shapeoko/Docs/content/index.md

#Assembly Overview

##Welcome!

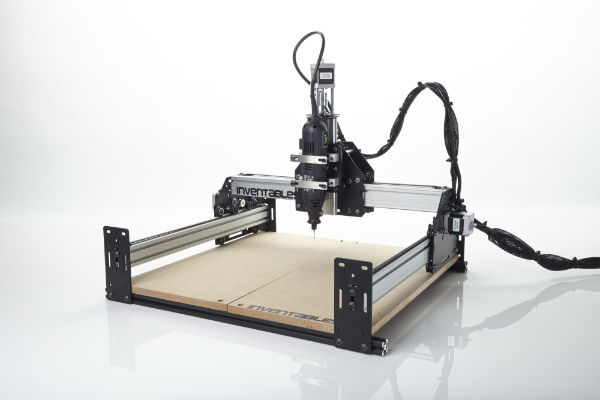
[picture p24: content/tPictures/shapeoko_2.jpg]
glamour photo of ShapeOko 2 front right diagonal


Thank you for being involved in Project Shapeoko, an open source CNC machine which may be used for milling, lasercutting, 3D printing, cutting fabric, etc. 

This is the site for the Shapeoko 2 instructions. For other versions, including the Shapeoko 3, [please see the wiki which includes documentation and assembly instruction and other information for the project.](http://www.shapeoko.com/wiki/index.php/Main_Page)

The Shapeoko 2 has a 12" x 12" x 2.5" work volume that can be [enlarged](http://www.shapeoko.com/wiki/index.php/Scaling_Up) and a stock precision of 1/40mm along X and Y, 1/320mm along Z.

ShapeOko is named after the **Shape**ways 3D printing and the Pon**oko** laser cutting services and was initially launched on [Kickstarter](http://www.kickstarter.com/projects/edwardrford/project-shapeoko-a-300-complete-cnc-machine?ref=live).

The following pages are filled with the information you need to assemble your Shapeoko 2 desktop CNC machine. Please read through them in advance, and make note of things to check and verify before beginning assembly. If you have any difficulties with assembly, please check the ShapeOko [wiki](http://www.shapeoko.com/wiki) and [forums](http://www.shapeoko.com/forum/index.php).

###A note on diagrams

Where possible, diagrams and illustrations are linked to larger versions which should fill your browser window. Most of the parts diagrams are in SVG format which will allow you to magnify them if using a tablet which supports such. When the SVG diagrams are opened in a browser window, they are interactive --- clicking on the parts list text will highlight the matching part(s) in the diagram). Please note that each SVG diagram comes in two versions, one intended for viewing *in situ* at a typical size, the other, with a suffix of "-100" which is set to fill a browser window --- each image's link is of course to that latter version.

**Please note:** there is a page on [assembly troubleshooting](http://www.shapeoko.com/wiki/index.php/Assembly_troubleshooting) on the wiki. If you've followed the instructions and nothing seems to match up on the wiki, please contact [help@inventables.com](mailto:help@inventables.com) and they will help you get everything sorted.

###A note on safety

_Never operate the machine without adequate safety gear for the current task. Never reach into the machine's operating envelope while it is running. Always have a means of safely disabling the machine's motion and spindle. Never leave the machine operating un-attended. There is an [operating checklist](http://www.shapeoko.com/wiki/index.php/Operating\_Checklist) which should always be followed._

##Getting Started

Please read through the assembly instructions in their entirety. If you have any questions or concerns or problems, please post a question on [the project forum](http://www.shapeoko.com/forum/viewforum.php?f=10). Lots of people, from diverse backgrounds, many with no prior CNC or woodworking or machining experience have successfully assembled and operated machines. Like most things in life, what one gets out of it, reflects the effort and preparation and patience which one exerts.

It might be helpful to watch an [assembly video](https://www.youtube.com/watch?v=42wzq5vG5rU) (also linked to from the [wiki](http://www.shapeoko.com/wiki/index.php/ShapeOko_2#Assembly_Video)) --- there are a number of others, some of which are on the [Hello World](http://www.shapeoko.com/wiki/index.php/Hello_World) page.

###Overview

1. Review the parts in your kit and make sure you have read and understand and will be able to follow all of the instructions
2. Read the [Pro Tips](tips.html) and make sure you have all the required [Tools](tips.html#Tools)
3. Install your [Software](software.html)
4. Test Your [Electronics](electronics.html)
5. Review the [Wiring Options](wiring.html)
6. Assemble your machine ([Wheels](wheels.html), [Carriages](carriages.html), [Z-axis](zaxis.html), [Gantry](gantry.html), [Y-axis](yaxis.html), [Work Area](workarea.html), and [Electrical Wiring](wiring.html))
7. Run [Hello, World!](helloworld.html)
8. Run your [First Job!](firstjob.html)

###Contributing

If you are interested in contributing to the docs pages, please see [this page](contribute.html) for information on how to get started.

##Assembly Steps

The first thing to do is to compare what you have received with the inventory sheet included with your kit. For reference, there is also a [B.O.M. (Bill of Materials) with sortable columns and (some) options on the wiki](http://www.shapeoko.com/wiki/index.php/BOM). Please note that part specifications / sizes may change with different kit batches, especially for aspects which do not affect functionality and fit. Also, any bags which don't have a part number and quantity should be sorted out and matched against the B.O.M. and [parts pages](http://www.shapeoko.com/wiki/index.php/Parts). Please compare one part to another (especially the MakerSlide) and check the instructions for specific things to check. If anything in your kit is found to be missing, or damaged, or not up to spec after your initial review, contact [Inventables Customer Service](https://www.inventables.com/about): [help@inventables.com](mailto:help@inventables.com) to make arrangements all-at-once for everything, so that one doesn't have to wait on multiple shipments.

If your electronics vary in any fashion from the standard parts, it is your responsibility to ensure that one doesn't damage the electronics. Please review the [Parts page on the wiki](http://www.shapeoko.com/wiki/index.php/Parts) and any other relevant documentation which is necessary for the parts which you have sourced.

##Software
[Goto the Instructions](software.html)

Before we can control our machine, we need to install and/or configure some software. If you're going to test your electronics, then you'll need to have this step done before you can complete that step. Otherwise, you'll need to complete this step before running Hello, World.

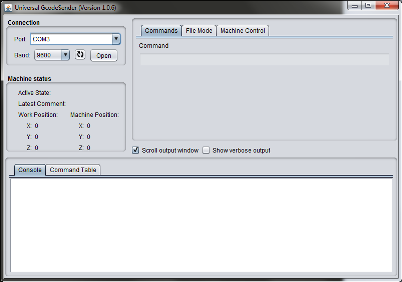
[picture p25: content/helloworld/ugs1_4.png]
Universal GCode Sender


---

##Electronics
[Goto the Instructions](electronics.html)

In this step, we will *test* our electronics setup. It's beneficial to do this prior to assembling the machine, as some issues are more easily addressed before assembly takes place. If a problem were to occur, it's much easier to troubleshoot without having to disassemble the machine!

Electronics Overview Image

---

##V-Wheels and Idlers
[Goto the Instructions](wheels.html)

A lot of the "work" required to assemble the machine is done in this step. It's not hard work, but it'll take a while. Just like long division.

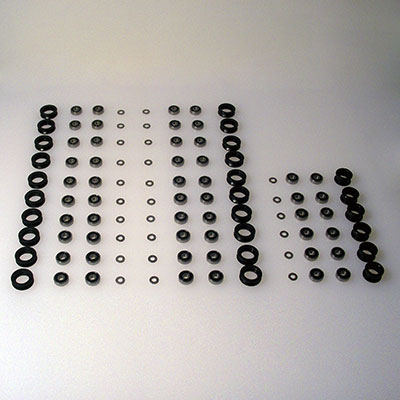
[picture p26: content/tPictures/so_vw_iw_parts_4.jpg]
wheels and idlers laid out


---

##Carriages
[Goto the Instructions](carriages.html)

This is the most labor intensive part of the assembly. You will be assembling 3 motor mount plates. Please note that before finishing this step, you must decide which wiring option you will use.

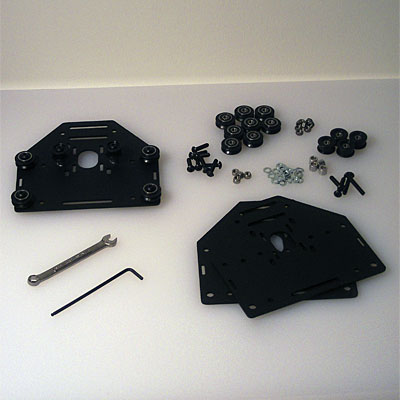
[picture p27: content/tPictures/so_motor_mount_carriages_parts_4.jpg]
exploded view of carriage


---

##Z-Axis
[Goto the Instructions](zaxis.html)

The Z-axis is comprised of 3 separate assemblies, and will require some time (and patience) to fully assemble. It will also require that you have begun tapping the MakerSlide (see the [Pro Tips](tips.html)). Once you are done with this step, your machine will really start to take shape.

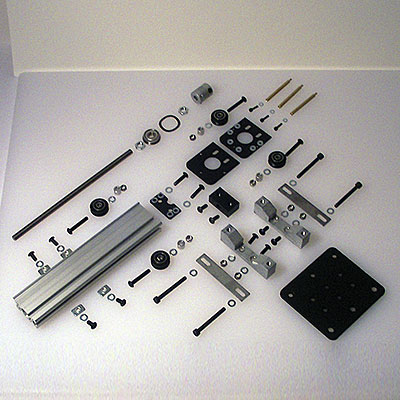
[picture p28: content/tPictures/so_z_axis_parts_4.jpg]
z-axis exploded


---

##Gantry
[Goto the Instructions](gantry.html)

The gantry continues the process of taking assemblies and combining them. You will have needed to finish tapping two pieces of MakerSlide before beginning this step.

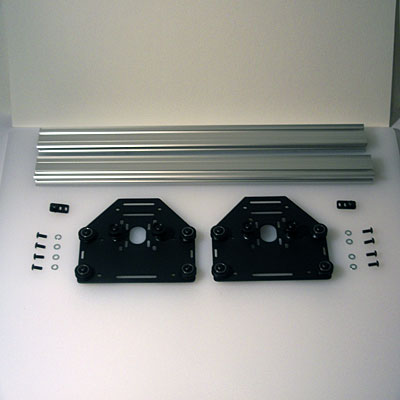
[picture p29: content/tPictures/so_gantry_parts_4.jpg]
Gantry Image


---

##Y-Axis
[Goto the Instructions](yaxis.html)

The Y-axis makes up the frame of the machine along with the last component in the next step. You will have needed to finish tapping the last two pieces of MakerSlide before beginning this step.

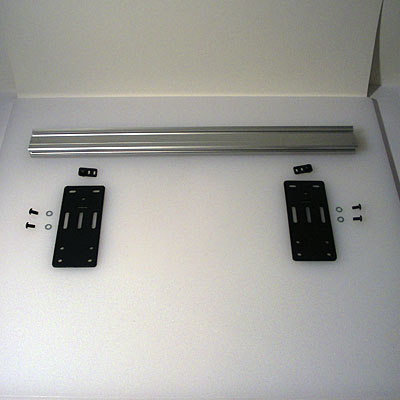
[picture p30: content/tPictures/so_y_axis_rail_parts_4.jpg]
Y Axis Image


---

##Work Area
[Goto the Instructions](workarea.html)

The work area integrates the last component with the previous assemblies, completing the mechanicals of the machine.

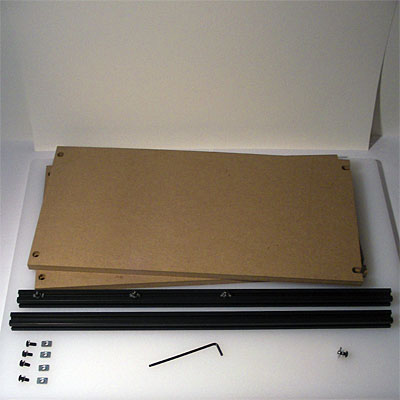
[picture p31: content/tPictures/so_waste_board_parts_4.jpg]
Work Area


---

##Electrical Wiring
[Goto the Instructions](wiring.html)

The machine is complete when the electronics are wired up to the motors, and the belts are installed, allowing movement. One must make a decision about which wiring option one will use before beginning to assemble the machine.

---

##Hello, World
[Goto the Instructions](helloworld.html)

Your very first run!

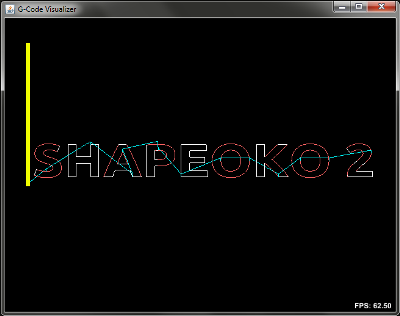
[picture p32: content/helloworld/ugs_visualize_4.png]
Hello World


---

##First Job
[Goto the Instructions](firstjob.html)

A basic introduction to using the machine for milling.

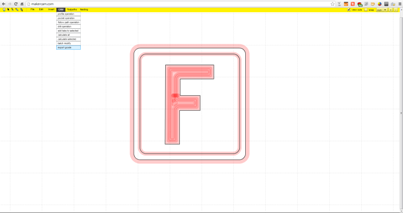
[picture p33: content/firstjob/mc_export_4.png]
first job


###Next step [Pro Tips!](tips.html)

To express concerns, post on the [forums](http://www.shapeoko.com/forum/index.php) in a suitable topic.
