shapeoko/Docs/content/oPictures/so_gantry_half_carriage_parts.JPG

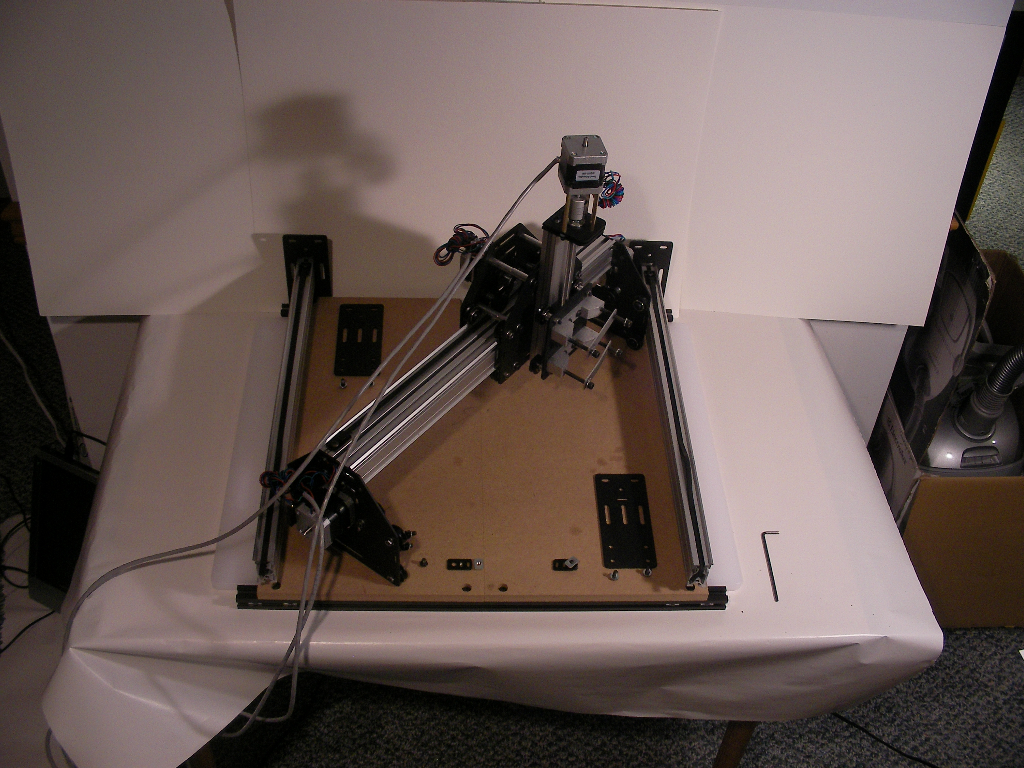
content/oPictures/so_gantry_half_carriage_parts.JPG
