shapeoko/Docs/content/oPictures/so_gantry_parts_tool.JPG

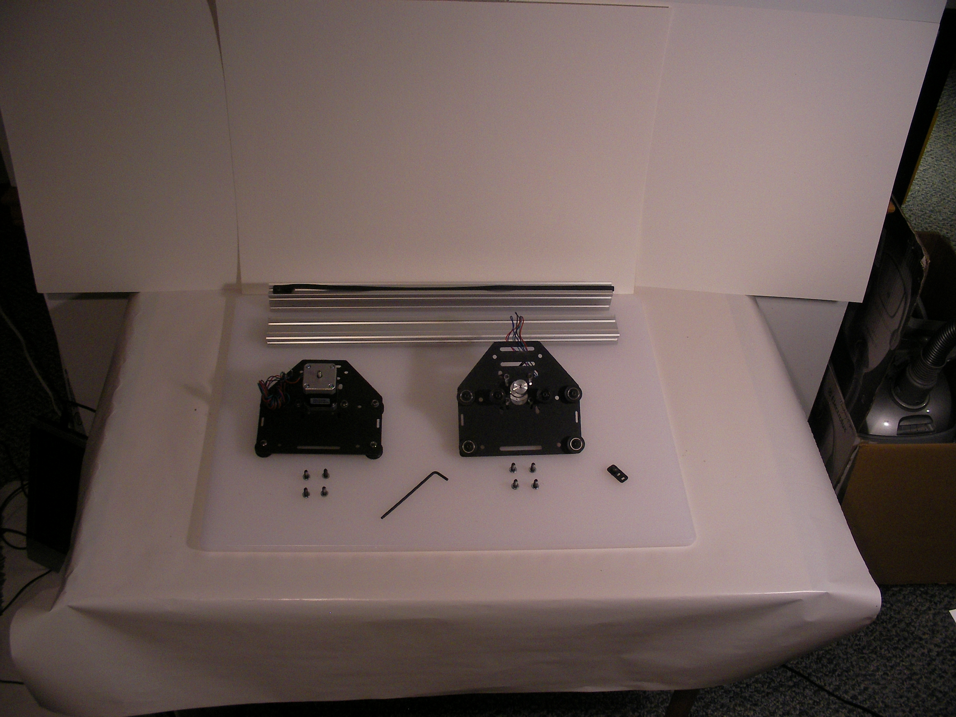
content/oPictures/so_gantry_parts_tool.JPG
