shapeoko/Docs/content/oPictures/so_wasteboard_y_axis_parts.JPG

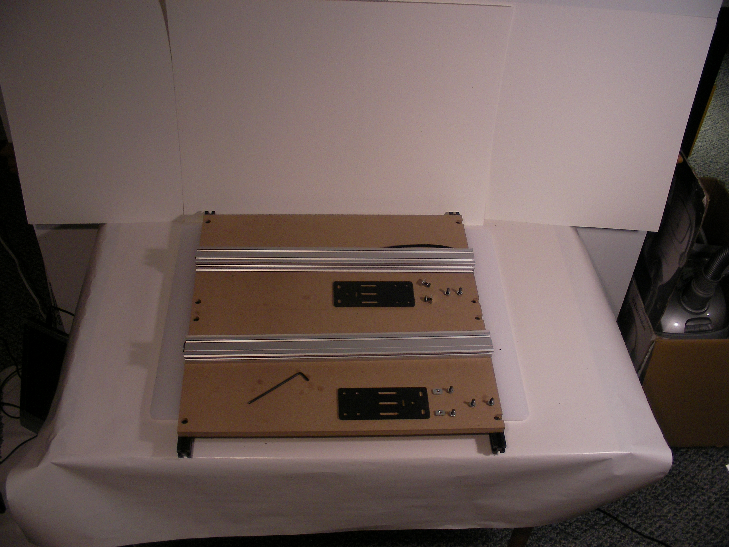
content/oPictures/so_wasteboard_y_axis_parts.JPG
