shapeoko/Docs/content/tPictures/so_motor_mount_carriage_parts_16.jpg

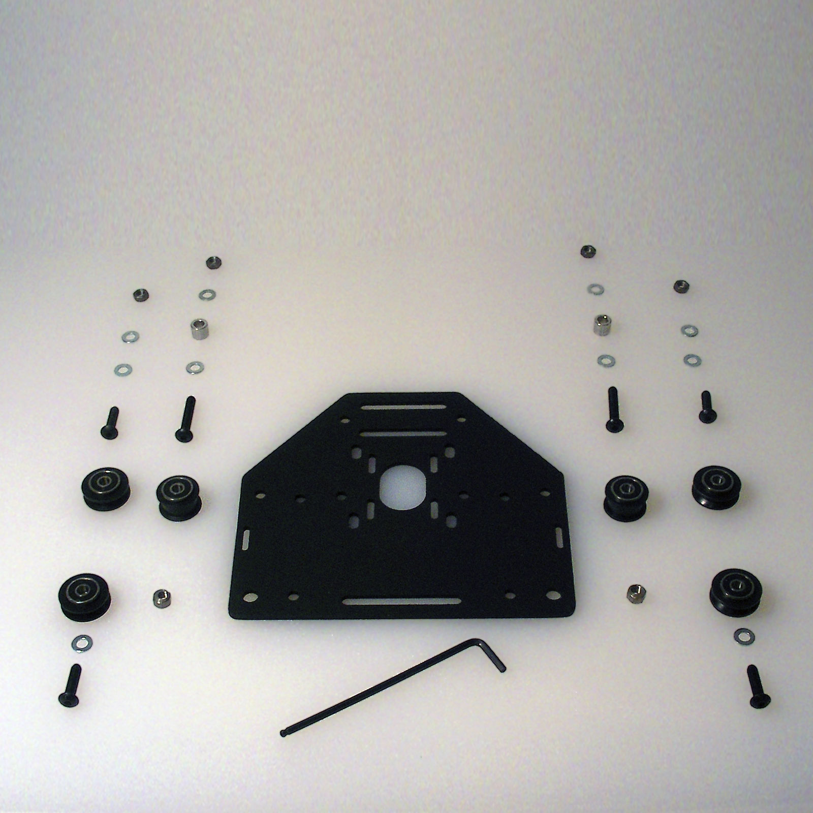
content/tPictures/so_motor_mount_carriage_parts_16.jpg
