shapeoko/Docs/content/tPictures/so_wiring_terminalblocks_parts_8.jpg

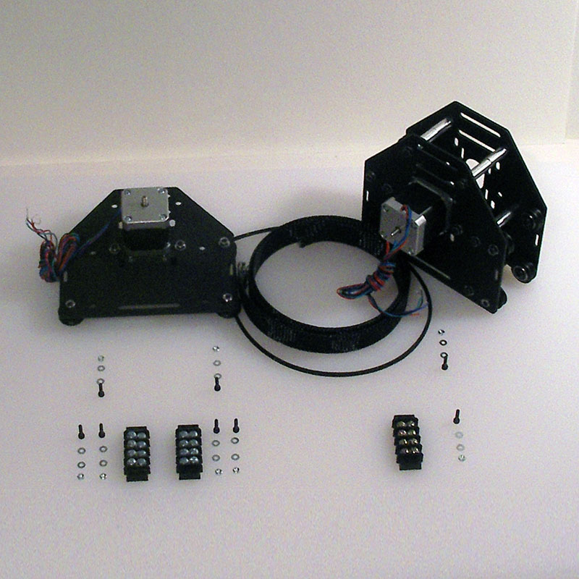
content/tPictures/so_wiring_terminalblocks_parts_8.jpg
