shapeoko/Docs/content/wiring.md

# Electrical Wiring

## Overview

schematic

The ShapeOko 2 electrical wiring is, like the rest of the machine, decided upon by the user. There are 3 documented options to wire the machine easily. Each option has been broken out into a separate page for clarity. Depending on your setup, and skill set, one option may be better for you than another (or you may want to work up a totally different option which is suited to your needs --- one word of warning, you will see photos of machines which have terminal blocks or wiring directly connected to the stepper motors --- this is potentially unsafe, since the motors may heat up to the point of deforming the plastic of the terminal block allowing a wire to come loose). 

Chose your option by evaluating the requirements of your machine, its ultimate size ([if scaling up](http://www.shapeoko.com/wiki/index.php/Scaling_Up)), how you intend to use it and your skill-set and available tools and aesthetic. While the default ShapeOko 2 size can make use of expandable braiding to manage the wiring, you may wish to look at other [cable management options](http://www.shapeoko.com/wiki/index.php/Cable_Management).

If you tested your electronics with terminal blocks it might suffice to merely detach the grey stepper motors from them, but it would probably be better to disconnect them completely, check the wiring carefully and re-strip any leads with broken wires.

**Remember, stepper driver chips are fragile and may be damaged by applying power without a motor connected --- always wire things up completely, and verify all connections each time before applying power.**

## Routing

In all scenarios, your stepper wires should be initially be routed as such:

wire facing up

Please note that the Z-axis leads should come down to the X-axis motor mount carriage so as to minimize the wear on the connectors and to begin consolidating the wires.

Be careful when making connections to not confuse leads from one motor with another, especially when wiring up the reversed Y-axis.

The motor lead wiring is very fragile --- even if you have a lead connected and secured, consider the possibility that the wires may break resulting in faulty connections. Always verify the integrity of all connections (and mechanical connectors) before operating the machine.

---

## Option #1 - Soldering

This is the direct wire method that requires (modest) soldering skills to complete (and stepper motors with leads long enough to make a run all the way off the machine). You can assemble the entire machine before doing this step.

###You will need the following tools and parts to complete this option

* Soldering Iron
* Solder
* Wire Strippers
* Heat Shrink Tubing (2 sizes) (or electrical tape)
* Heat source (heat gun or (hair) blow dryer)
* Zip Ties (about a dozen)
* 4 Position Terminal Block (optional)
* Expandable braiding (2 sizes), optional

[click here to view these instructions](wiring_1.html)

## Option #2 - Terminal Blocks

This is the terminal block method. This method is easy (no soldering or other special skills), but requires that you make preparations **WHILE** you are assembling the machine (attaching the terminal blocks to the carriages), or come up with some alternative technique for mounting the terminal blocks. While it is possible to attach the terminal blocks after assembly, it is very difficult and potentially frustrating, far better to do it in advance. It is especially well-suited for machines which will be scaled up in size, or for motors which have short leads.

###You will need the following tools and parts to complete this option

* Screw Driver
* Zip Ties
* Expandable Braiding
* Heat shrink tubing
* Heat source (heat gun or (hair) blow dryer)
* 4 Position Terminal Block x 3 pcs.
* 4-conductor wire (shielded, in addition to the 4 color-coded copper conductors there is a steel "drain wire" which may _optionally_ be connected to ground at the controller end, but should be trimmed off with the shielding at the motor end)
* Razor Blade (wire stripper)

The following are used to mount the terminal blocks, but zip ties (or foam adhesive picture mounting strips) may be used instead.

* 2.5mm Hex key
* 5.5mm wrench
* M3 x 16mm Socket Head Cap Screw (SHCS) x 6 pcs.
* M3 flat washer x 12 pcs.
* M3 hex nut x 6 pcs.

[click here to view these instructions](wiring_2.html)

## Option #3 - Experimental!

This is the 'mount the controller on the machine' method. It's experimental, it's untested, it's **hot**. You can assemble the entire machine before doing this step. If you venture down this path, you're an explorer, and may be on your own. It might be worth it.

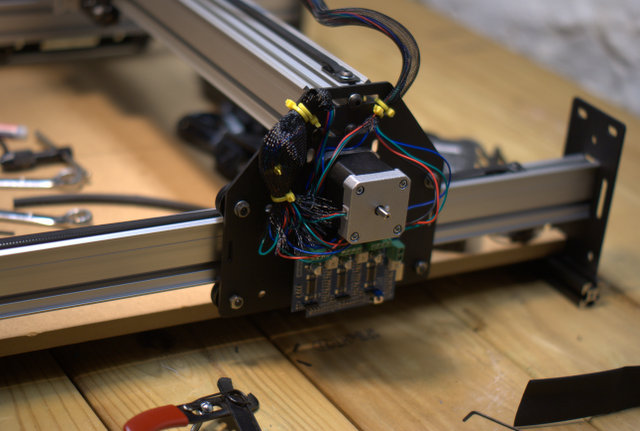
[picture p154: content/wiring/68-so_wiring-067.jpg]
mtcotm


###You will need the following to complete this option

* Zip Ties
* Expandable Braiding (2 sizes)
* Razor Blade (wire strippers)
* Bravery & Courage

[click here to view these instructions](wiring_3.html)

**Note:

Shielded cable will include a "drip wire" which may be grounded at the controller end (see the documentation for your controller or consult the [wiki](http://www.shapeoko.com/wiki/index.php/Electronics#Grounding)) --- the other end should be removed so as to preclude ground loops.

---

To express concerns, post on the [forums](http://www.shapeoko.com/forum/index.php), to suggest improvements without using github, edit [this wiki page](http://www.shapeoko.com/wiki/index.php?title=Wiring_1&action=edit&redlink=1).
