shapeoko/Docs/content/arduino/arduino_install_options_windows.png

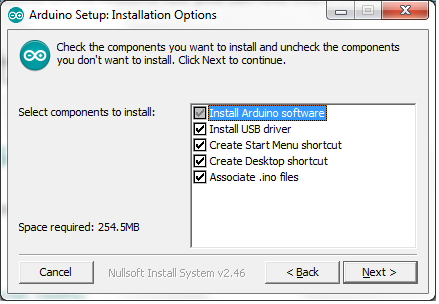
content/arduino/arduino_install_options_windows.png
