shapeoko/Docs/content/arduino/arduino_installing_windows.png

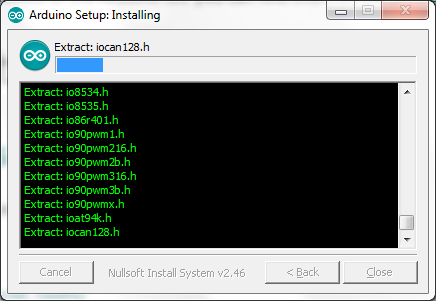
content/arduino/arduino_installing_windows.png
