shapeoko/Docs/content/arduino/failed_install.png

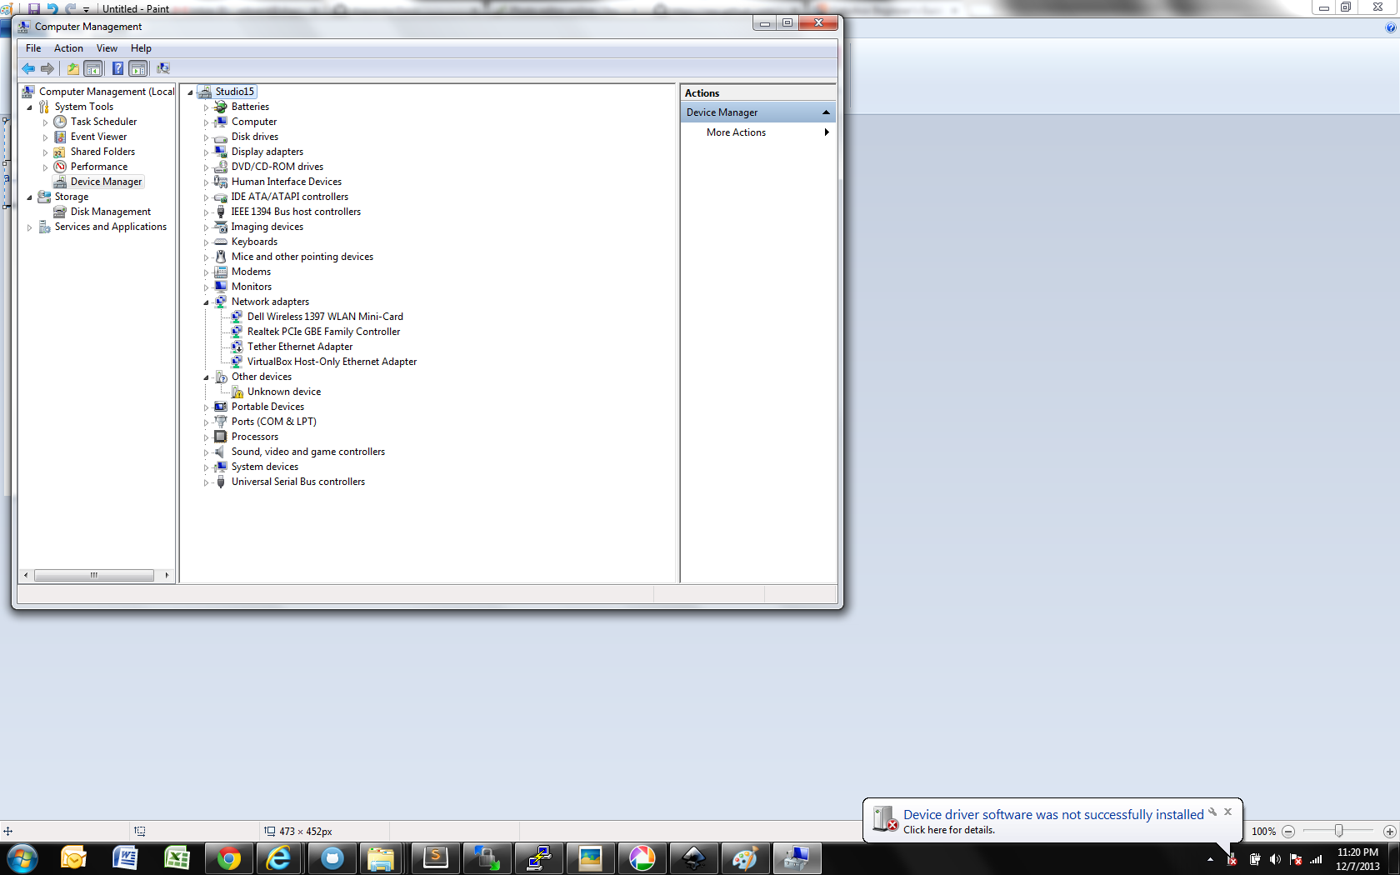
content/arduino/failed_install.png
