shapeoko/Docs/content/arduino/installing_arduino.png

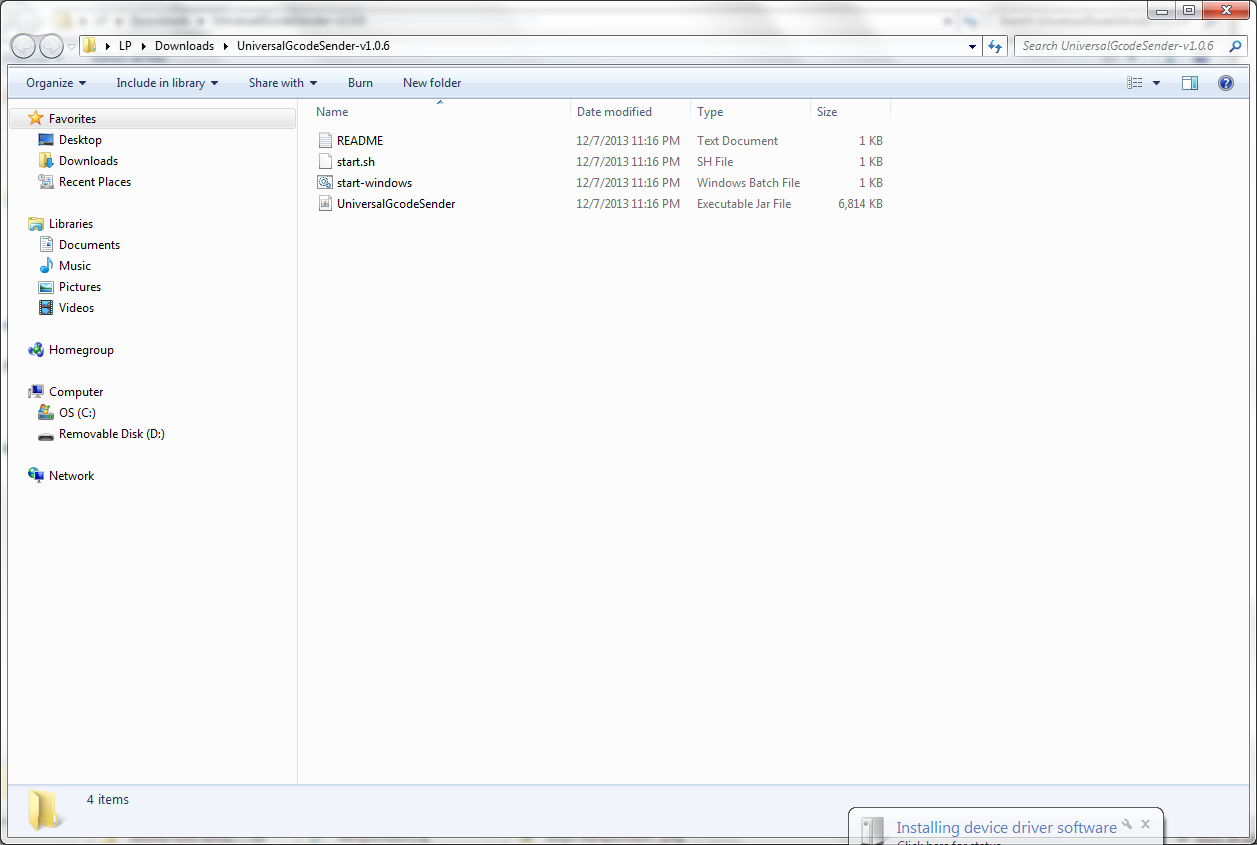
content/arduino/installing_arduino.png
