shapeoko/Docs/content/arduino/trus_install_windows.png

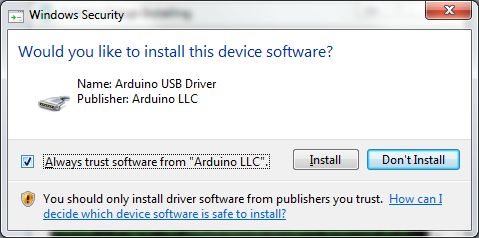
content/arduino/trus_install_windows.png
