shapeoko/Docs/content/belt-routing/66-so_wiring-065.jpg

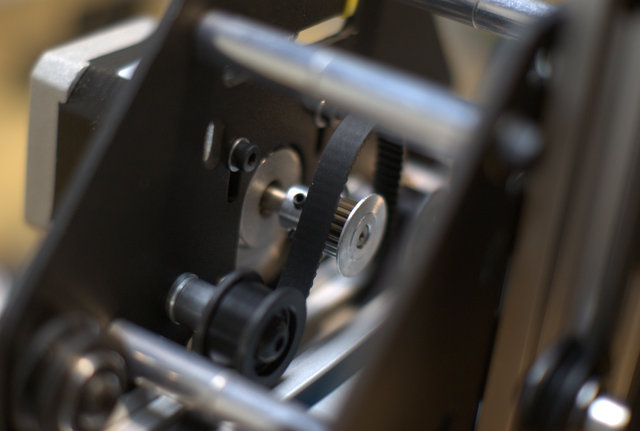
content/belt-routing/66-so_wiring-065.jpg
