shapeoko/Docs/content/oPictures/gonzoBuildImages/IMG_0174.JPG

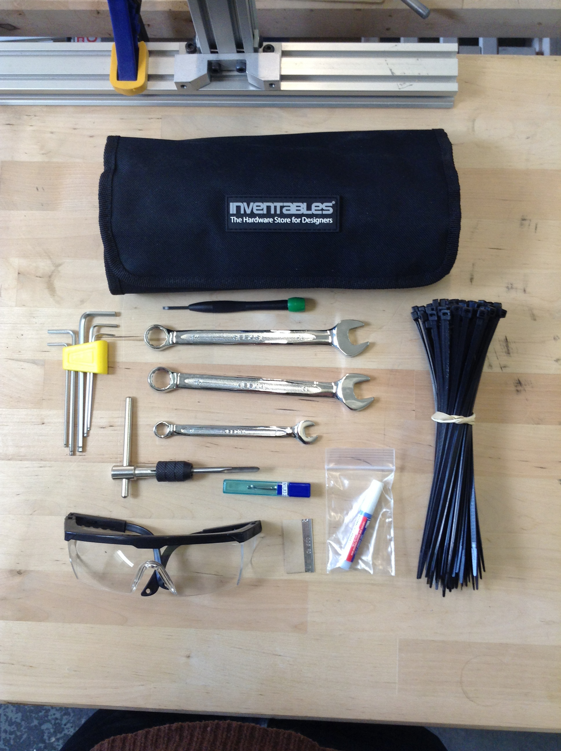
content/oPictures/gonzoBuildImages/IMG_0174.JPG
