shapeoko/Docs/content/oPictures/gonzoBuildImages/IMG_0175.JPG

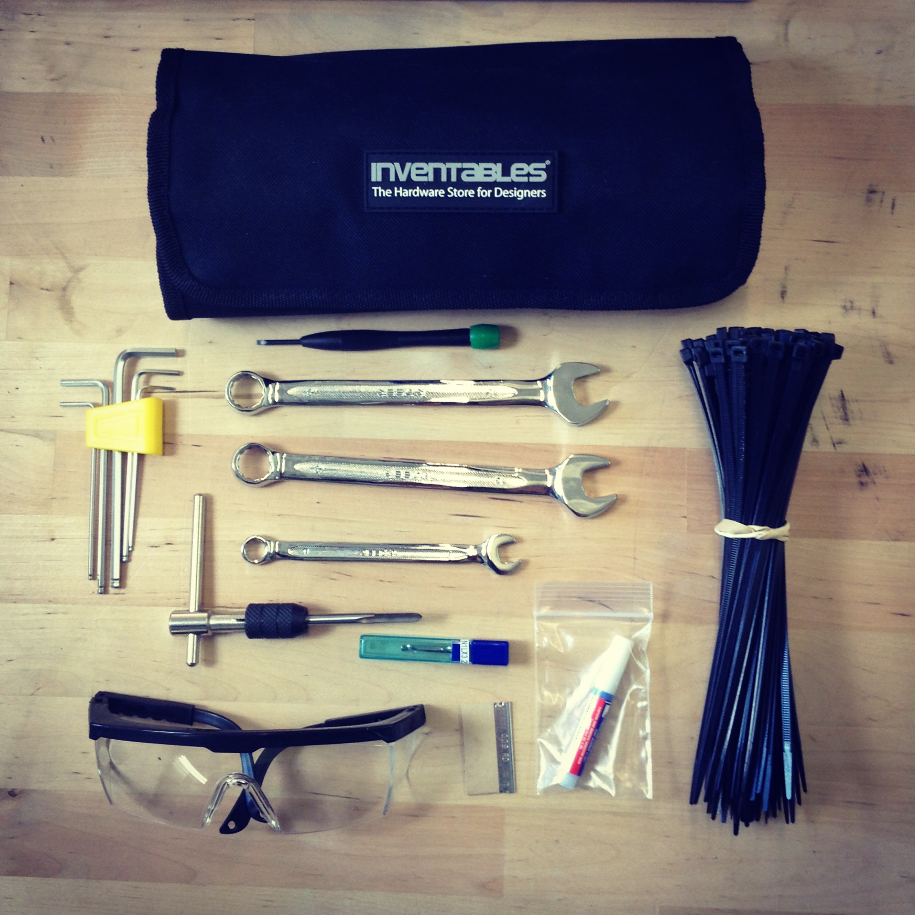
content/oPictures/gonzoBuildImages/IMG_0175.JPG
