shapeoko/Docs/content/oPictures/gonzoBuildImages/IMG_0176.JPG

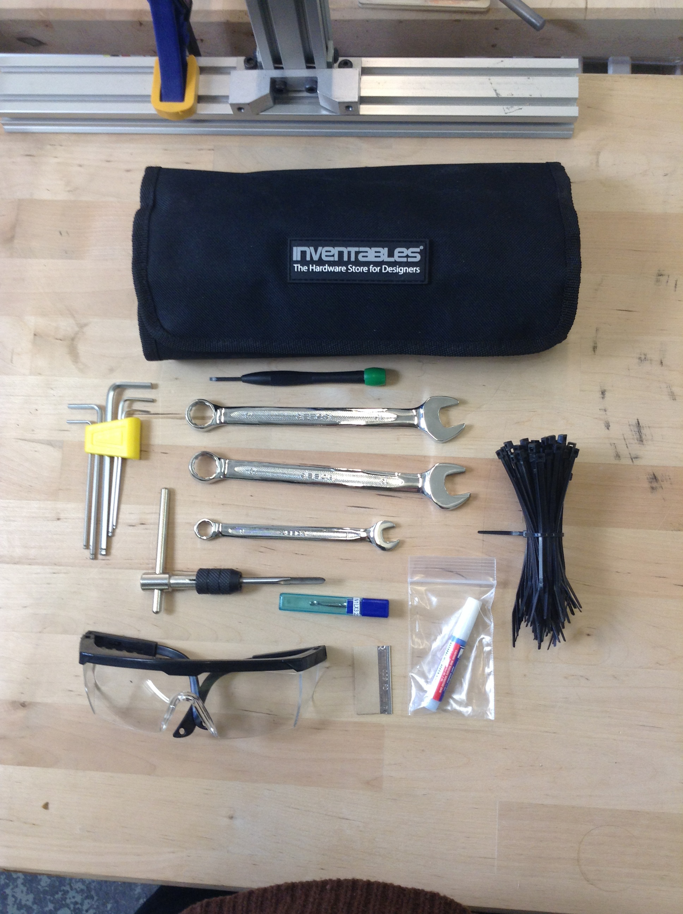
content/oPictures/gonzoBuildImages/IMG_0176.JPG
