shapeoko/Docs/content/oPictures/gonzoBuildImages/IMG_0177.JPG

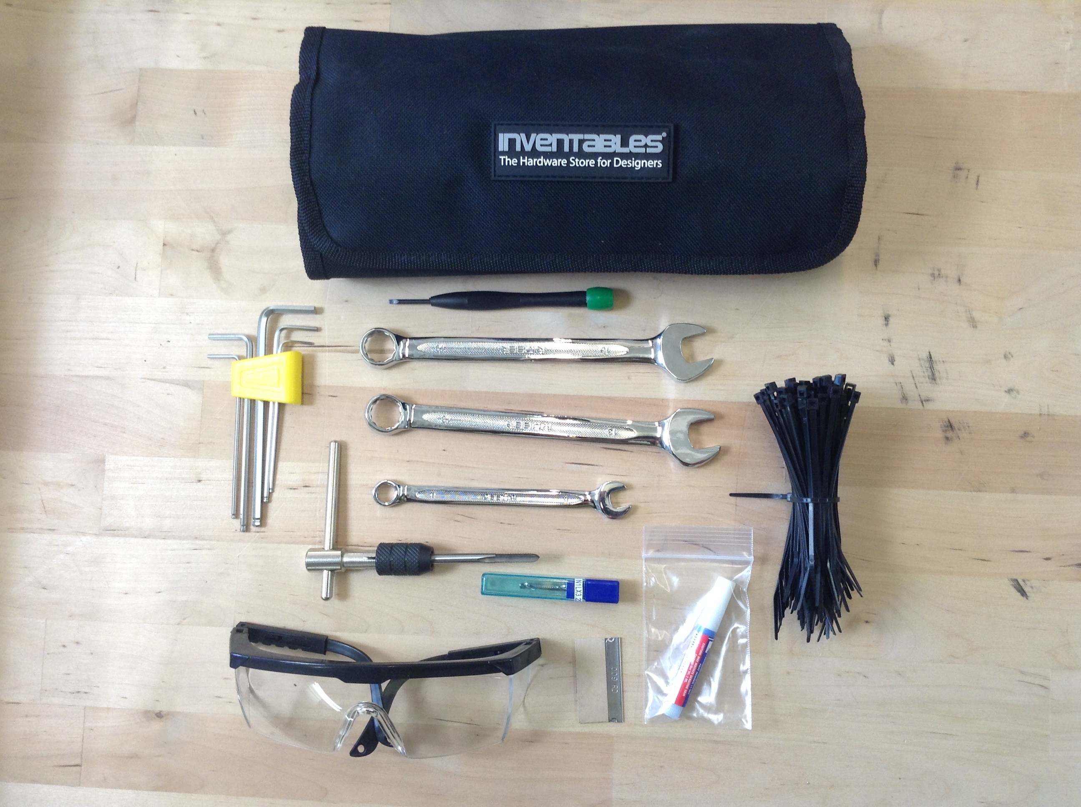
content/oPictures/gonzoBuildImages/IMG_0177.JPG
