shapeoko/Docs/content/oPictures/gonzoBuildImages/IMG_0178.JPG

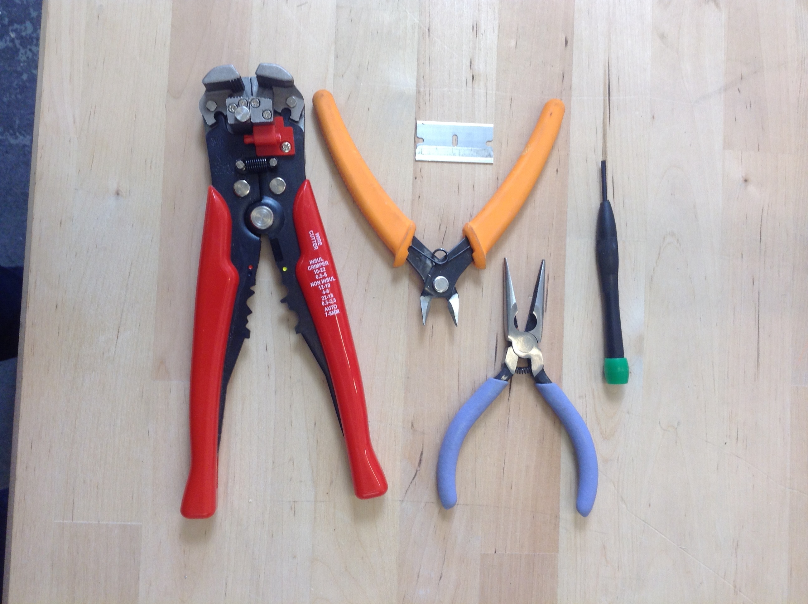
content/oPictures/gonzoBuildImages/IMG_0178.JPG
