shapeoko/Docs/content/oPictures/gonzoBuildImages/IMG_0179.JPG

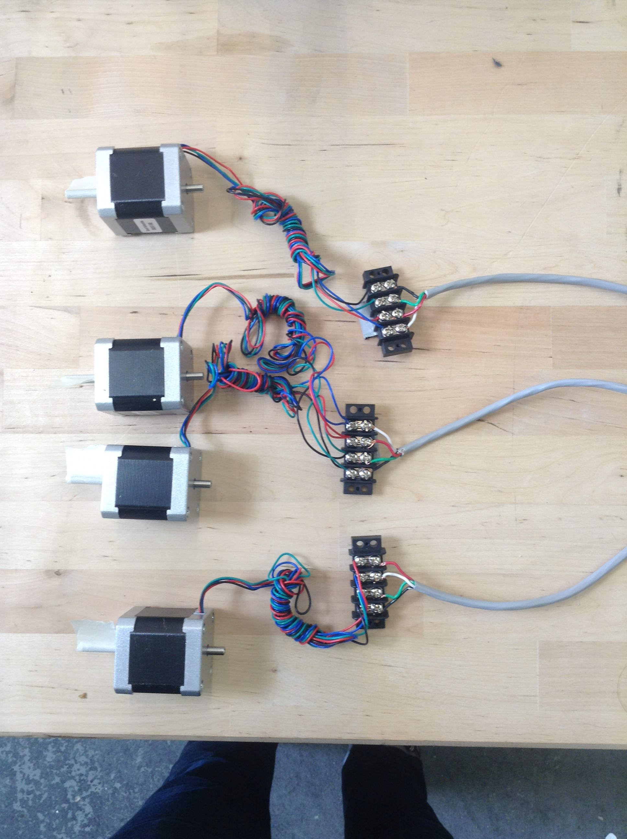
content/oPictures/gonzoBuildImages/IMG_0179.JPG
