shapeoko/Docs/content/oPictures/gonzoBuildImages/IMG_0182.JPG

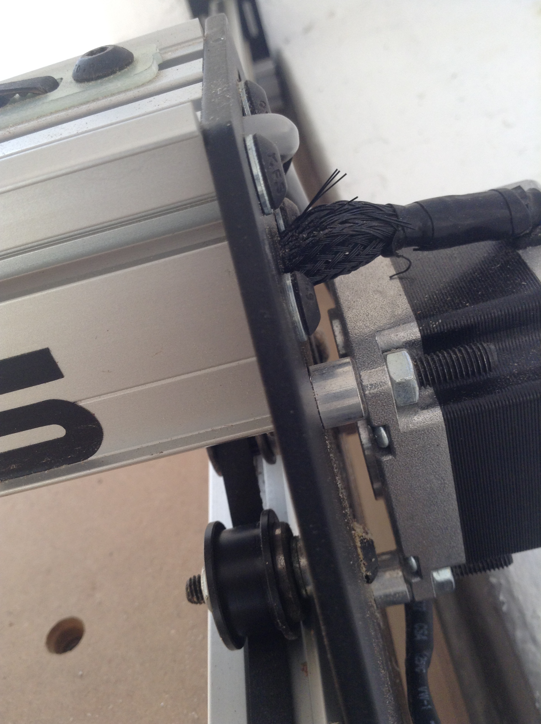
content/oPictures/gonzoBuildImages/IMG_0182.JPG
