shapeoko/Docs/content/oPictures/gonzoBuildImages/IMG_0183.JPG

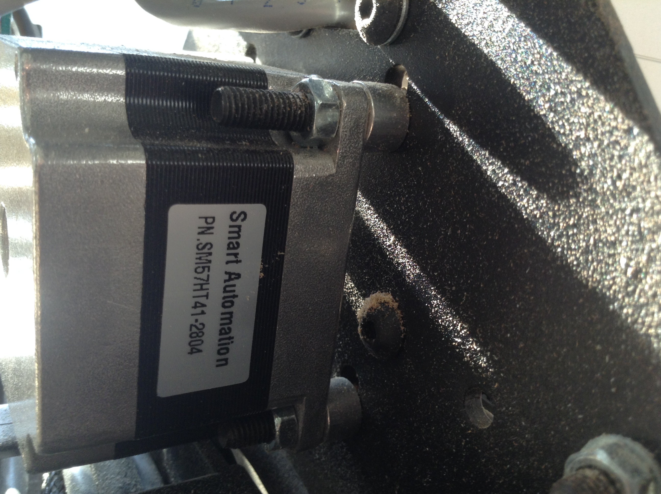
content/oPictures/gonzoBuildImages/IMG_0183.JPG
