shapeoko/Docs/content/oPictures/gonzoBuildImages/IMG_0185.JPG

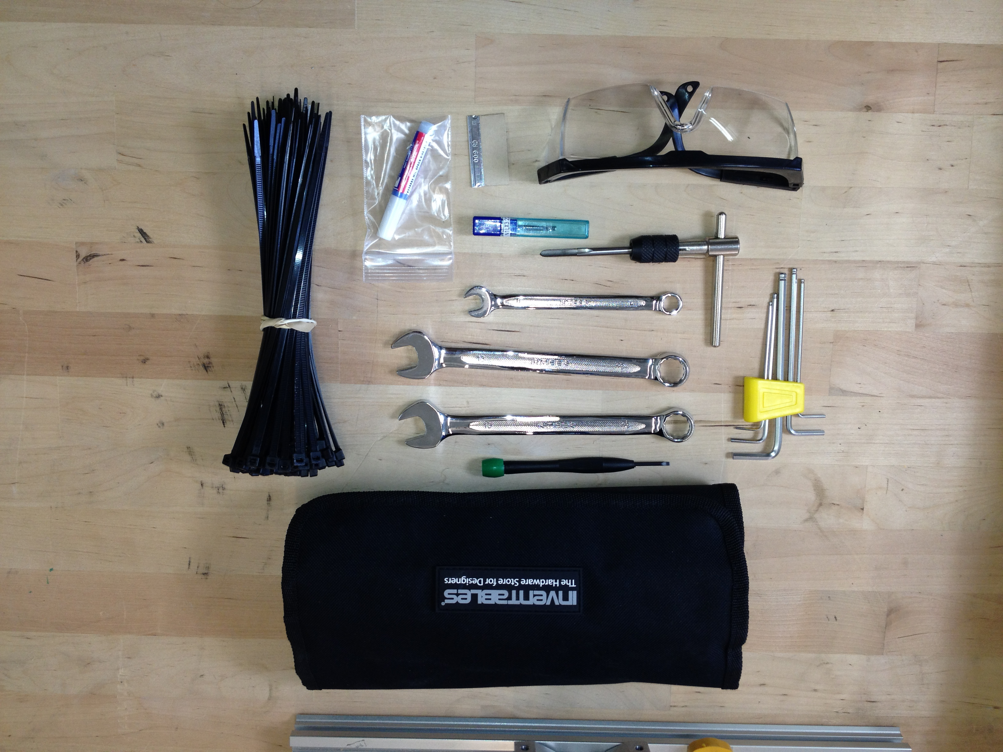
content/oPictures/gonzoBuildImages/IMG_0185.JPG
