shapeoko/Docs/content/oPictures/gonzoBuildImages/IMG_0185a.JPG

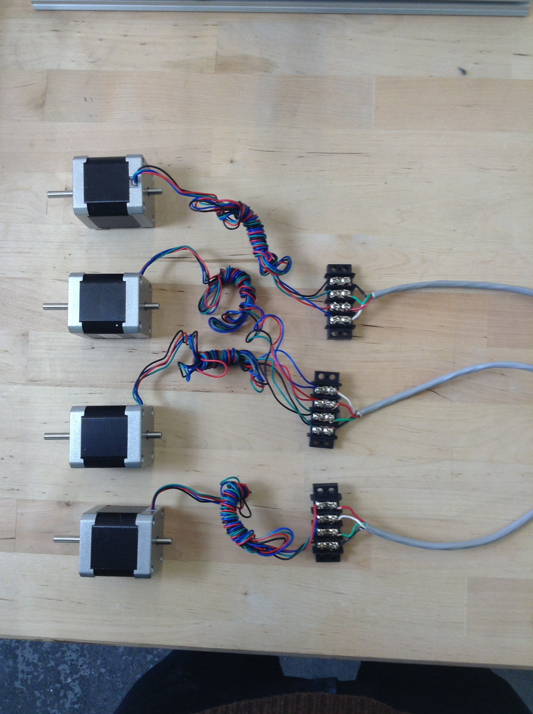
content/oPictures/gonzoBuildImages/IMG_0185a.JPG
