shapeoko/Docs/content/oPictures/gonzoBuildImages/IMG_0186.JPG

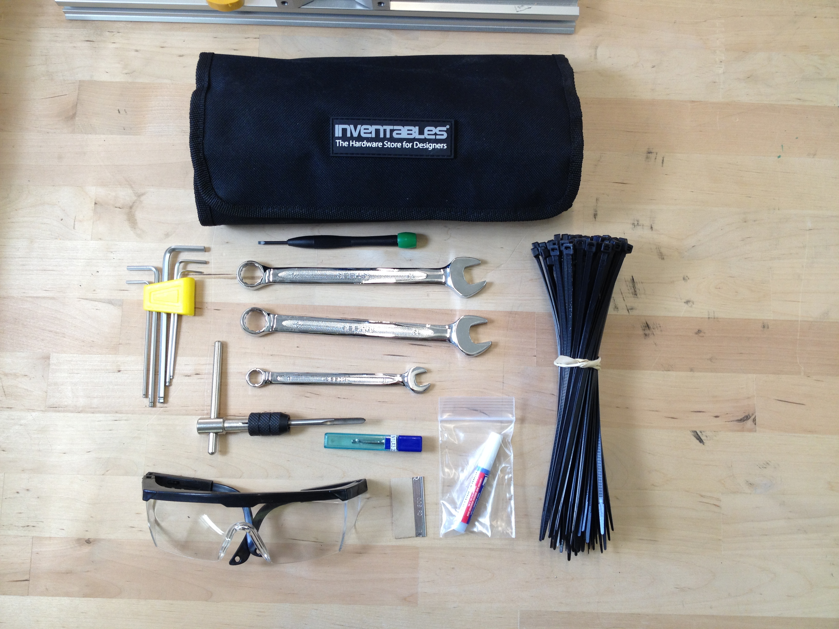
content/oPictures/gonzoBuildImages/IMG_0186.JPG
