shapeoko/Docs/content/oPictures/gonzoBuildImages/IMG_0186a.JPG

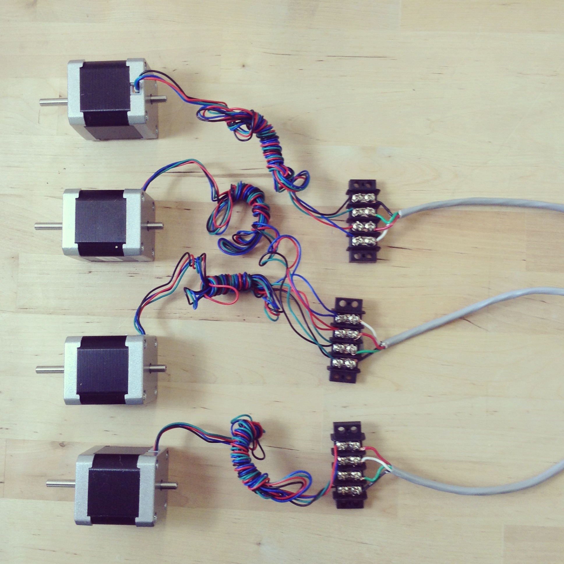
content/oPictures/gonzoBuildImages/IMG_0186a.JPG
