shapeoko/Docs/content/oPictures/gonzoBuildImages/IMG_0187.JPG

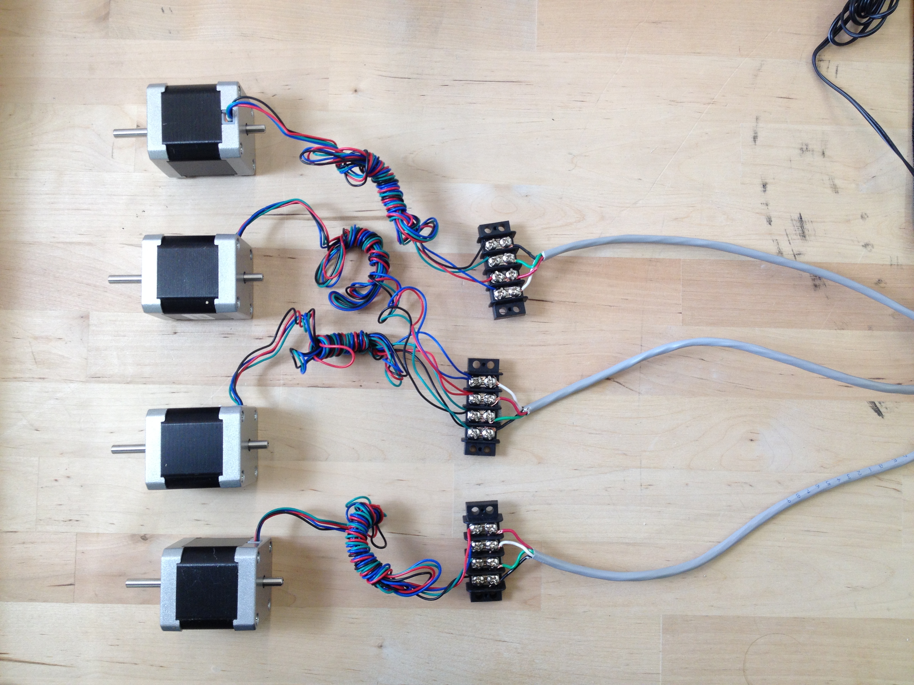
content/oPictures/gonzoBuildImages/IMG_0187.JPG
