shapeoko/Docs/content/oPictures/gonzoBuildImages/IMG_0187a.JPG

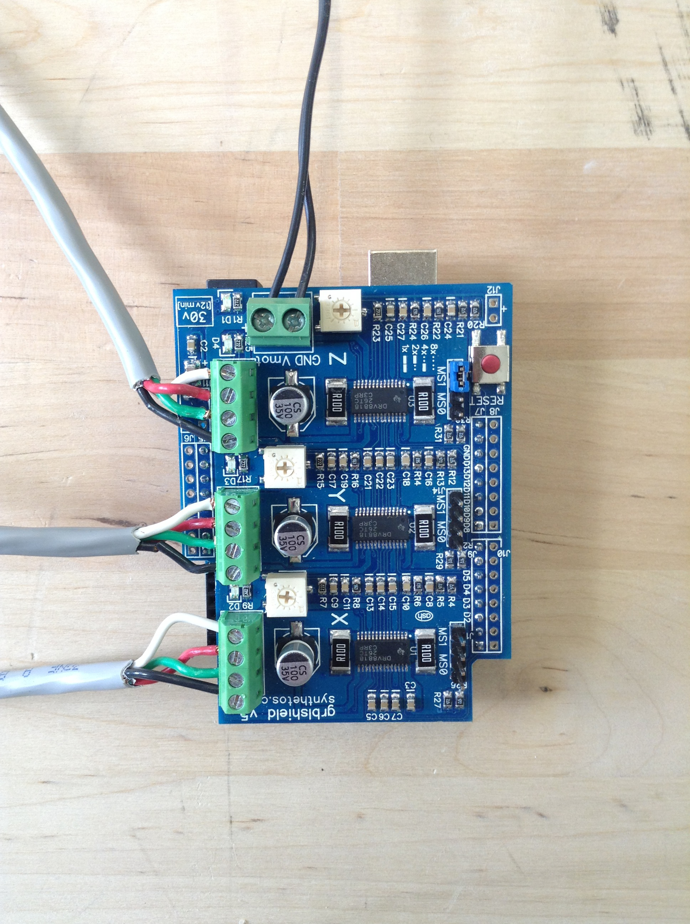
content/oPictures/gonzoBuildImages/IMG_0187a.JPG
