shapeoko/Docs/content/oPictures/gonzoBuildImages/IMG_0188.JPG

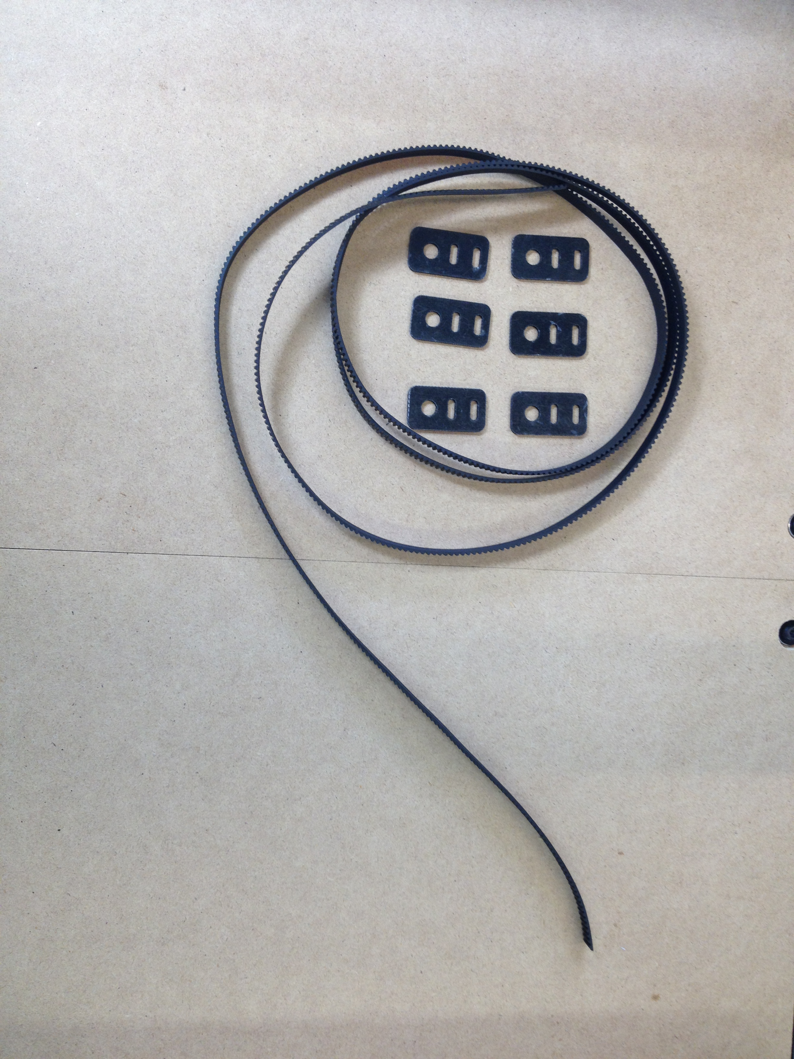
content/oPictures/gonzoBuildImages/IMG_0188.JPG
