shapeoko/Docs/content/oPictures/gonzoBuildImages/IMG_0189.JPG

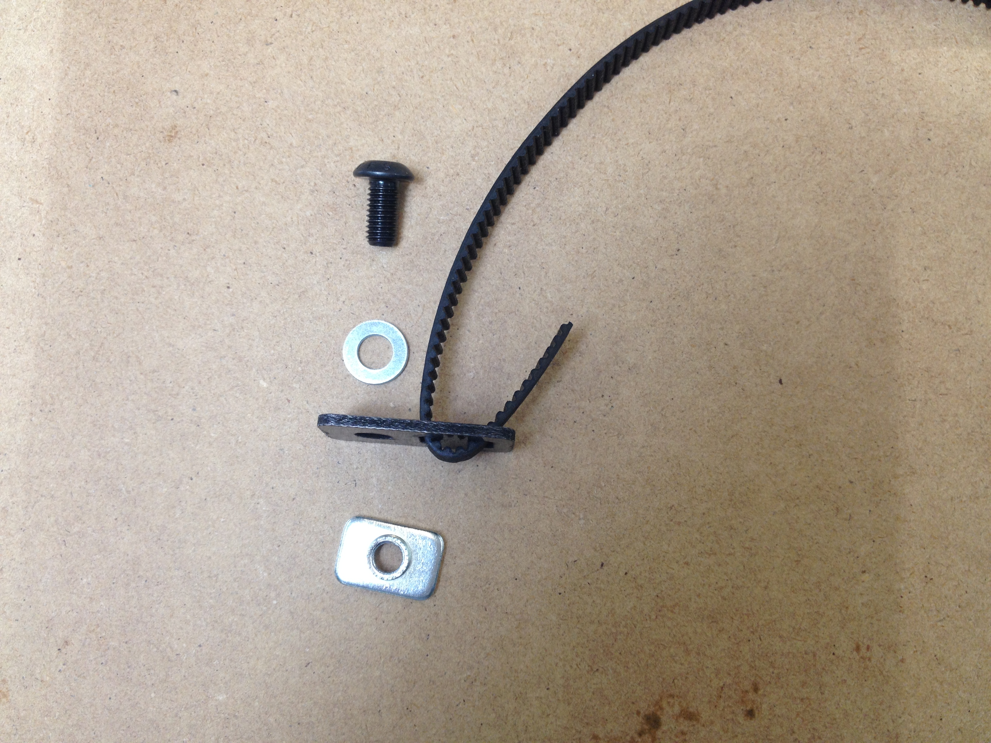
content/oPictures/gonzoBuildImages/IMG_0189.JPG
