shapeoko/Docs/content/oPictures/gonzoBuildImages/IMG_0189a.JPG

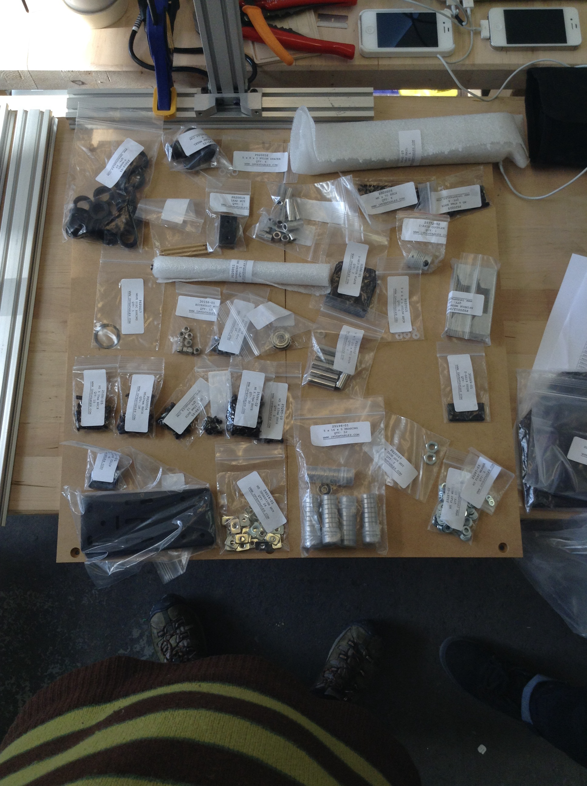
content/oPictures/gonzoBuildImages/IMG_0189a.JPG
