shapeoko/Docs/content/oPictures/gonzoBuildImages/IMG_0190a.JPG

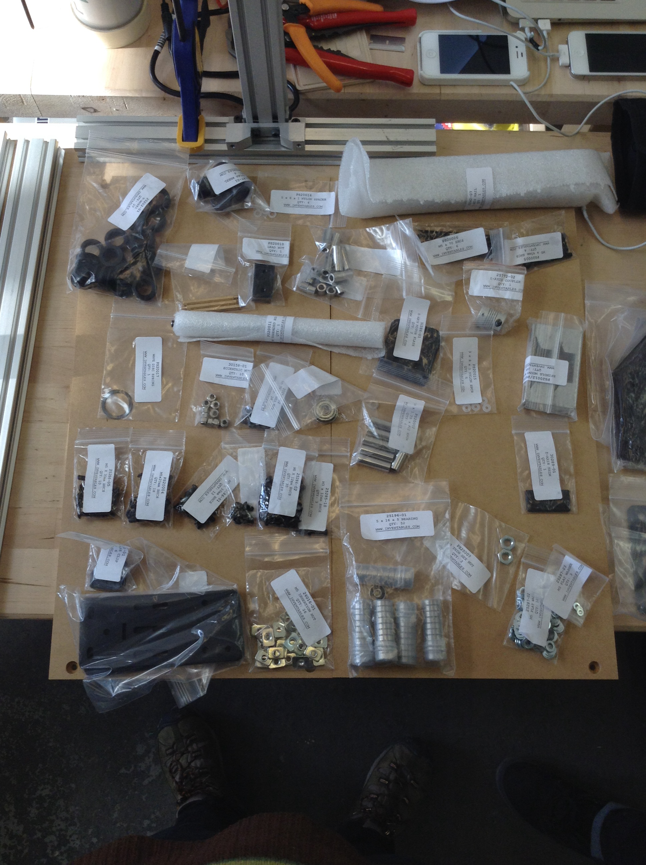
content/oPictures/gonzoBuildImages/IMG_0190a.JPG
