shapeoko/Docs/content/oPictures/gonzoBuildImages/IMG_0191.JPG

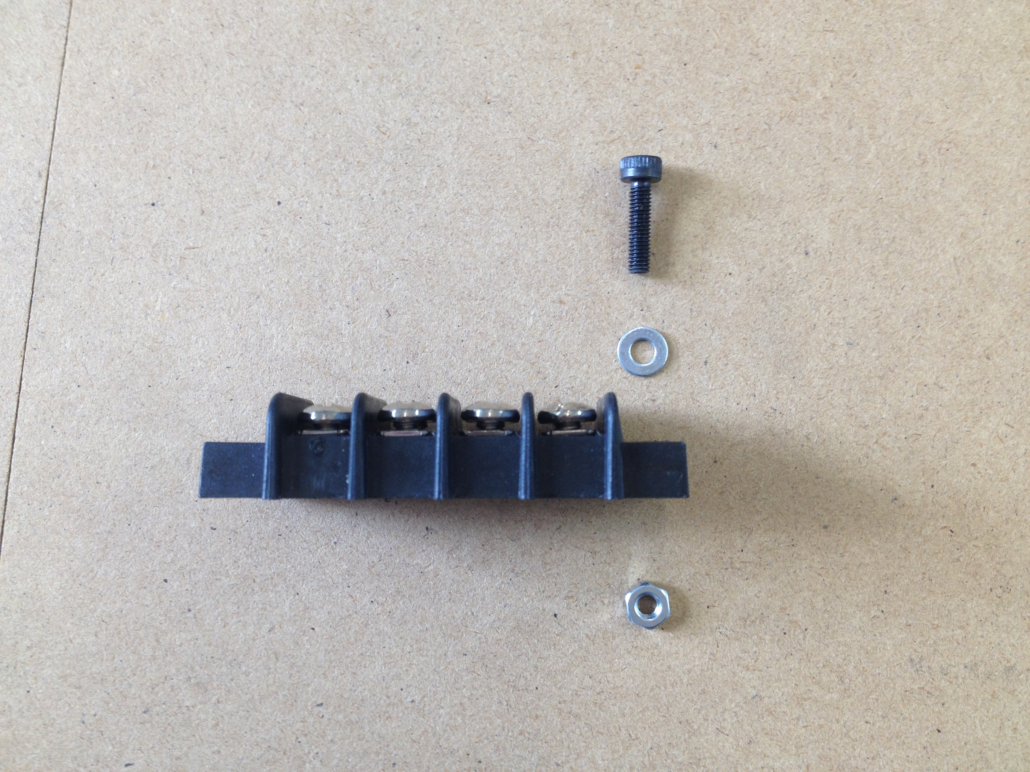
content/oPictures/gonzoBuildImages/IMG_0191.JPG
