shapeoko/Docs/content/oPictures/gonzoBuildImages/IMG_0192.JPG

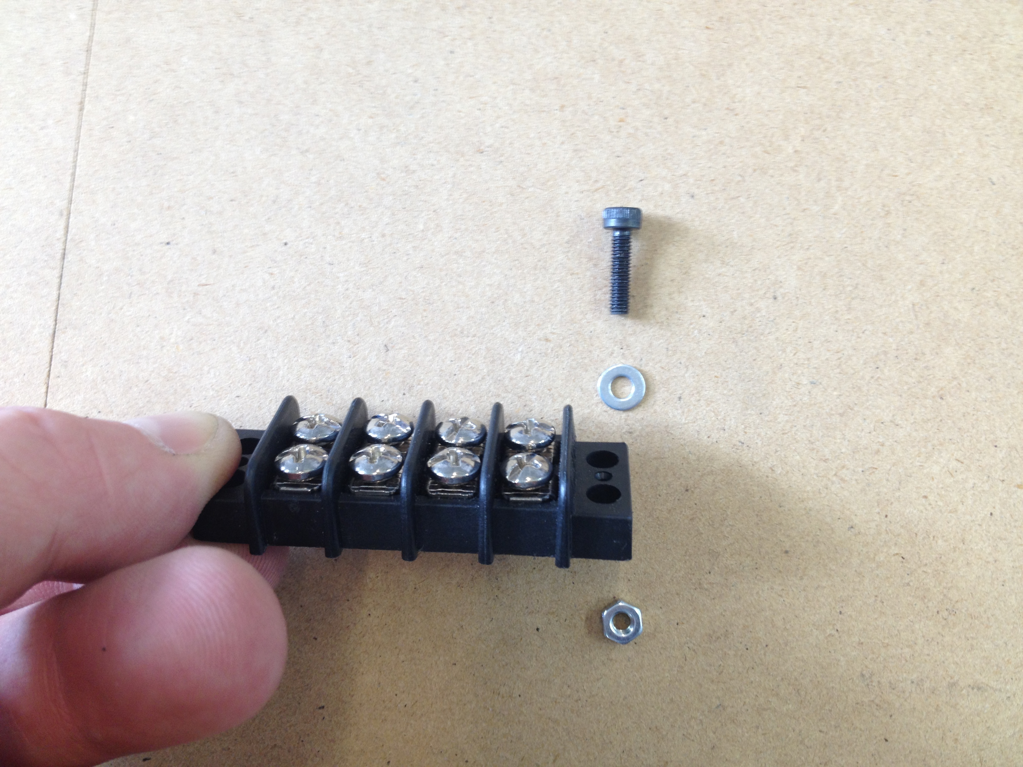
content/oPictures/gonzoBuildImages/IMG_0192.JPG
