shapeoko/Docs/content/oPictures/gonzoBuildImages/IMG_0192a.JPG

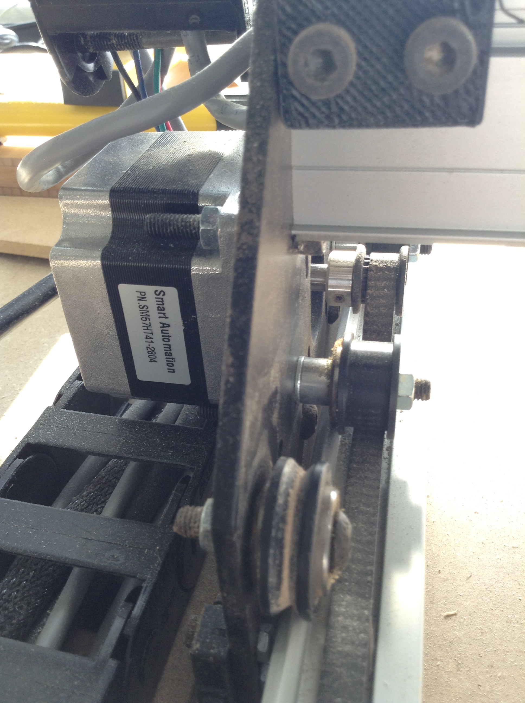
content/oPictures/gonzoBuildImages/IMG_0192a.JPG
