shapeoko/Docs/content/oPictures/gonzoBuildImages/IMG_0193a.JPG

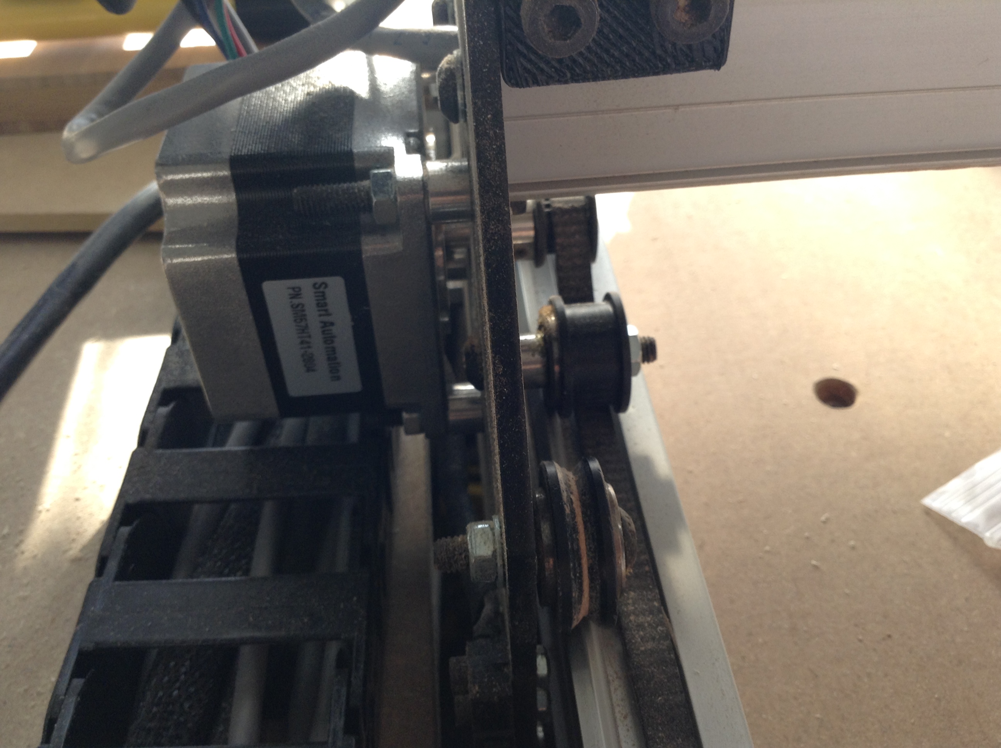
content/oPictures/gonzoBuildImages/IMG_0193a.JPG
