shapeoko/Docs/content/oPictures/gonzoBuildImages/IMG_0194.JPG

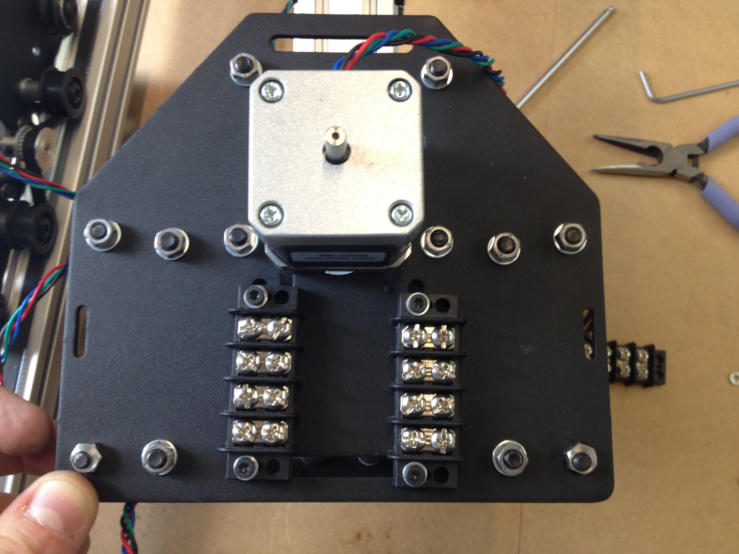
content/oPictures/gonzoBuildImages/IMG_0194.JPG
