shapeoko/Docs/content/oPictures/gonzoBuildImages/IMG_0194a.JPG

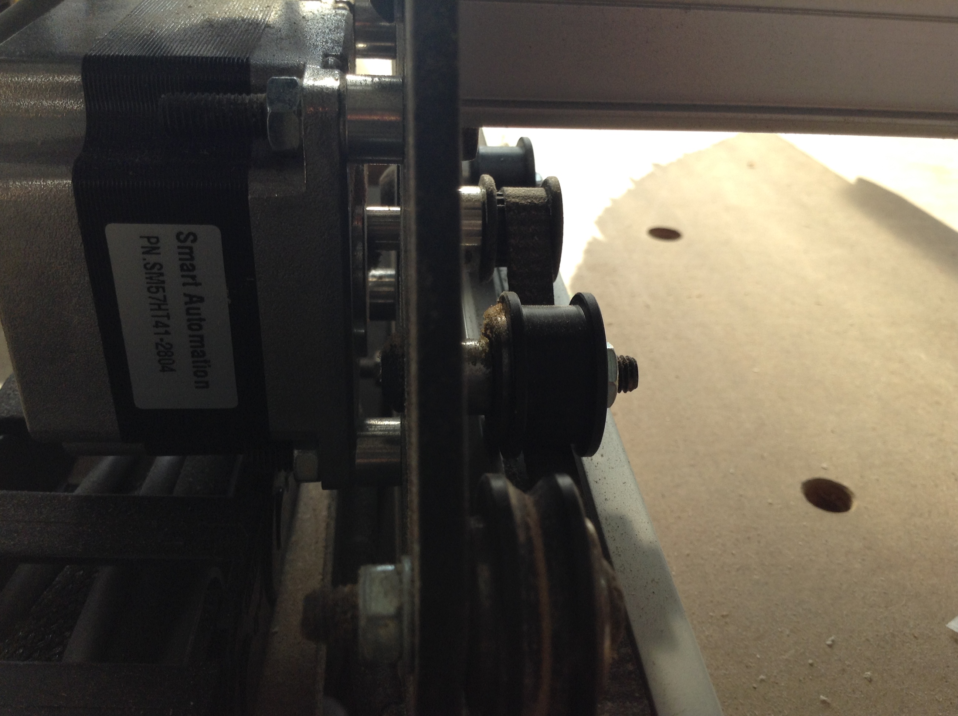
content/oPictures/gonzoBuildImages/IMG_0194a.JPG
