shapeoko/Docs/content/oPictures/gonzoBuildImages/IMG_0195.JPG

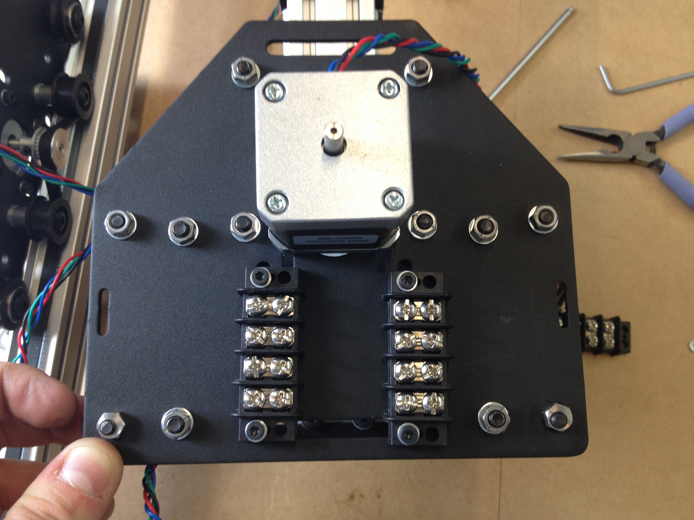
content/oPictures/gonzoBuildImages/IMG_0195.JPG
