shapeoko/Docs/content/oPictures/gonzoBuildImages/IMG_0195a.JPG

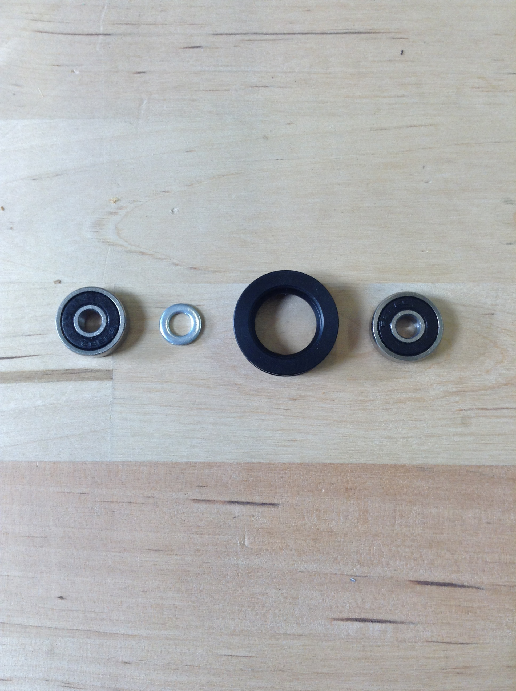
content/oPictures/gonzoBuildImages/IMG_0195a.JPG
