shapeoko/Docs/content/oPictures/gonzoBuildImages/IMG_0197a.JPG

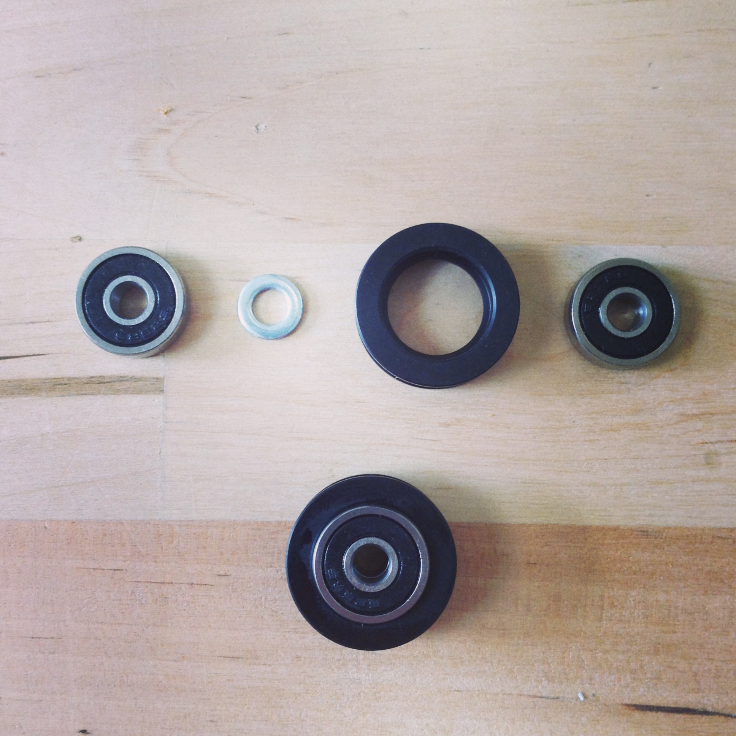
content/oPictures/gonzoBuildImages/IMG_0197a.JPG
