shapeoko/Docs/content/oPictures/gonzoBuildImages/IMG_0199.JPG

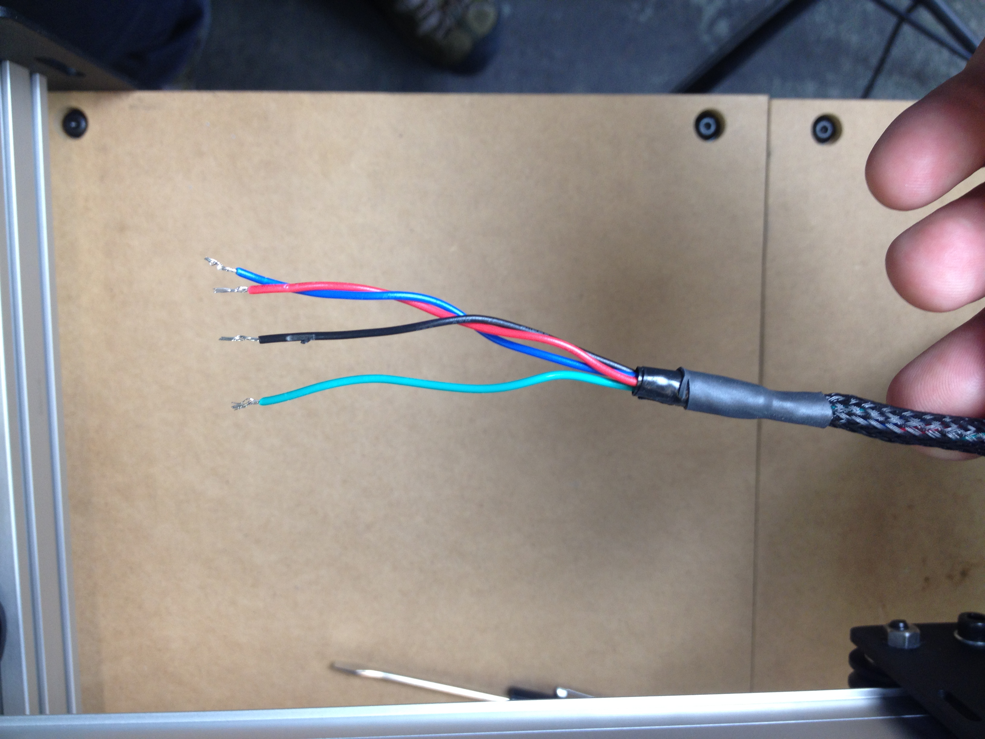
content/oPictures/gonzoBuildImages/IMG_0199.JPG
