shapeoko/Docs/content/oPictures/gonzoBuildImages/IMG_0200.JPG

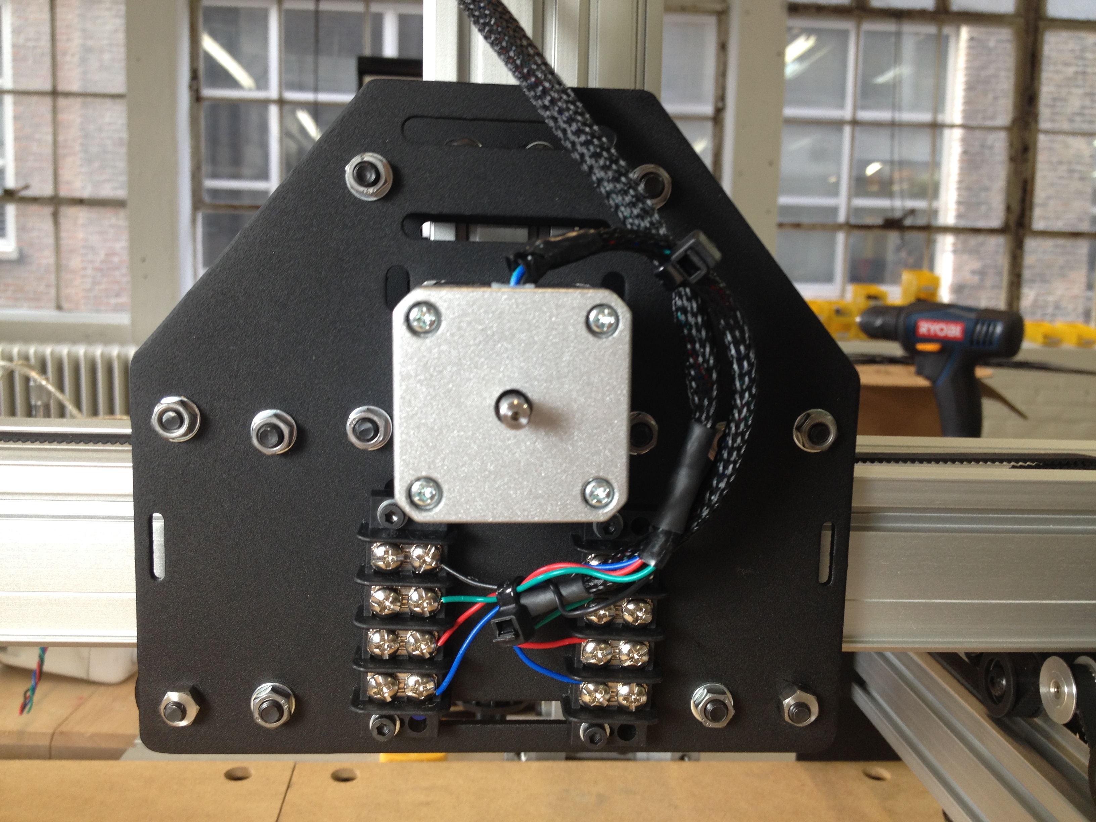
content/oPictures/gonzoBuildImages/IMG_0200.JPG
