shapeoko/Docs/content/oPictures/gonzoBuildImages/IMG_0201.JPG

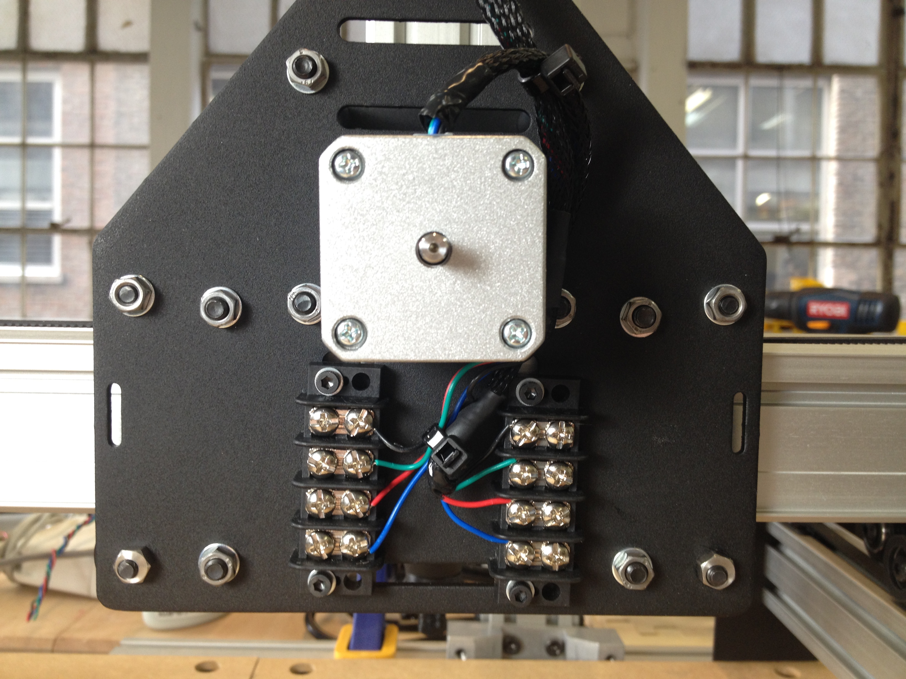
content/oPictures/gonzoBuildImages/IMG_0201.JPG
