shapeoko/Docs/content/oPictures/gonzoBuildImages/IMG_0202.JPG

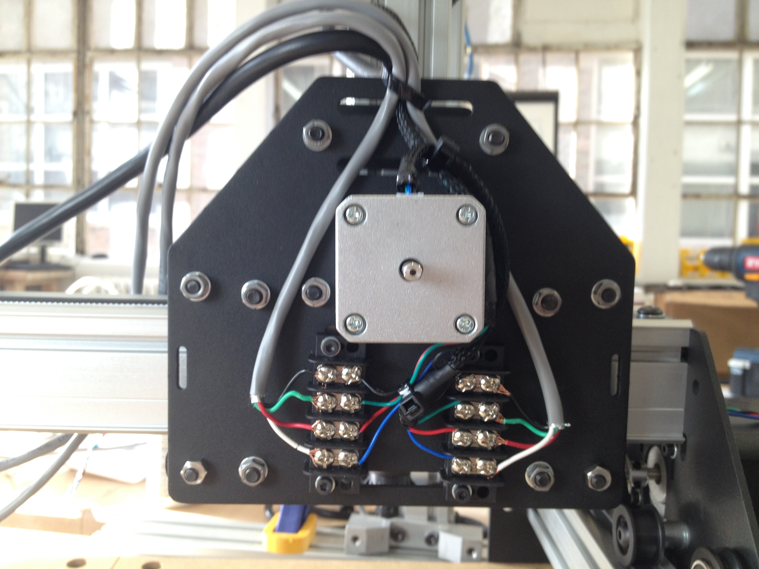
content/oPictures/gonzoBuildImages/IMG_0202.JPG
