shapeoko/Docs/content/oPictures/gonzoBuildImages/IMG_0204.JPG

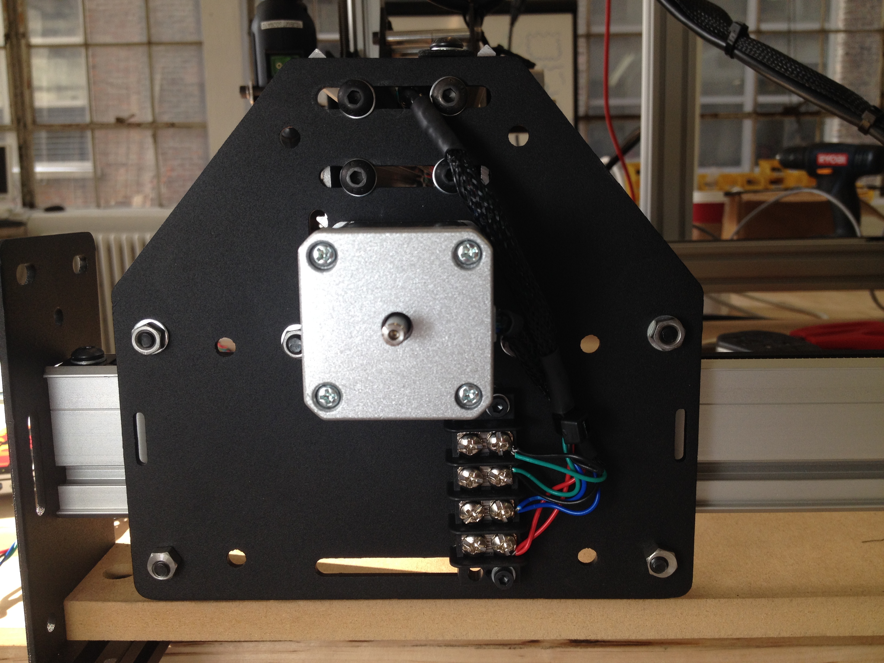
content/oPictures/gonzoBuildImages/IMG_0204.JPG
