shapeoko/Docs/content/oPictures/gonzoBuildImages/IMG_0204a.JPG

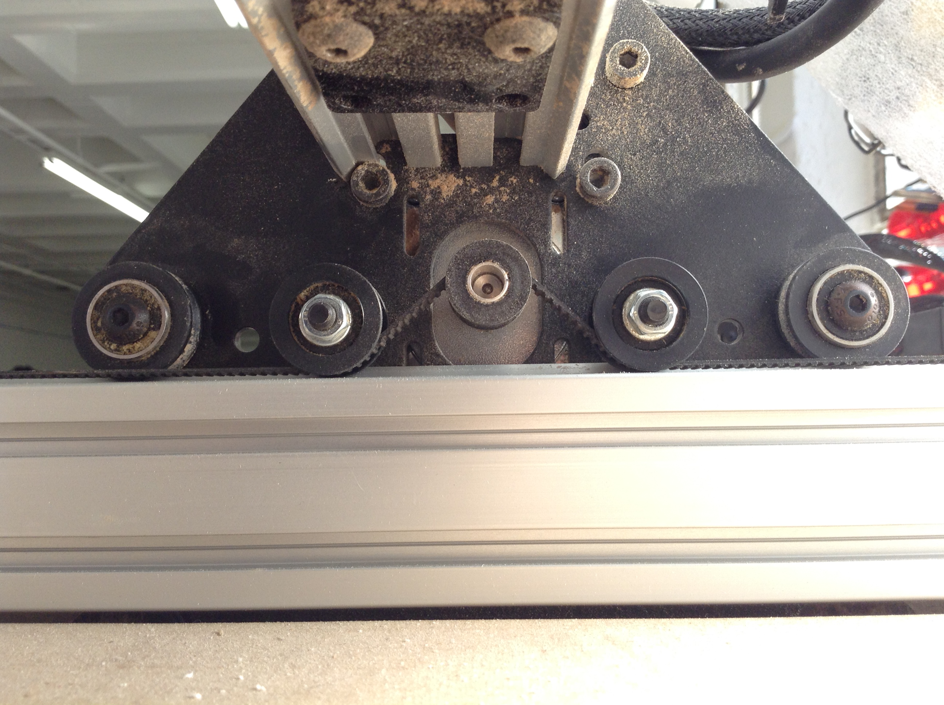
content/oPictures/gonzoBuildImages/IMG_0204a.JPG
