shapeoko/Docs/content/oPictures/gonzoBuildImages/IMG_0205.JPG

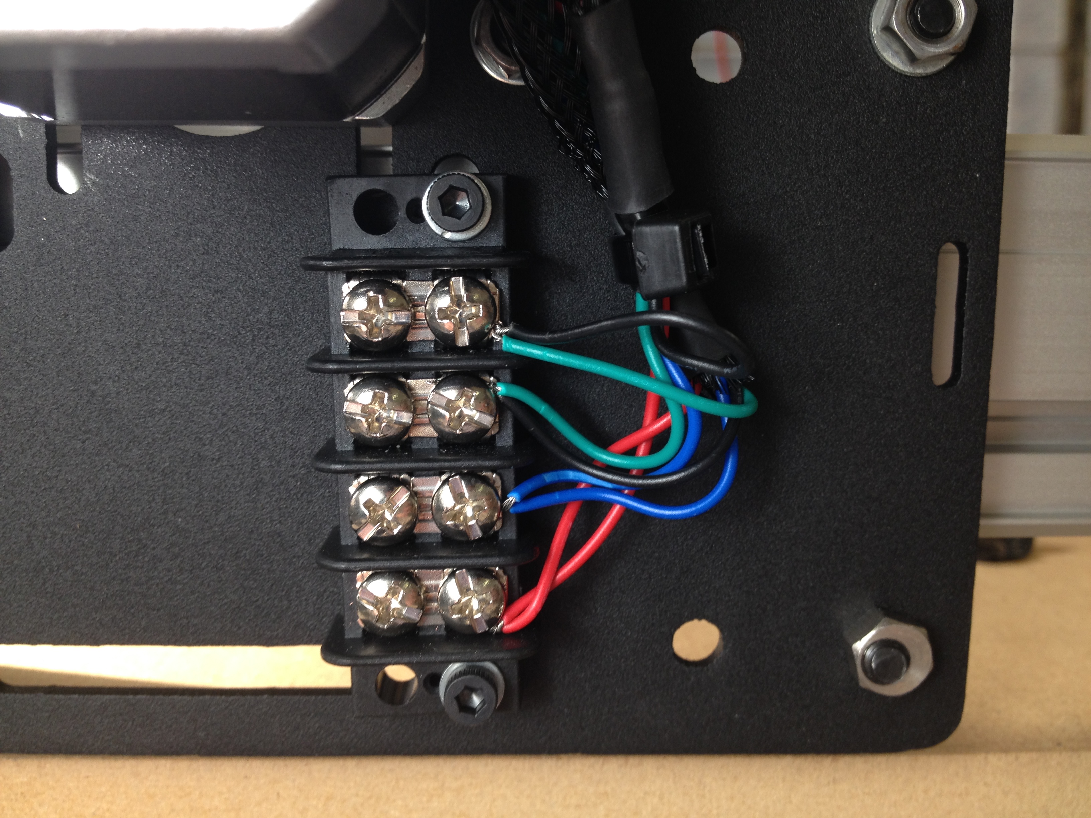
content/oPictures/gonzoBuildImages/IMG_0205.JPG
