shapeoko/Docs/content/oPictures/gonzoBuildImages/IMG_0205a.JPG

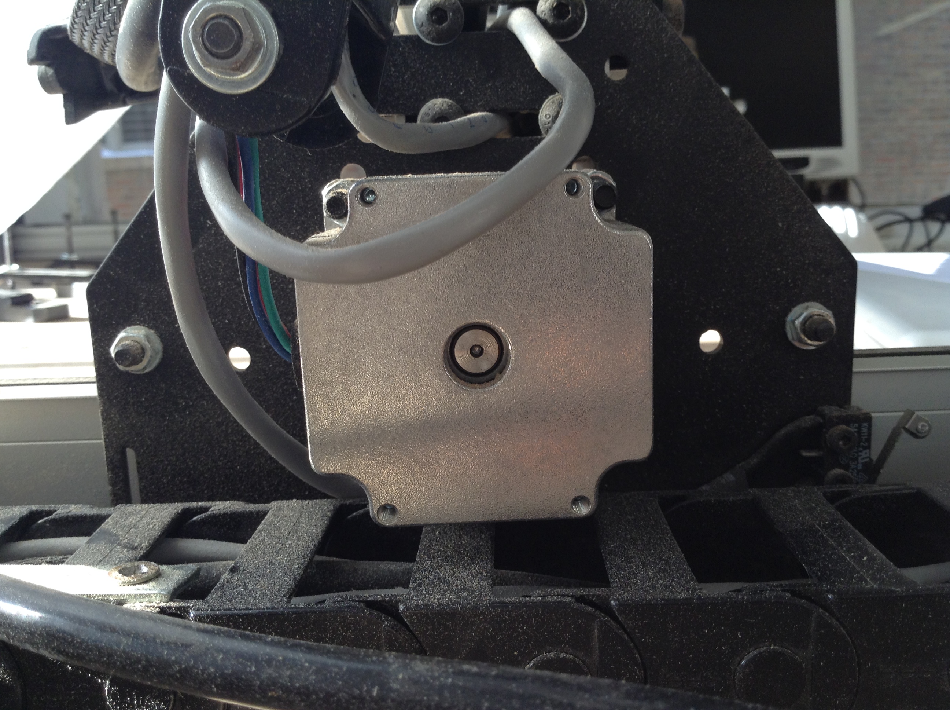
content/oPictures/gonzoBuildImages/IMG_0205a.JPG
