shapeoko/Docs/content/oPictures/gonzoBuildImages/IMG_0206.JPG

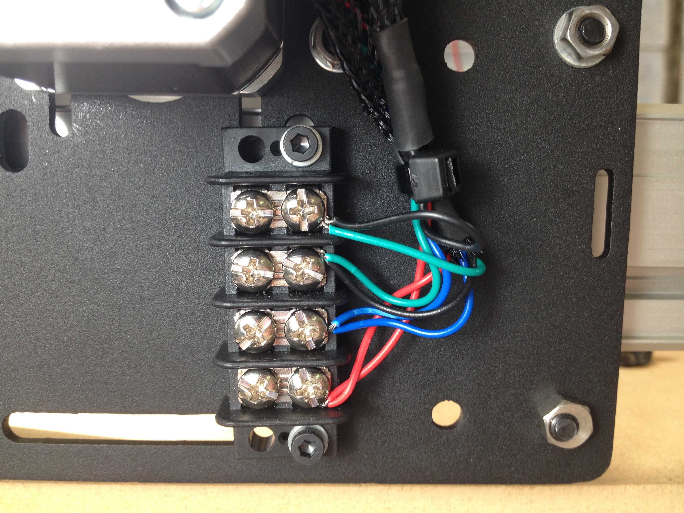
content/oPictures/gonzoBuildImages/IMG_0206.JPG
