shapeoko/Docs/content/oPictures/gonzoBuildImages/IMG_0207.JPG

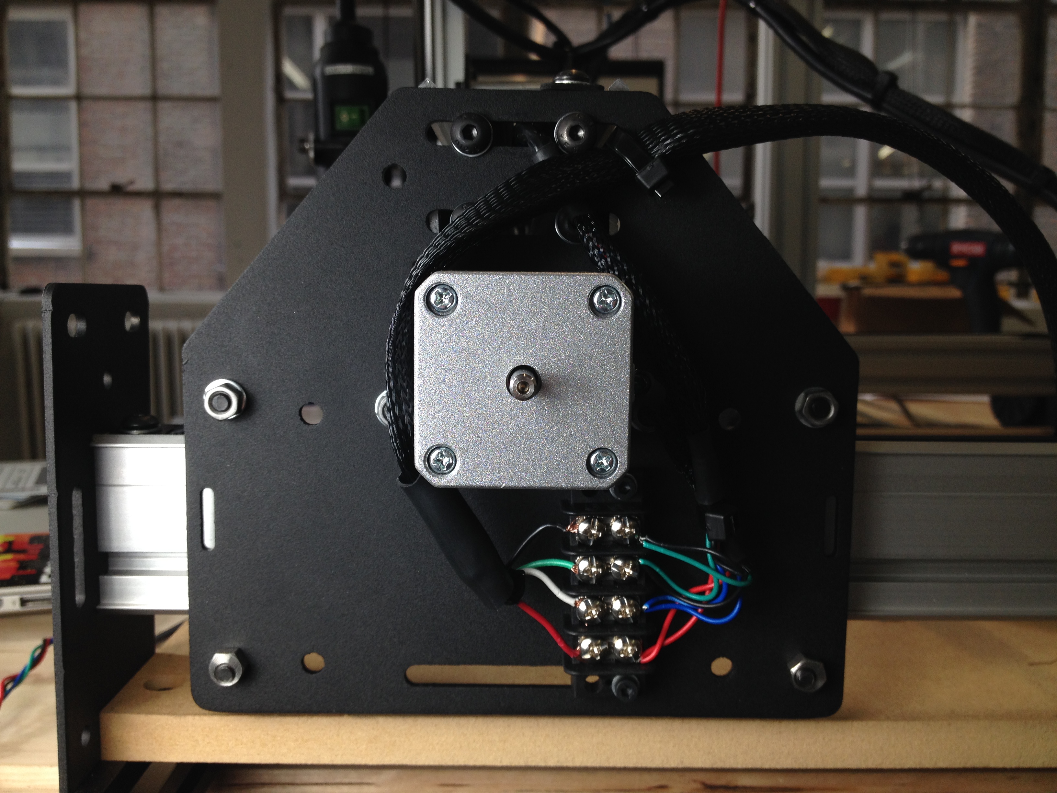
content/oPictures/gonzoBuildImages/IMG_0207.JPG
