shapeoko/Docs/content/oPictures/gonzoBuildImages/IMG_0207a.JPG

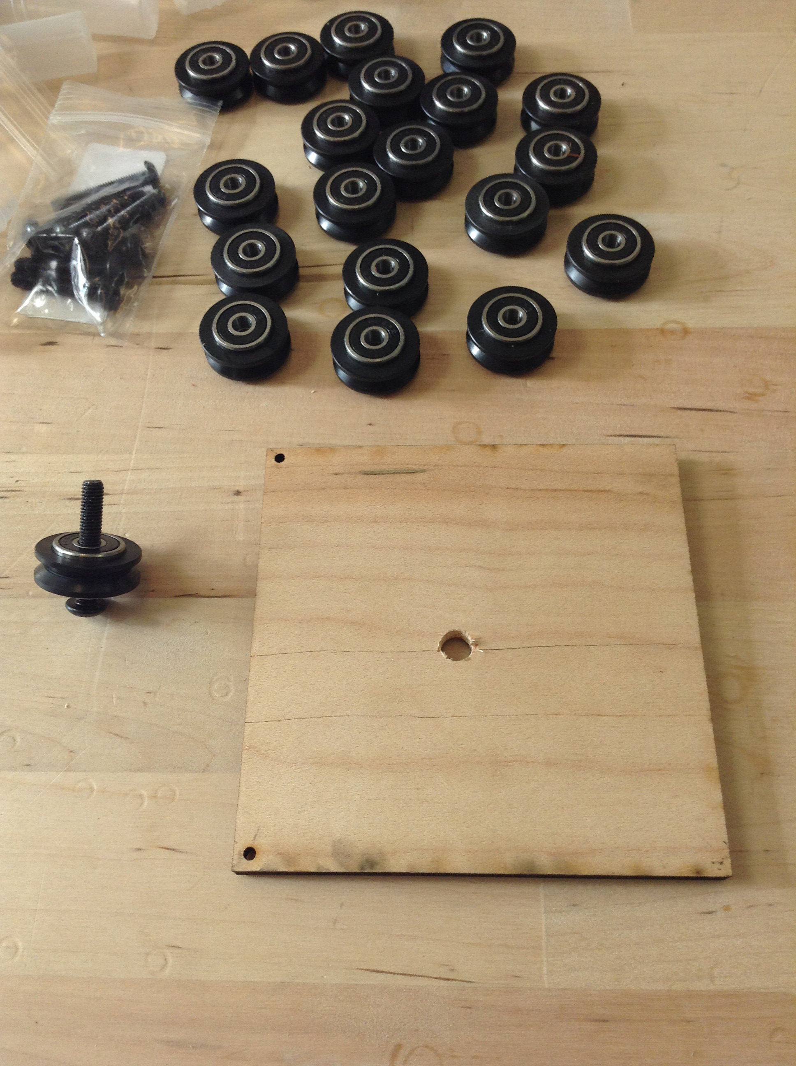
content/oPictures/gonzoBuildImages/IMG_0207a.JPG
