shapeoko/Docs/content/oPictures/gonzoBuildImages/IMG_0208a.JPG

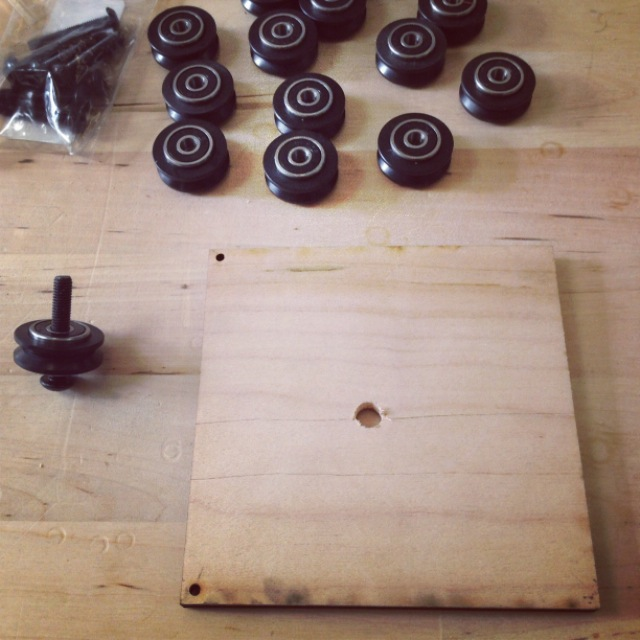
content/oPictures/gonzoBuildImages/IMG_0208a.JPG
