shapeoko/Docs/content/oPictures/gonzoBuildImages/IMG_0209.JPG

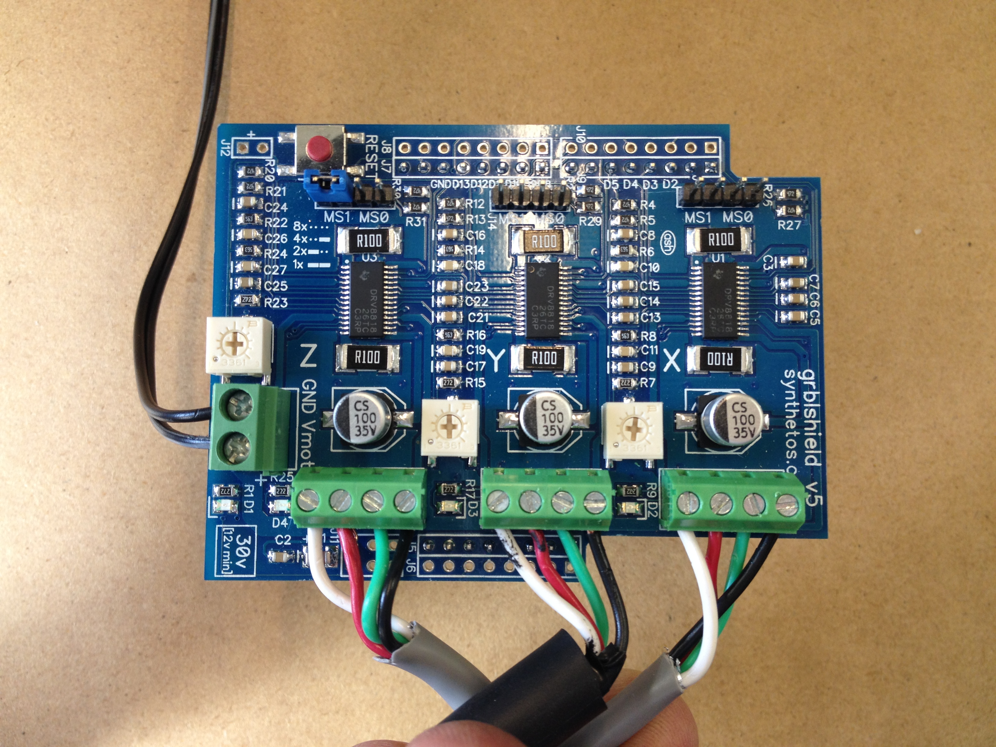
content/oPictures/gonzoBuildImages/IMG_0209.JPG
