shapeoko/Docs/content/oPictures/gonzoBuildImages/IMG_0209a.JPG

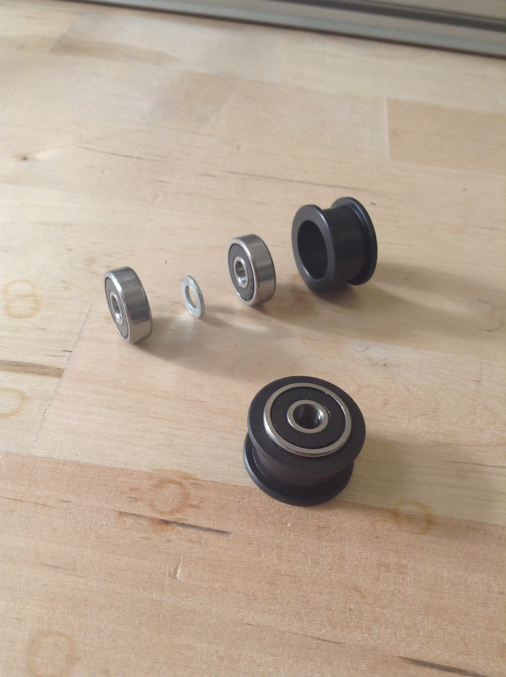
content/oPictures/gonzoBuildImages/IMG_0209a.JPG
