shapeoko/Docs/content/oPictures/gonzoBuildImages/IMG_0210.JPG

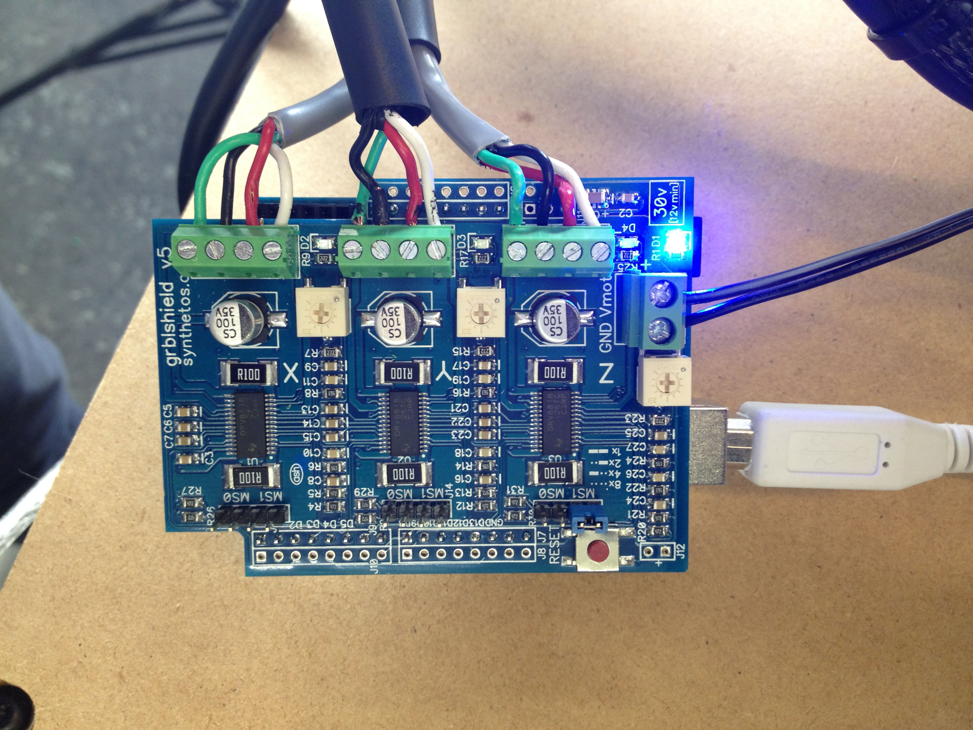
content/oPictures/gonzoBuildImages/IMG_0210.JPG
