shapeoko/Docs/content/oPictures/gonzoBuildImages/IMG_0211.JPG

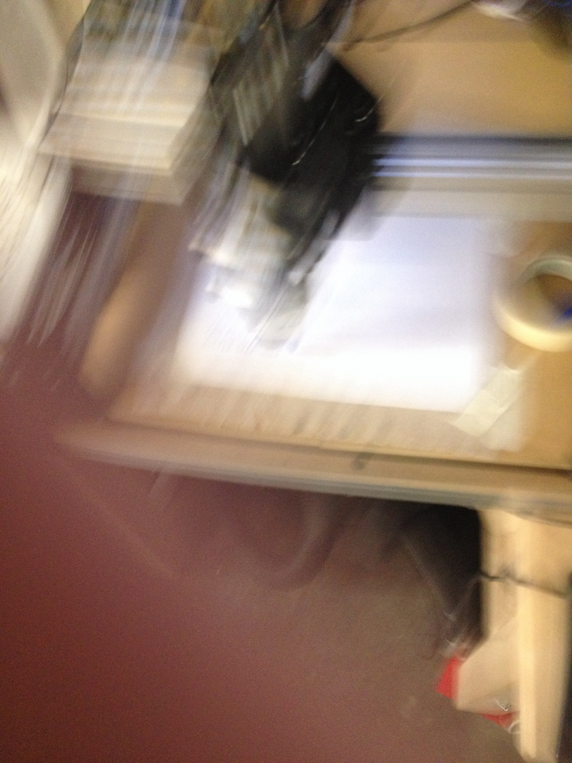
content/oPictures/gonzoBuildImages/IMG_0211.JPG
