shapeoko/Docs/content/oPictures/gonzoBuildImages/IMG_0211a.JPG

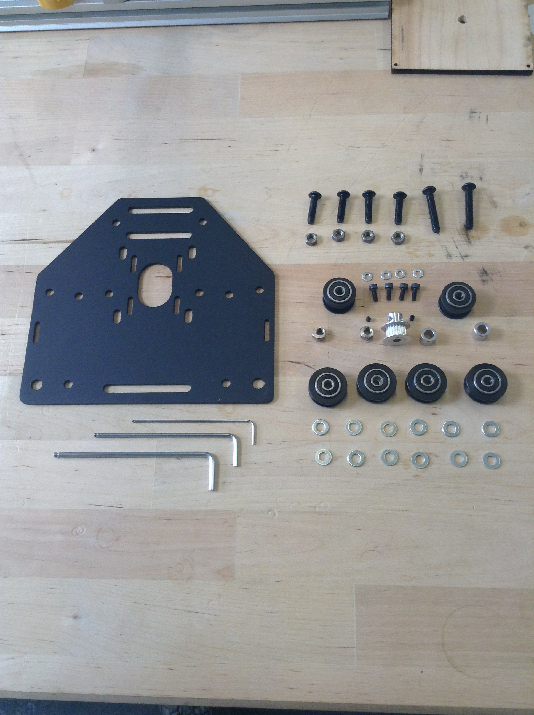
content/oPictures/gonzoBuildImages/IMG_0211a.JPG
