shapeoko/Docs/content/oPictures/gonzoBuildImages/IMG_0212.JPG

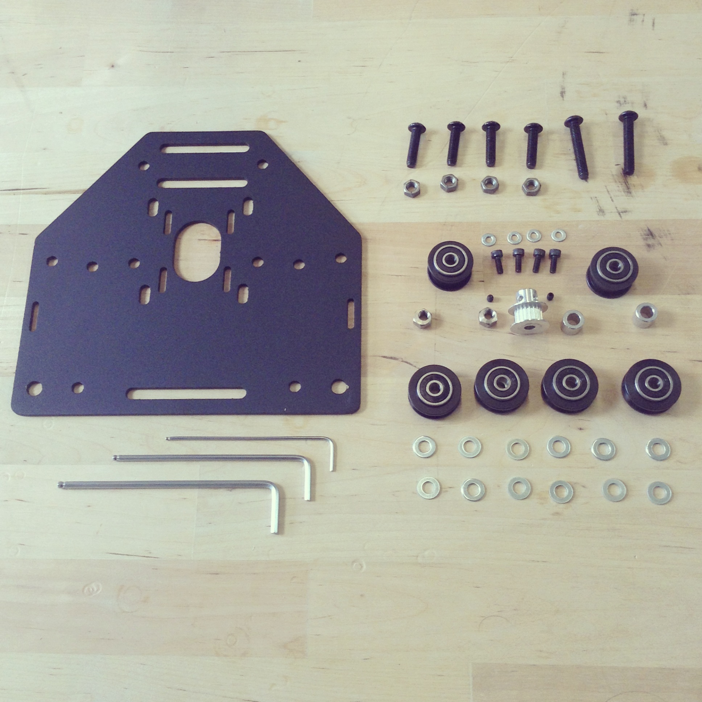
content/oPictures/gonzoBuildImages/IMG_0212.JPG
