shapeoko/Docs/content/oPictures/gonzoBuildImages/IMG_0213.JPG

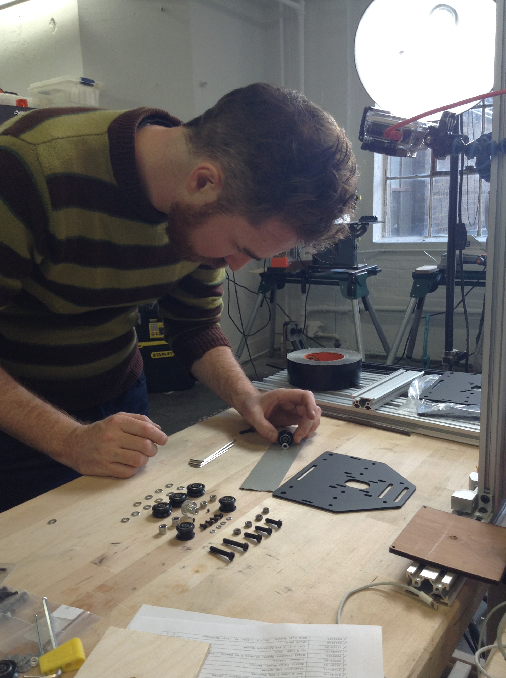
content/oPictures/gonzoBuildImages/IMG_0213.JPG
