shapeoko/Docs/content/oPictures/gonzoBuildImages/IMG_0214.JPG

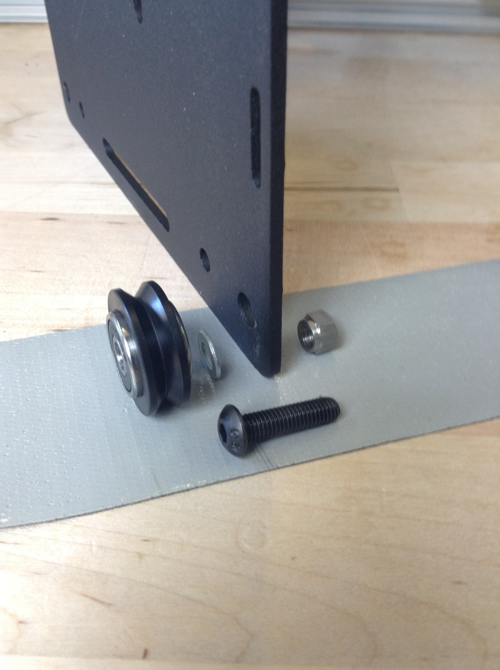
content/oPictures/gonzoBuildImages/IMG_0214.JPG
