shapeoko/Docs/content/oPictures/gonzoBuildImages/IMG_0215.JPG

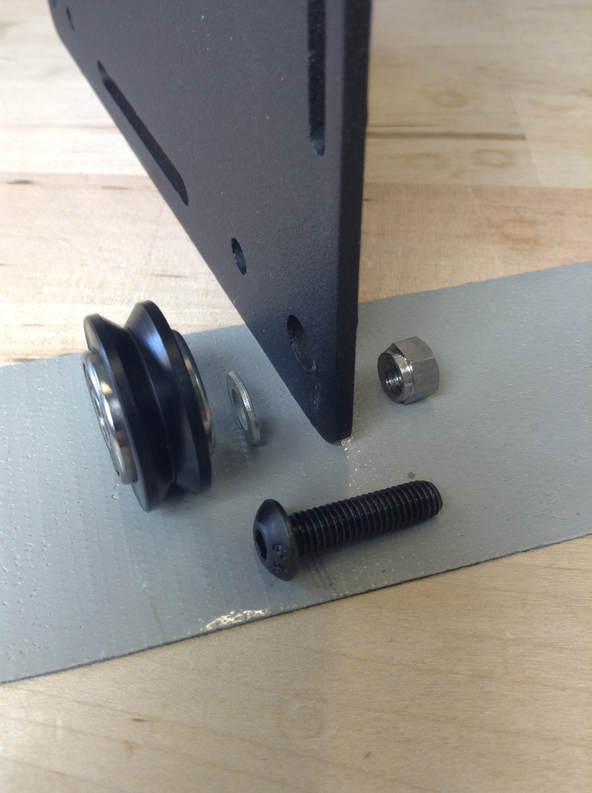
content/oPictures/gonzoBuildImages/IMG_0215.JPG
