shapeoko/Docs/content/oPictures/gonzoBuildImages/IMG_0217.JPG

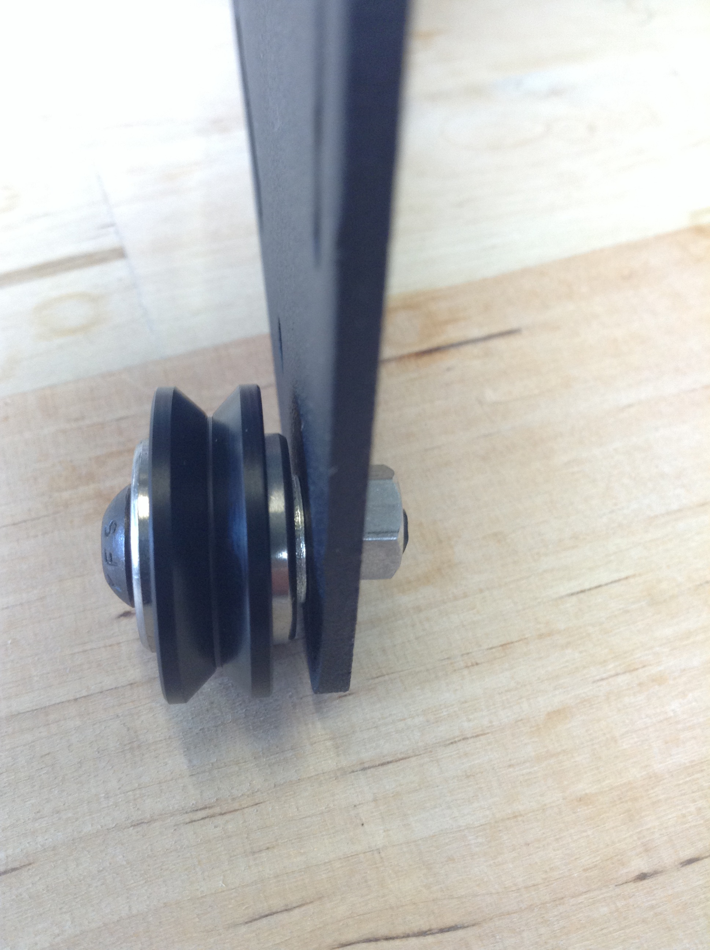
content/oPictures/gonzoBuildImages/IMG_0217.JPG
