shapeoko/Docs/content/oPictures/gonzoBuildImages/IMG_0218a.JPG

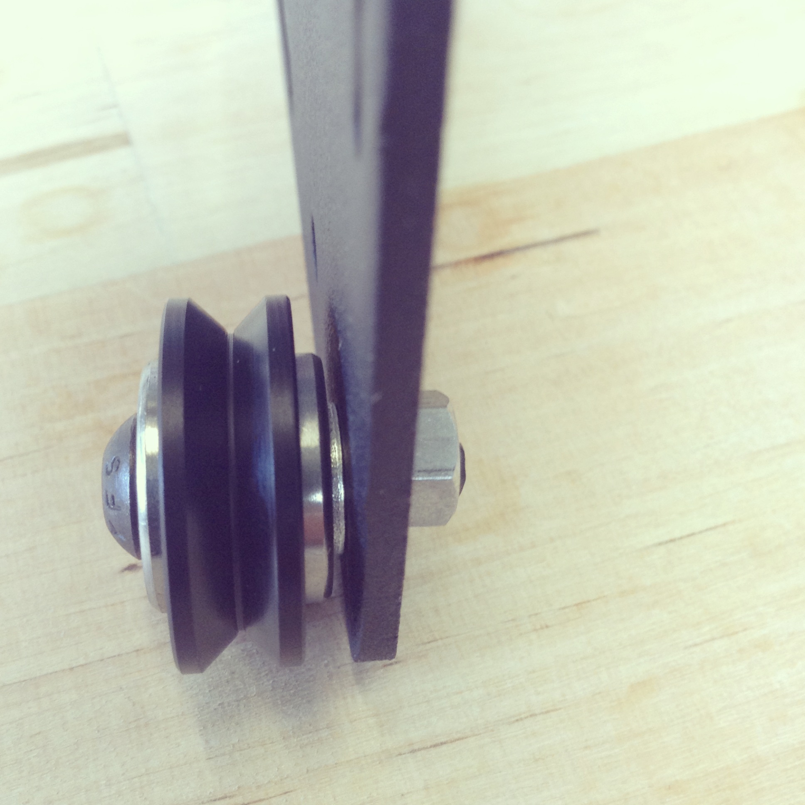
content/oPictures/gonzoBuildImages/IMG_0218a.JPG
