shapeoko/Docs/content/oPictures/gonzoBuildImages/IMG_0219.JPG

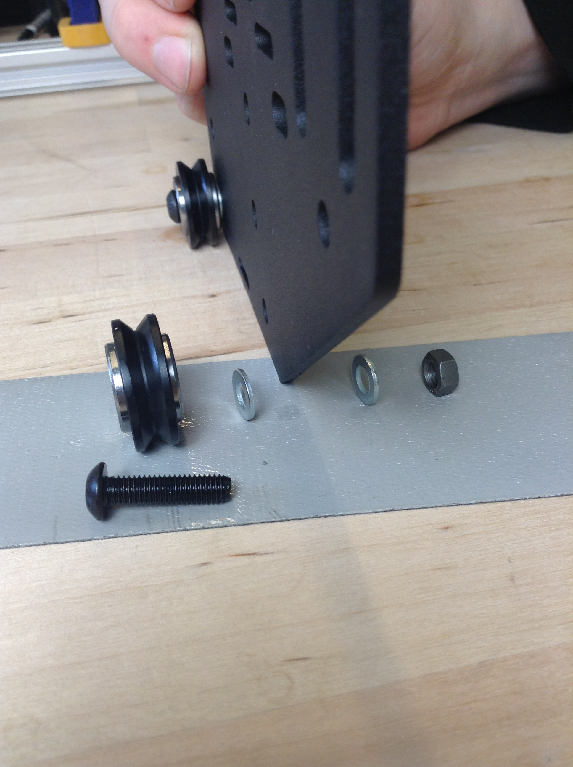
content/oPictures/gonzoBuildImages/IMG_0219.JPG
