shapeoko/Docs/content/oPictures/gonzoBuildImages/IMG_0220.JPG

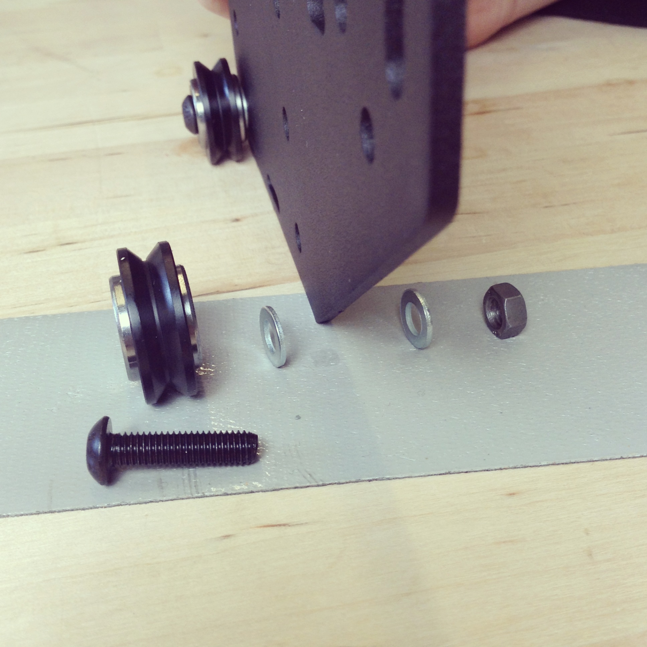
content/oPictures/gonzoBuildImages/IMG_0220.JPG
