shapeoko/Docs/content/oPictures/gonzoBuildImages/IMG_0221a.JPG

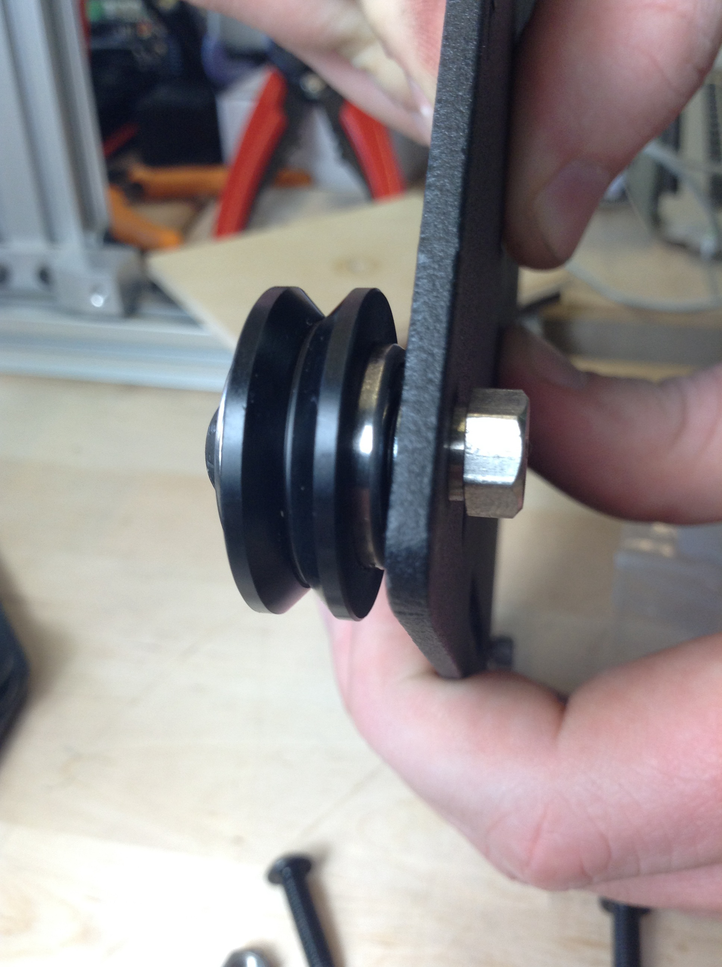
content/oPictures/gonzoBuildImages/IMG_0221a.JPG
