shapeoko/Docs/content/oPictures/gonzoBuildImages/IMG_0222.JPG

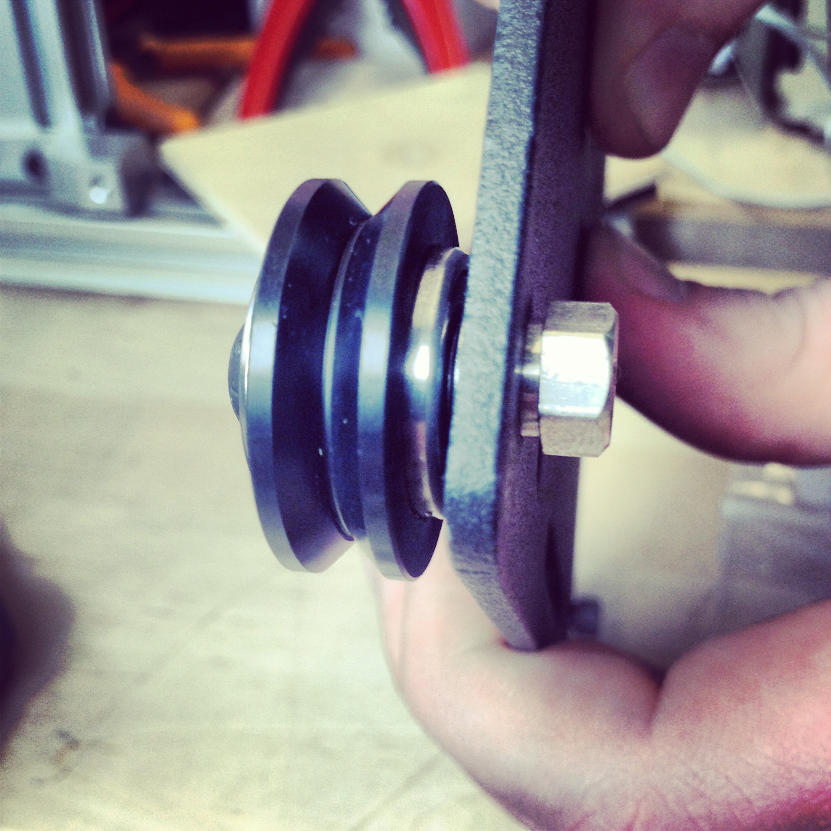
content/oPictures/gonzoBuildImages/IMG_0222.JPG
