shapeoko/Docs/content/oPictures/gonzoBuildImages/IMG_0223.JPG

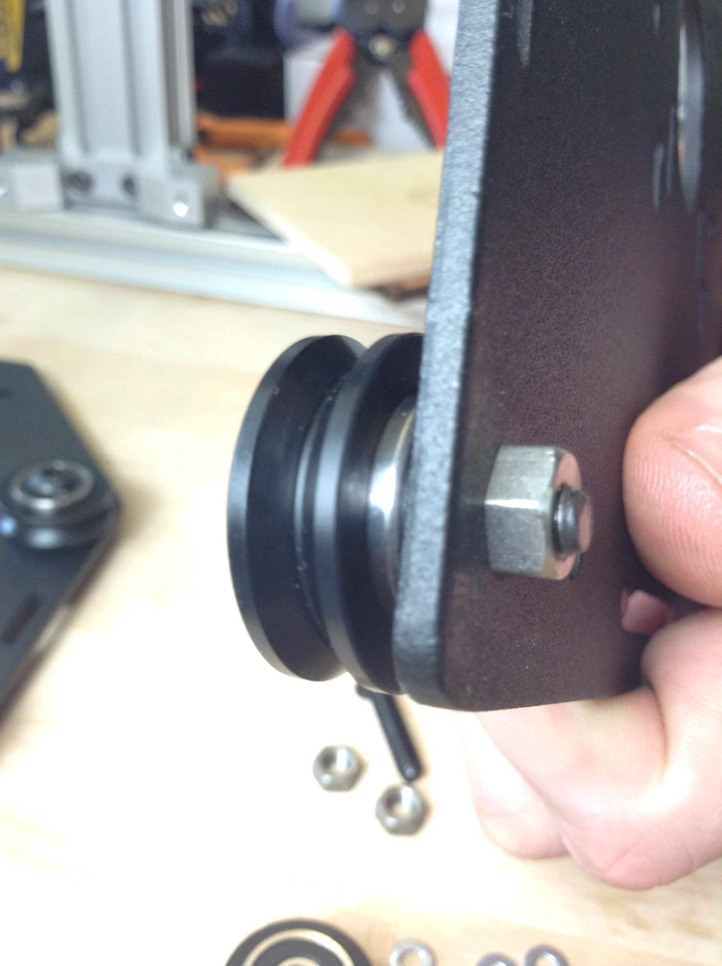
content/oPictures/gonzoBuildImages/IMG_0223.JPG
