shapeoko/Docs/content/oPictures/gonzoBuildImages/IMG_0224.JPG

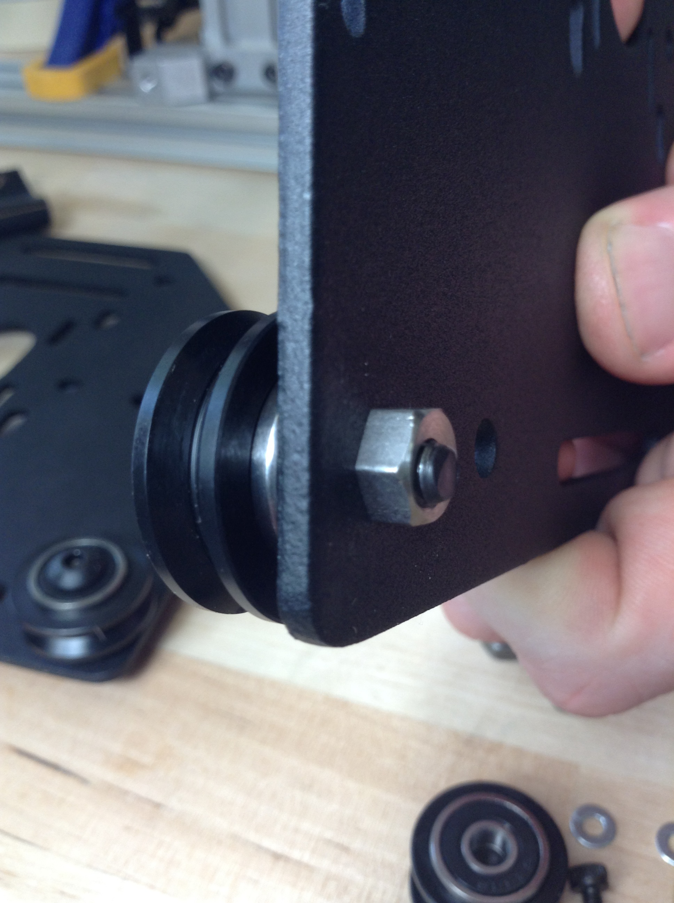
content/oPictures/gonzoBuildImages/IMG_0224.JPG
