shapeoko/Docs/content/oPictures/gonzoBuildImages/IMG_0225.JPG

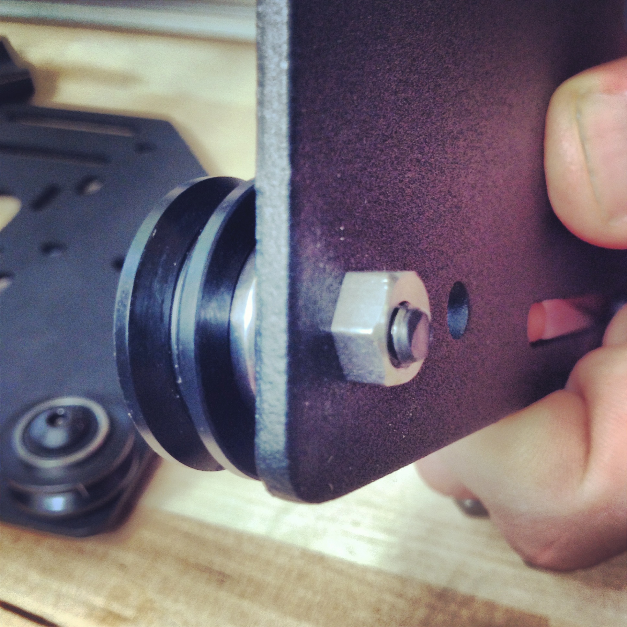
content/oPictures/gonzoBuildImages/IMG_0225.JPG
