shapeoko/Docs/content/oPictures/gonzoBuildImages/IMG_0226.JPG

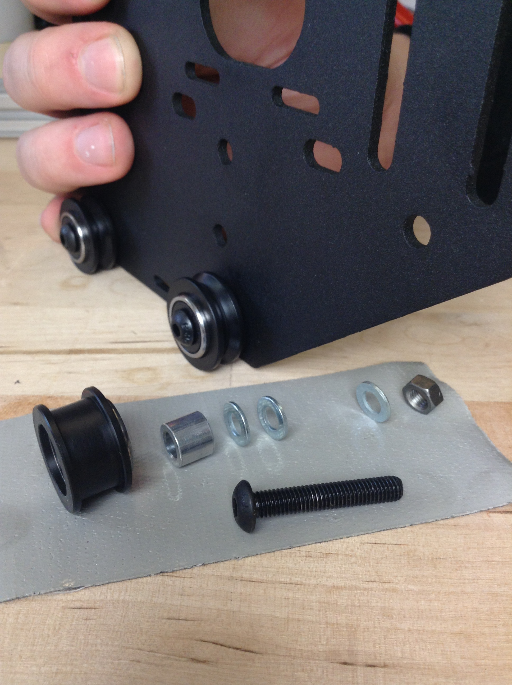
content/oPictures/gonzoBuildImages/IMG_0226.JPG
