shapeoko/Docs/content/oPictures/gonzoBuildImages/IMG_0227.JPG

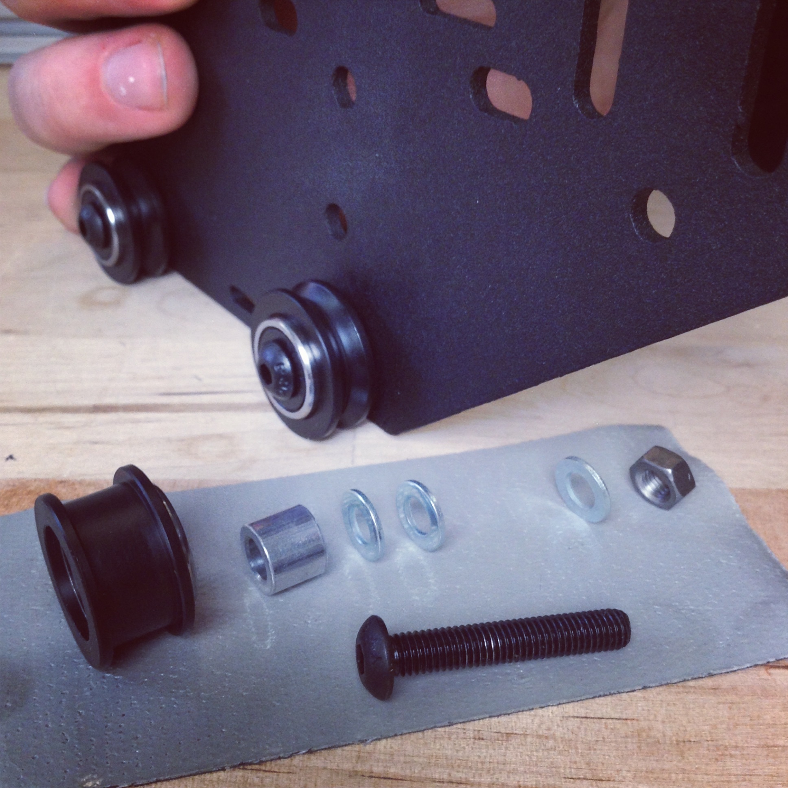
content/oPictures/gonzoBuildImages/IMG_0227.JPG
