shapeoko/Docs/content/oPictures/gonzoBuildImages/IMG_0228.JPG

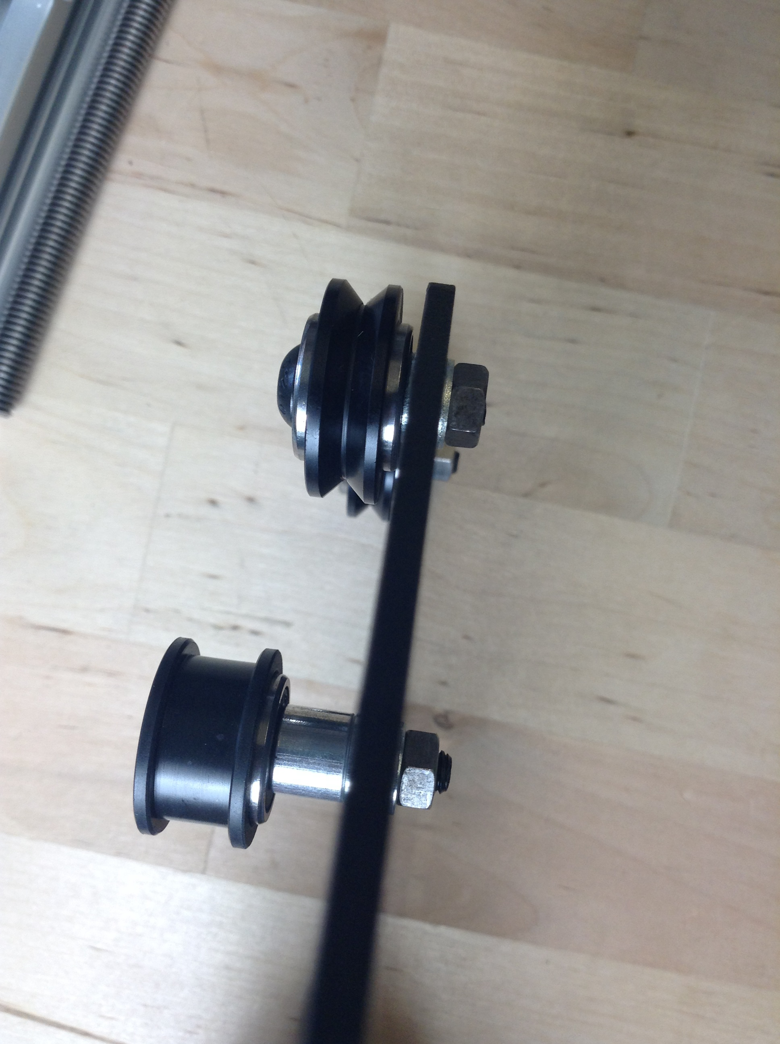
content/oPictures/gonzoBuildImages/IMG_0228.JPG
