shapeoko/Docs/content/oPictures/gonzoBuildImages/IMG_0229.JPG

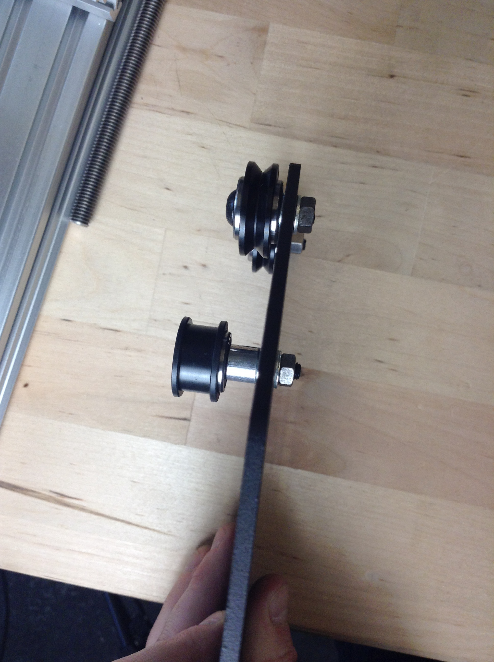
content/oPictures/gonzoBuildImages/IMG_0229.JPG
