shapeoko/Docs/content/oPictures/gonzoBuildImages/IMG_0231.JPG

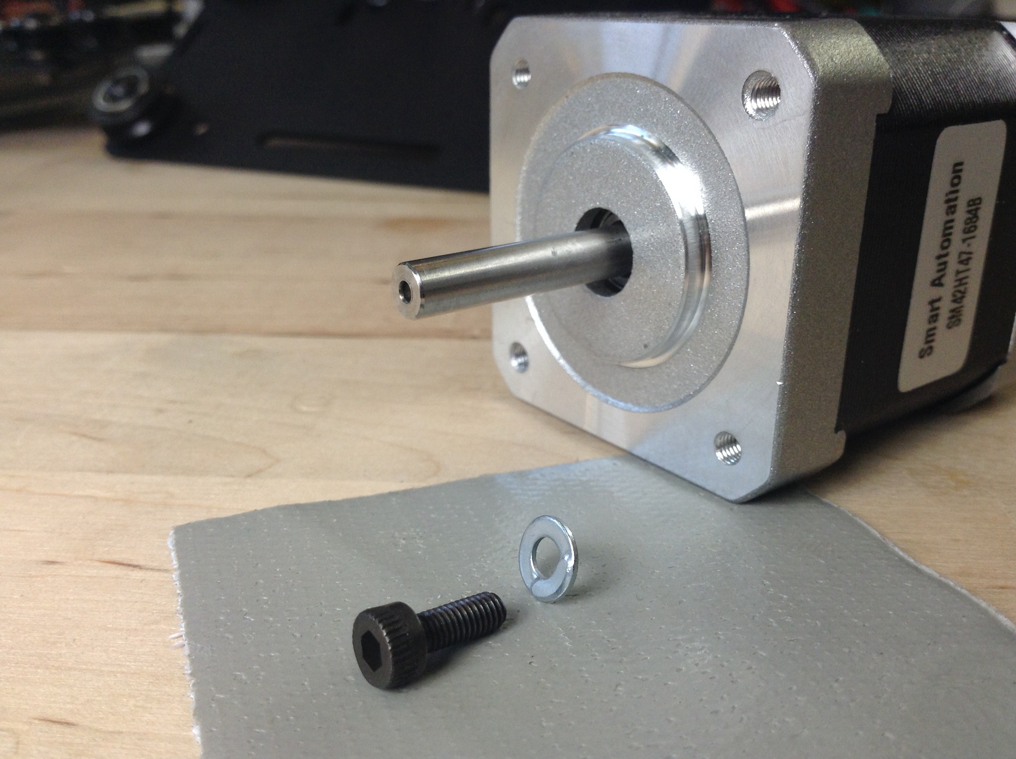
content/oPictures/gonzoBuildImages/IMG_0231.JPG
