shapeoko/Docs/content/oPictures/gonzoBuildImages/IMG_0232.JPG

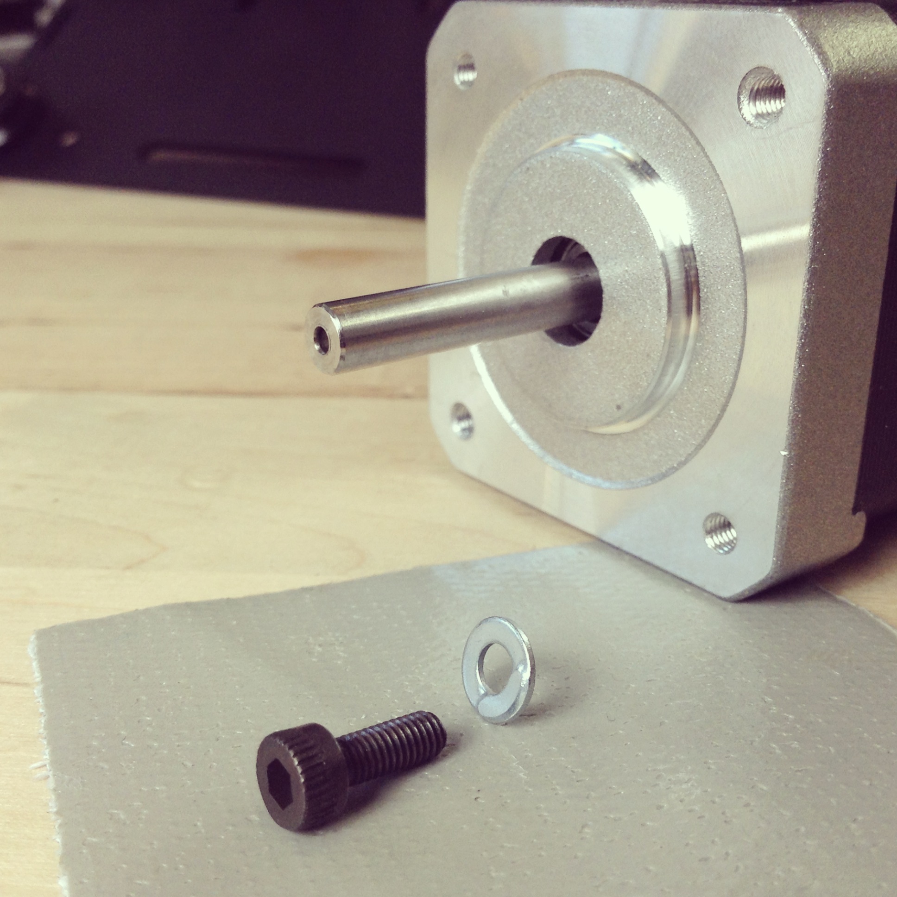
content/oPictures/gonzoBuildImages/IMG_0232.JPG
