shapeoko/Docs/content/oPictures/gonzoBuildImages/IMG_0233.JPG

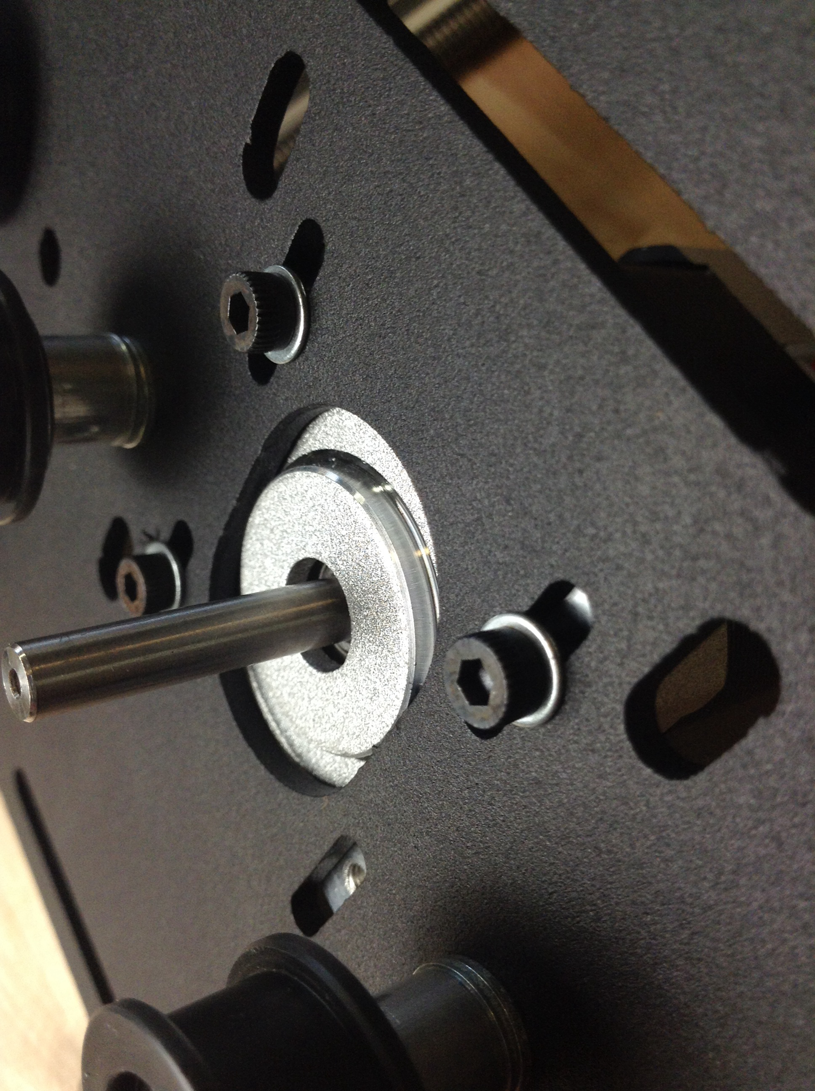
content/oPictures/gonzoBuildImages/IMG_0233.JPG
