shapeoko/Docs/content/oPictures/gonzoBuildImages/IMG_0234.JPG

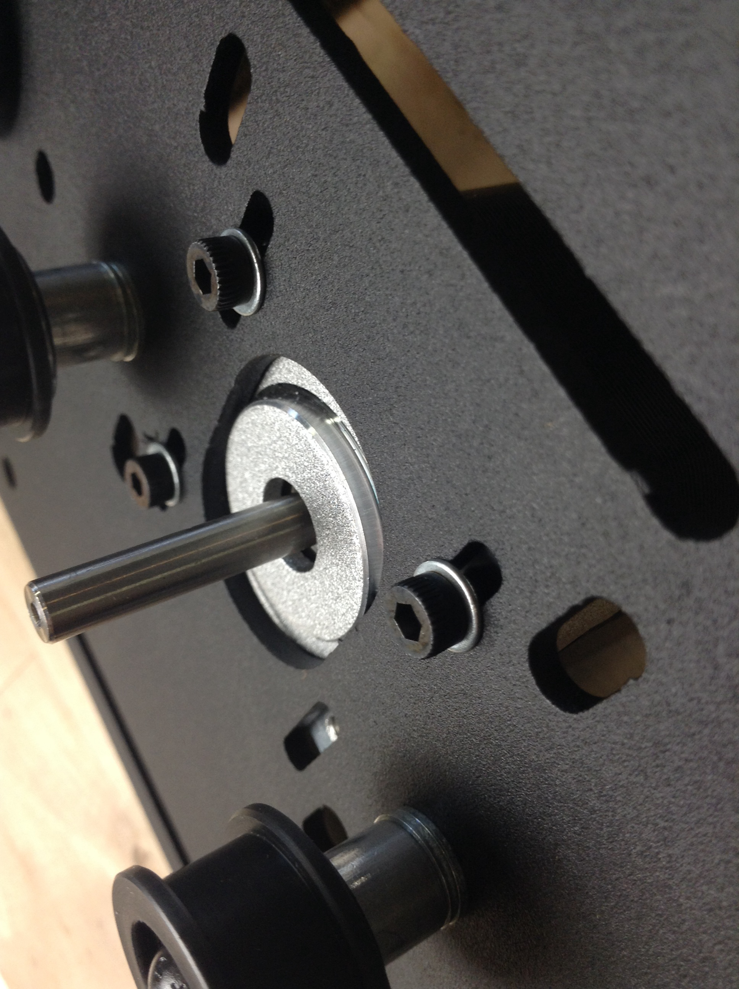
content/oPictures/gonzoBuildImages/IMG_0234.JPG
