shapeoko/Docs/content/oPictures/gonzoBuildImages/IMG_0235.JPG

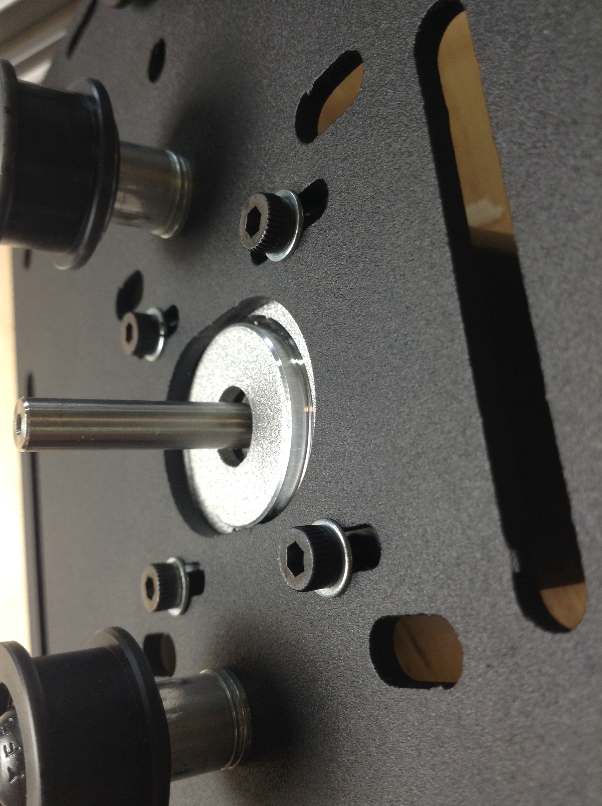
content/oPictures/gonzoBuildImages/IMG_0235.JPG
