shapeoko/Docs/content/oPictures/gonzoBuildImages/IMG_0236.JPG

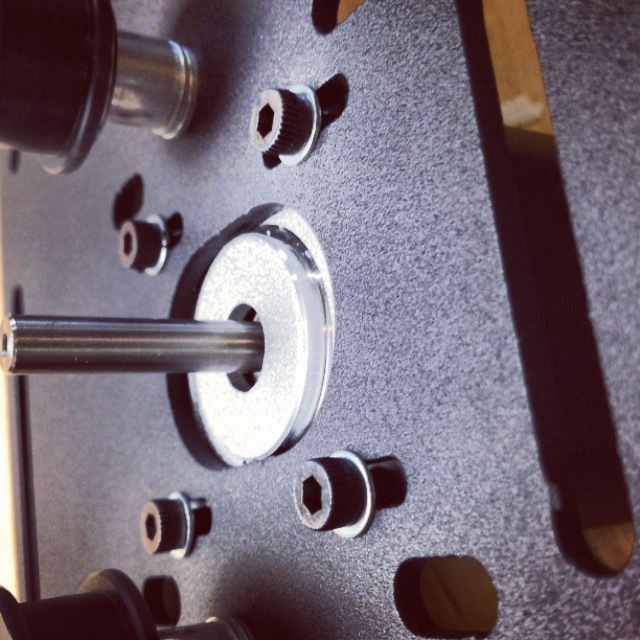
content/oPictures/gonzoBuildImages/IMG_0236.JPG
