shapeoko/Docs/content/oPictures/gonzoBuildImages/IMG_0238.JPG

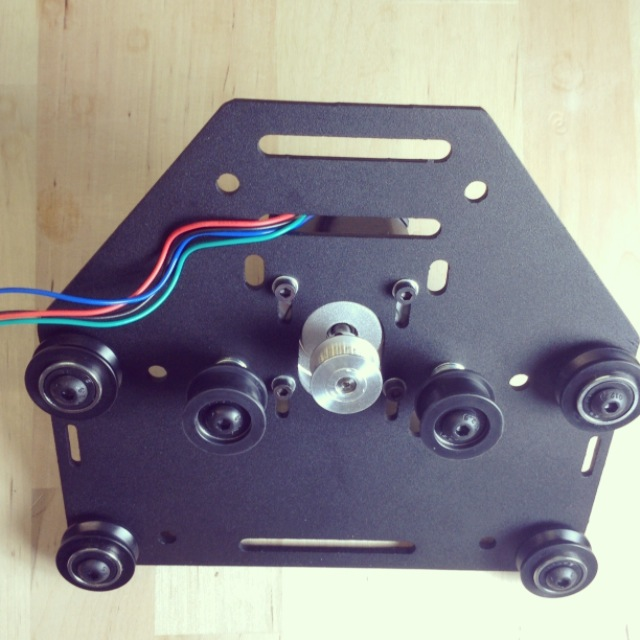
content/oPictures/gonzoBuildImages/IMG_0238.JPG
