shapeoko/Docs/content/oPictures/gonzoBuildImages/IMG_0239.JPG

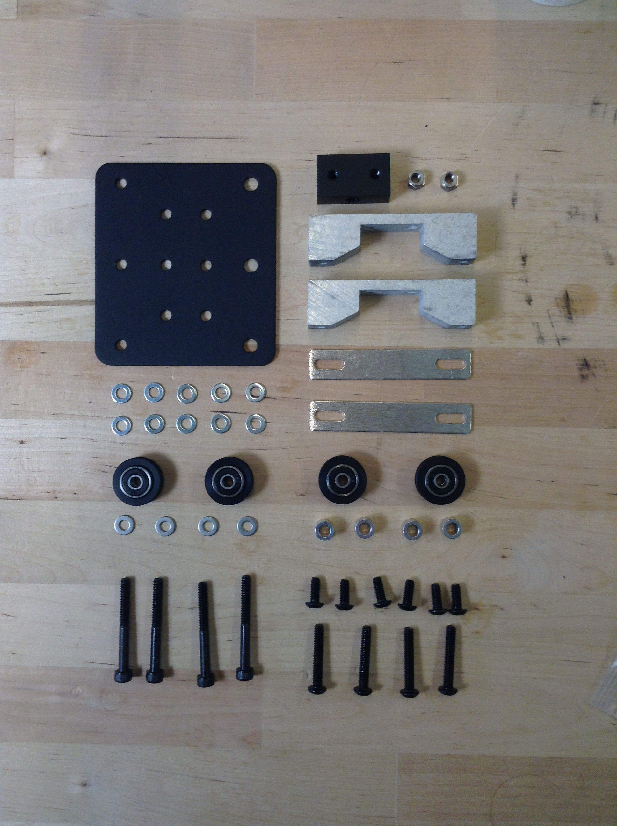
content/oPictures/gonzoBuildImages/IMG_0239.JPG
