shapeoko/Docs/content/oPictures/gonzoBuildImages/IMG_0240.JPG

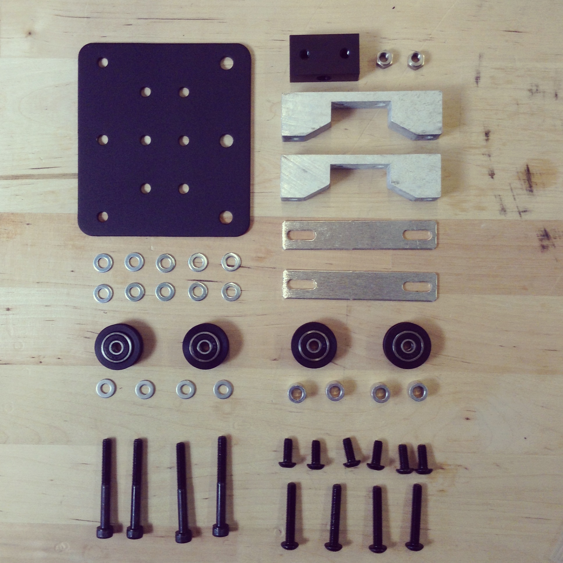
content/oPictures/gonzoBuildImages/IMG_0240.JPG
