shapeoko/Docs/content/oPictures/gonzoBuildImages/IMG_0242.JPG

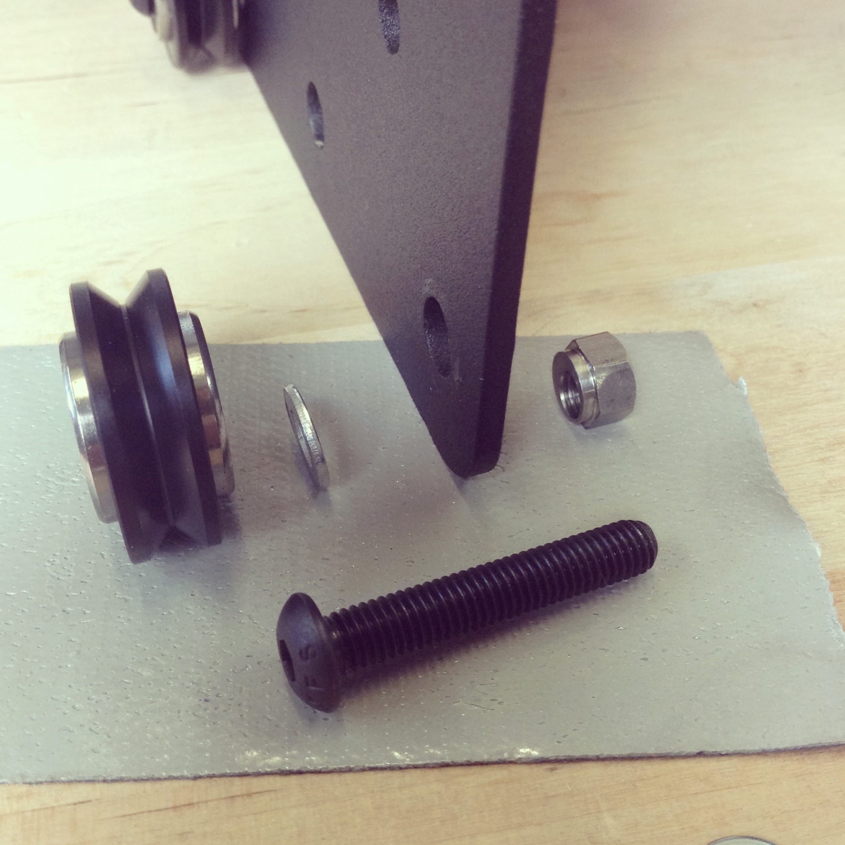
content/oPictures/gonzoBuildImages/IMG_0242.JPG
