shapeoko/Docs/content/oPictures/gonzoBuildImages/IMG_0243.JPG

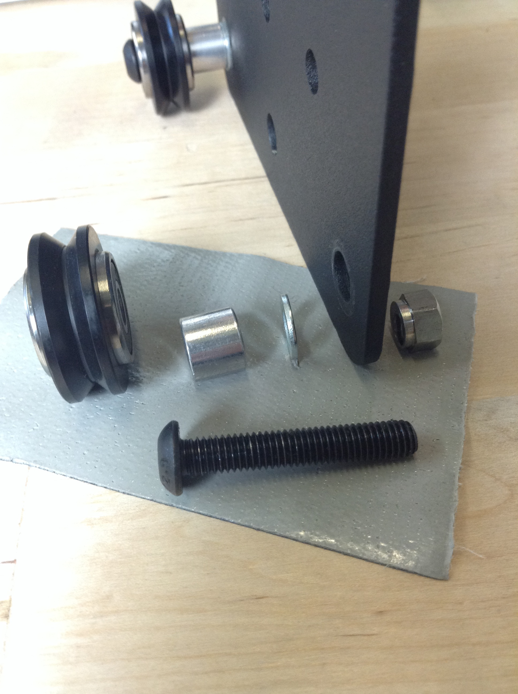
content/oPictures/gonzoBuildImages/IMG_0243.JPG
