shapeoko/Docs/content/oPictures/gonzoBuildImages/IMG_0248.JPG

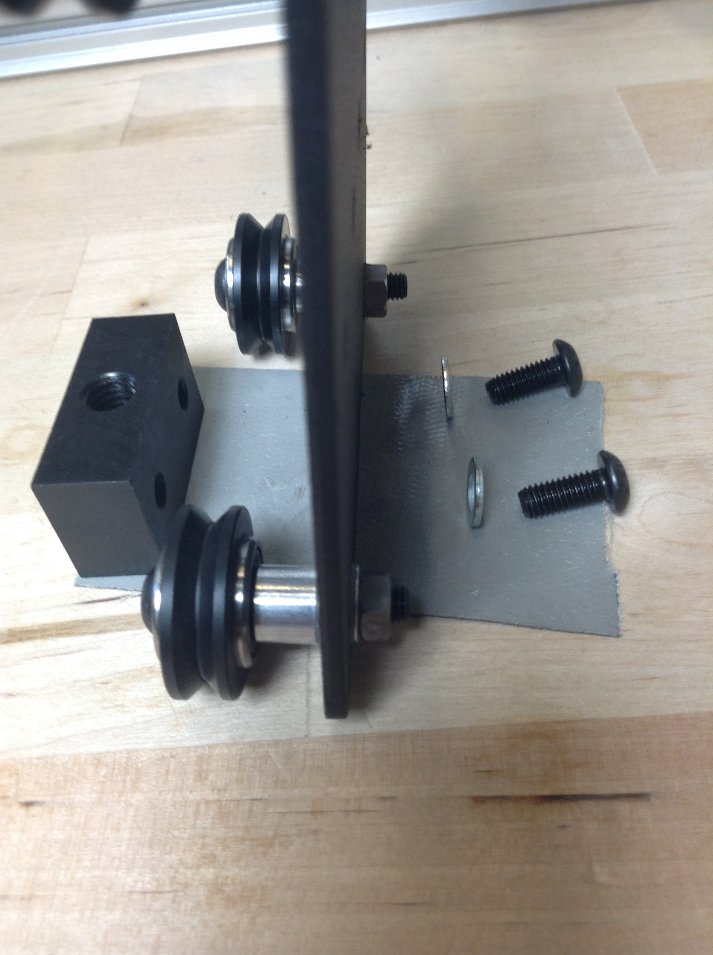
content/oPictures/gonzoBuildImages/IMG_0248.JPG
