shapeoko/Docs/content/oPictures/gonzoBuildImages/IMG_0250.JPG

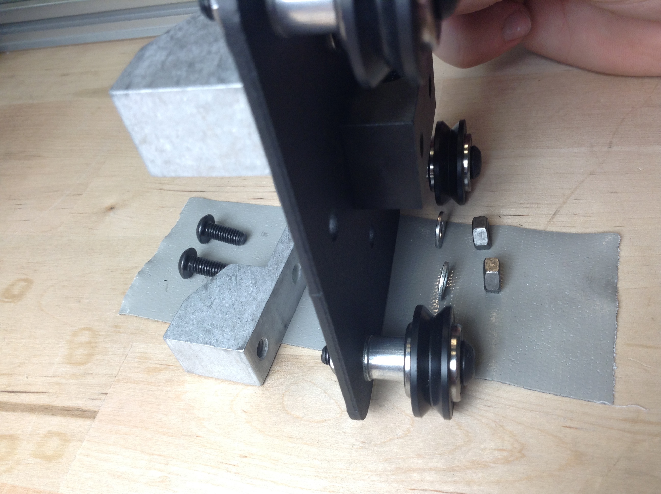
content/oPictures/gonzoBuildImages/IMG_0250.JPG
