shapeoko/Docs/content/oPictures/gonzoBuildImages/IMG_0253.JPG

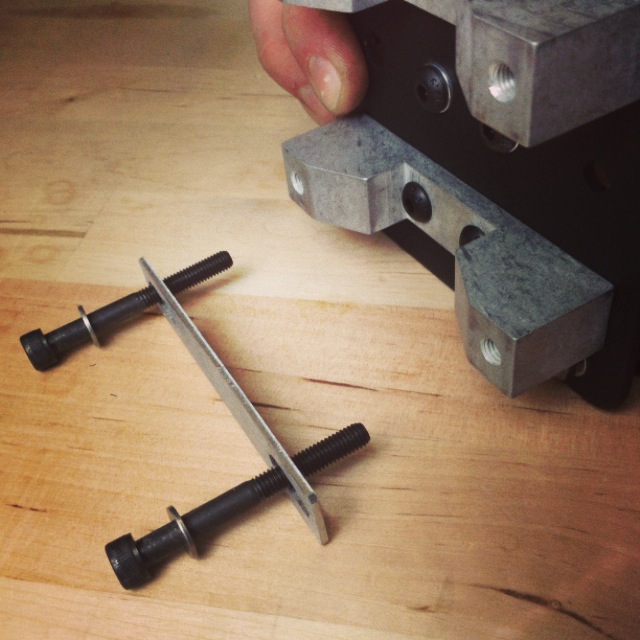
content/oPictures/gonzoBuildImages/IMG_0253.JPG
