shapeoko/Docs/content/oPictures/gonzoBuildImages/IMG_0254.JPG

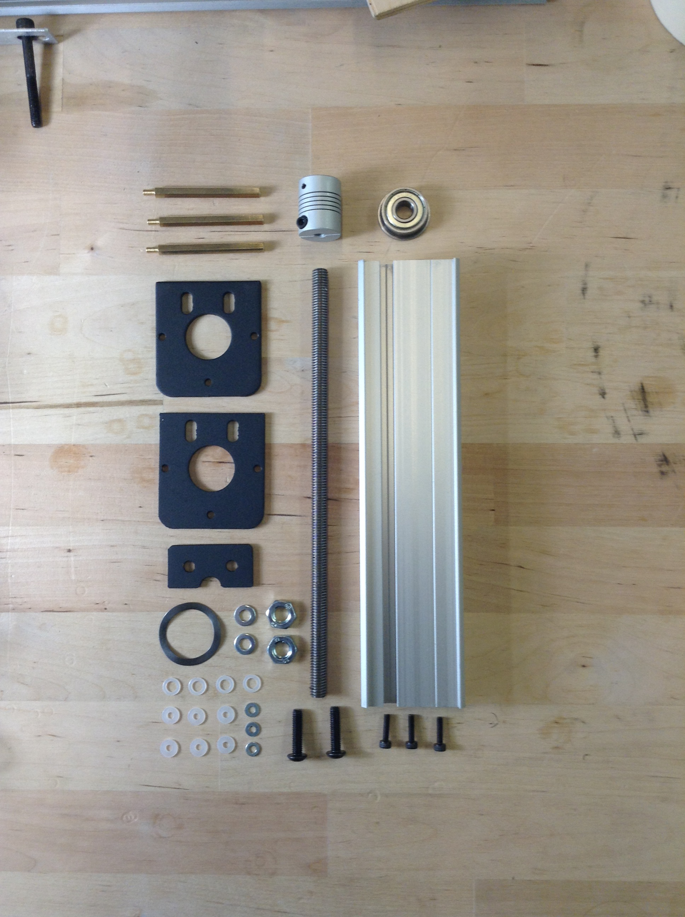
content/oPictures/gonzoBuildImages/IMG_0254.JPG
