shapeoko/Docs/content/oPictures/gonzoBuildImages/IMG_0255.JPG

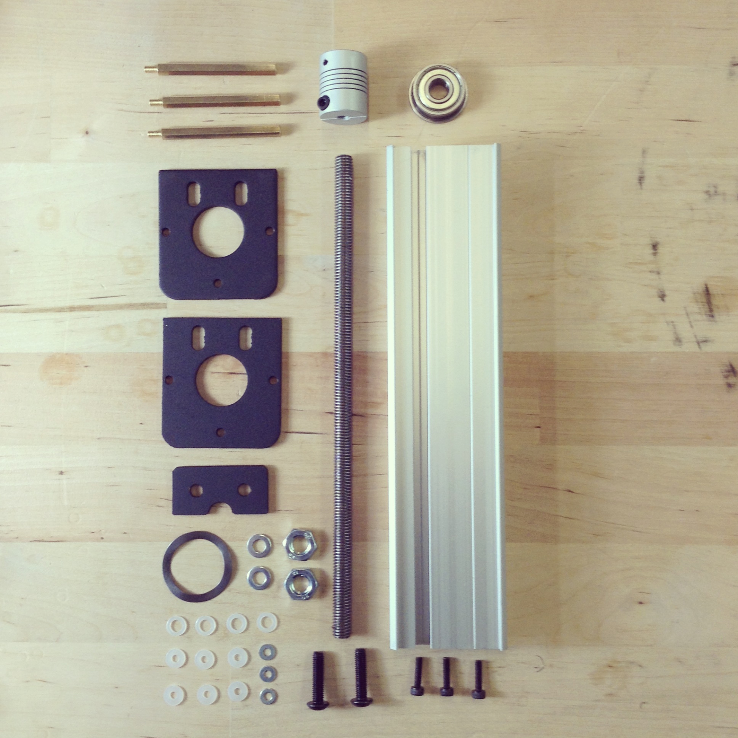
content/oPictures/gonzoBuildImages/IMG_0255.JPG
