shapeoko/Docs/content/oPictures/gonzoBuildImages/IMG_0256.JPG

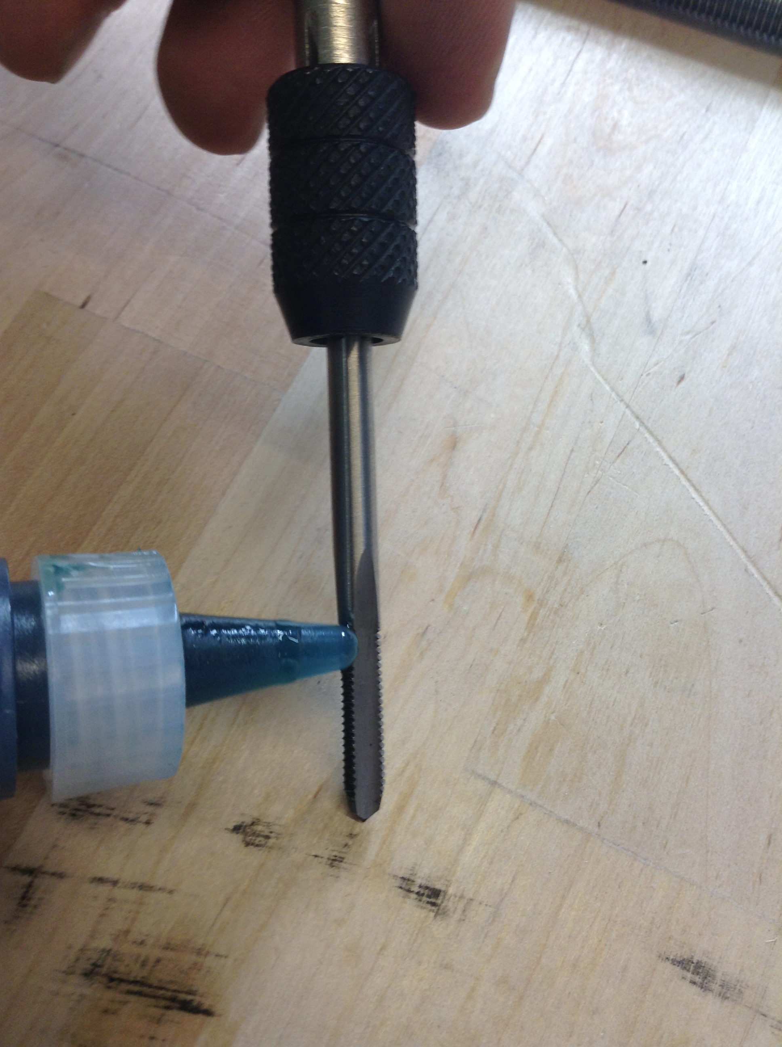
content/oPictures/gonzoBuildImages/IMG_0256.JPG
