shapeoko/Docs/content/oPictures/gonzoBuildImages/IMG_0257.JPG

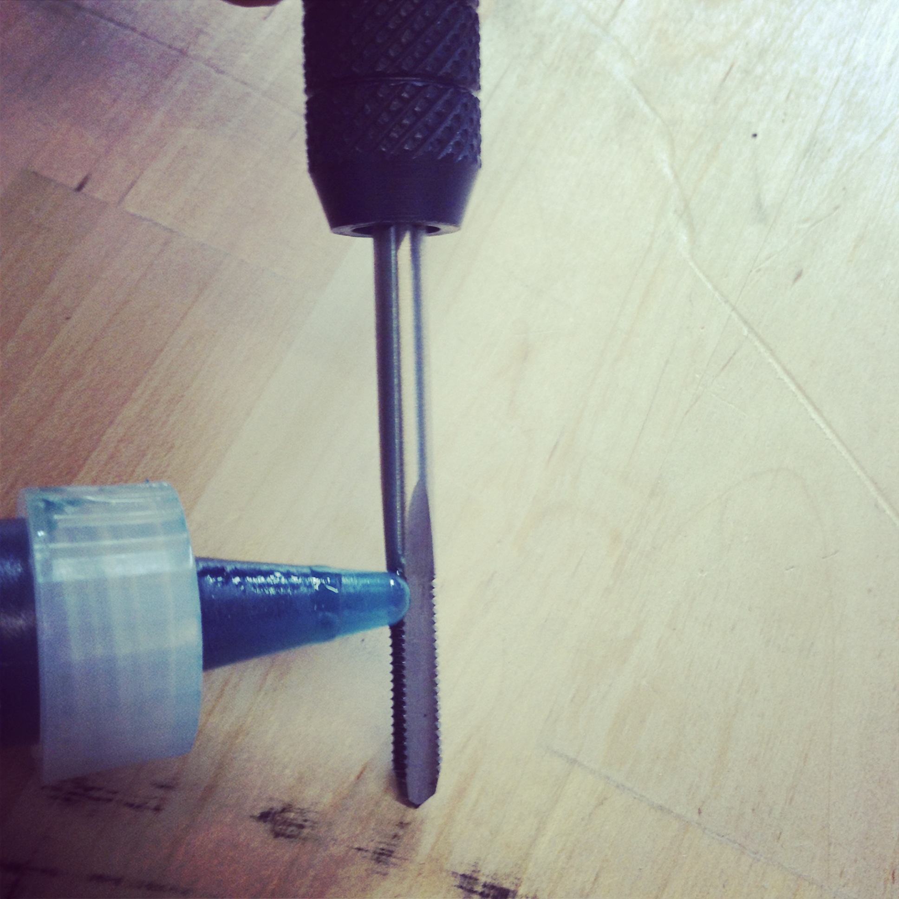
content/oPictures/gonzoBuildImages/IMG_0257.JPG
