shapeoko/Docs/content/oPictures/gonzoBuildImages/IMG_0258.JPG

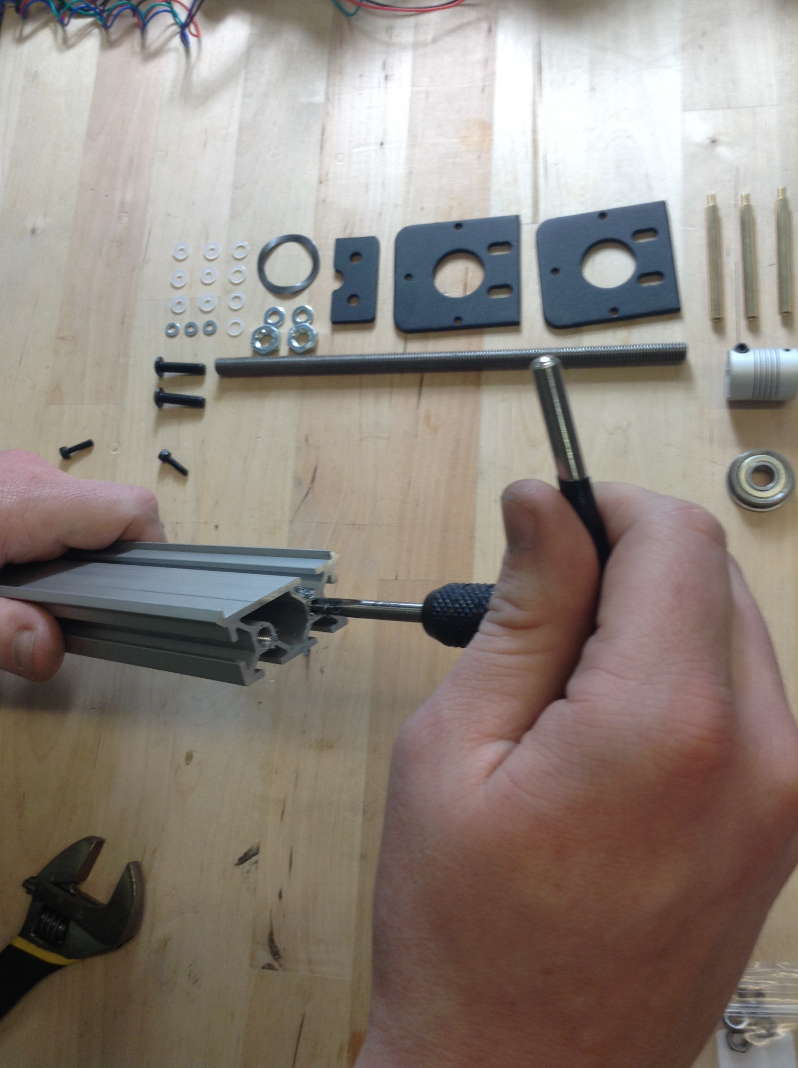
content/oPictures/gonzoBuildImages/IMG_0258.JPG
