shapeoko/Docs/content/oPictures/gonzoBuildImages/IMG_0259.JPG

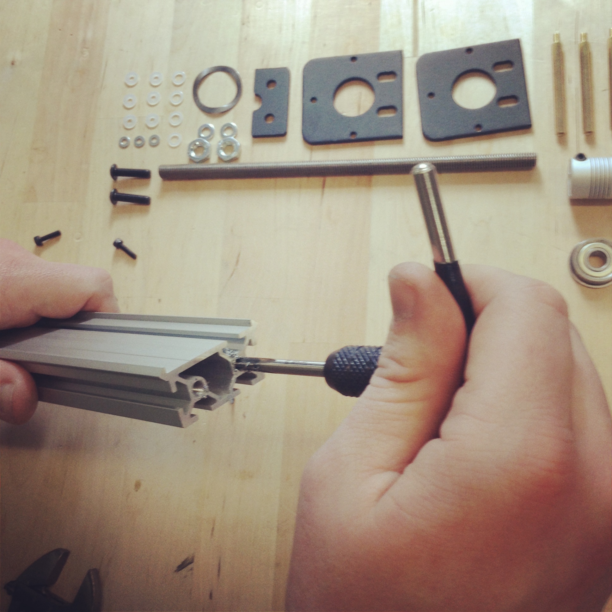
content/oPictures/gonzoBuildImages/IMG_0259.JPG
