shapeoko/Docs/content/oPictures/gonzoBuildImages/IMG_0260.JPG

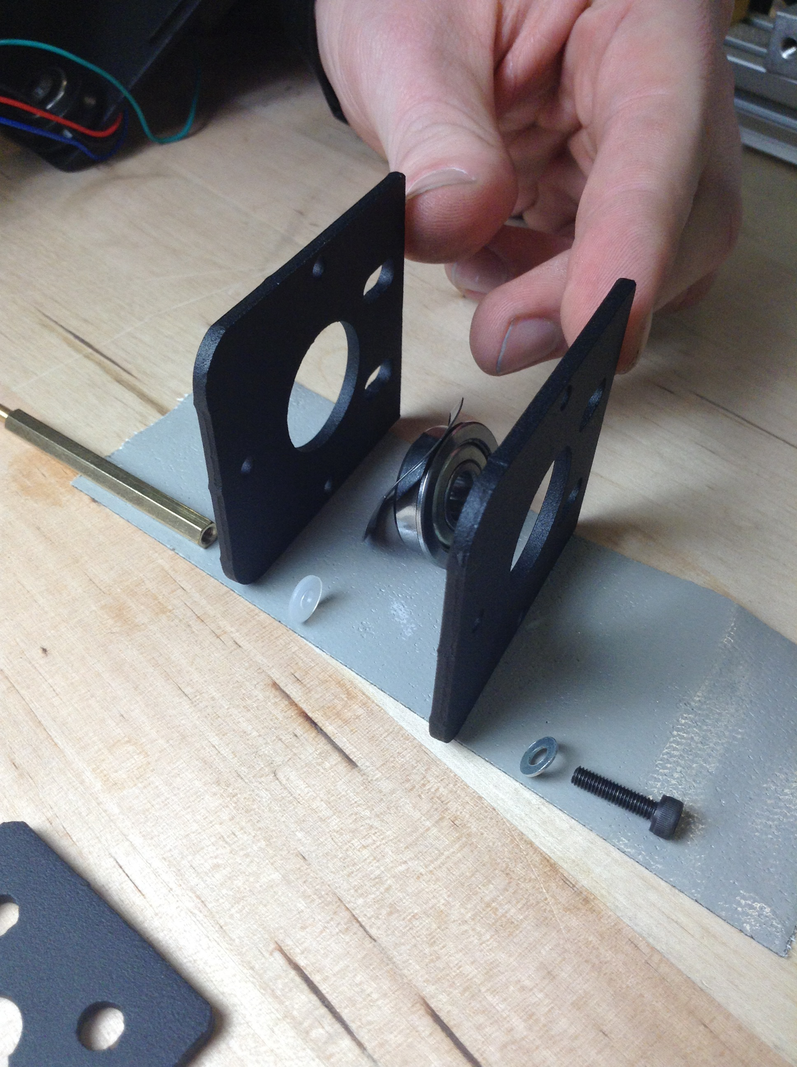
content/oPictures/gonzoBuildImages/IMG_0260.JPG
