shapeoko/Docs/content/oPictures/gonzoBuildImages/IMG_0261.JPG

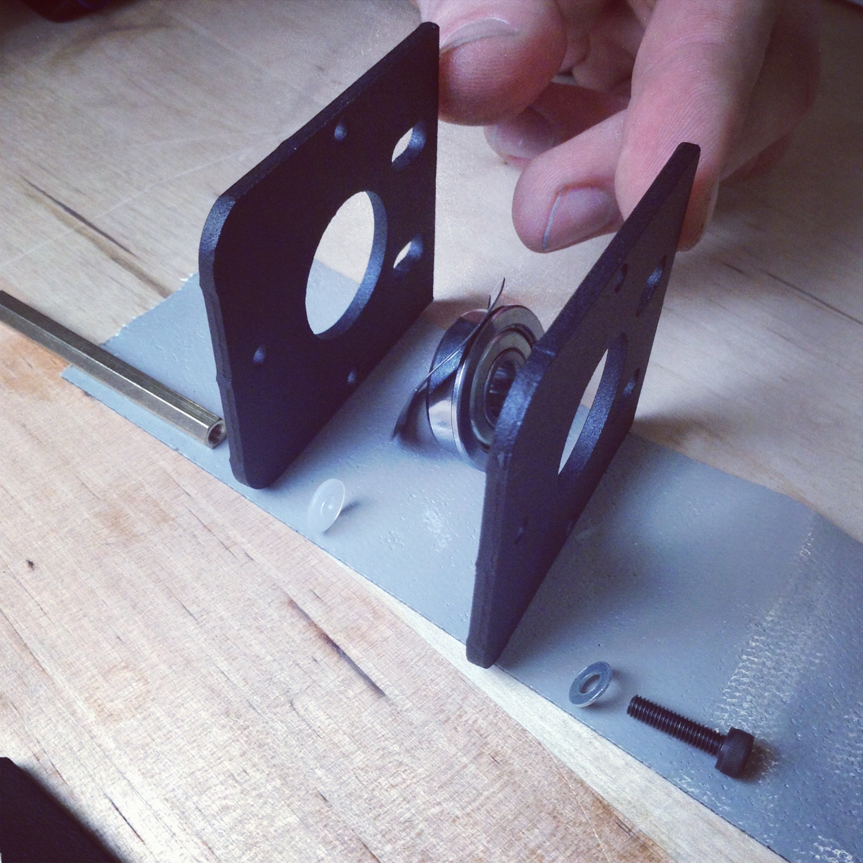
content/oPictures/gonzoBuildImages/IMG_0261.JPG
