shapeoko/Docs/content/oPictures/gonzoBuildImages/IMG_0263.JPG

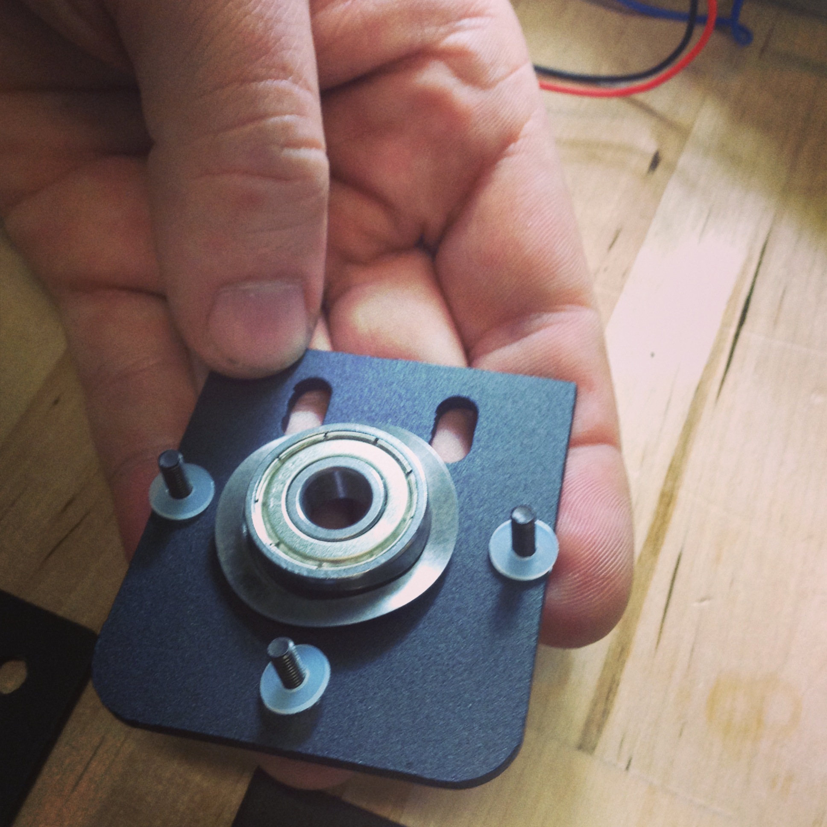
content/oPictures/gonzoBuildImages/IMG_0263.JPG
