shapeoko/Docs/content/oPictures/gonzoBuildImages/IMG_0264.JPG

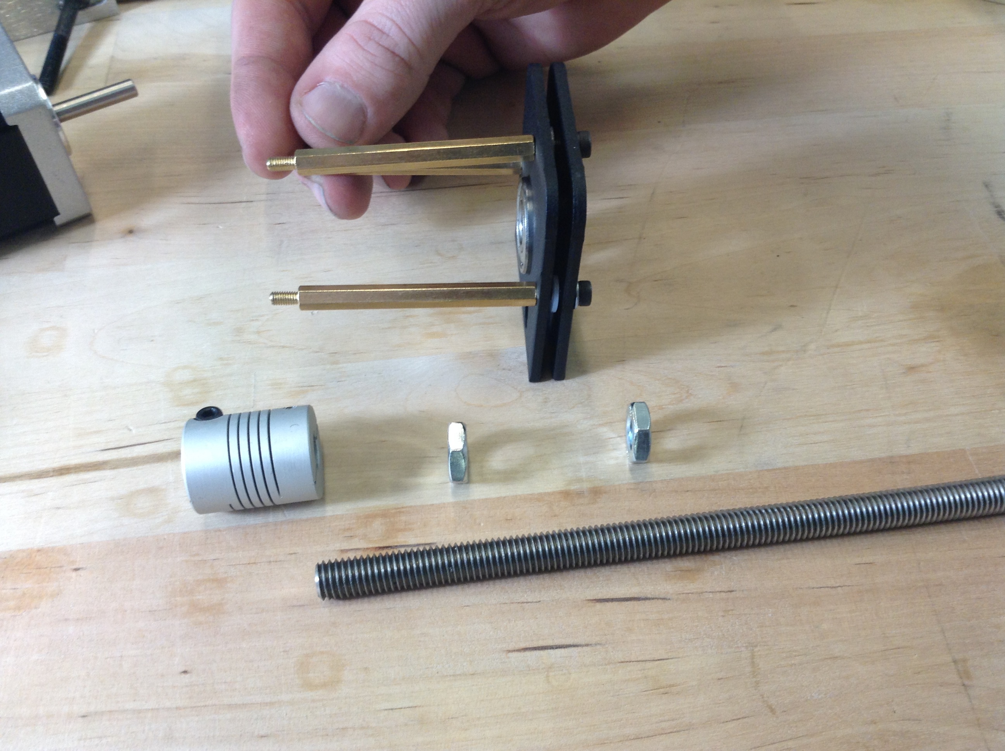
content/oPictures/gonzoBuildImages/IMG_0264.JPG
