shapeoko/Docs/content/oPictures/gonzoBuildImages/IMG_0266.JPG

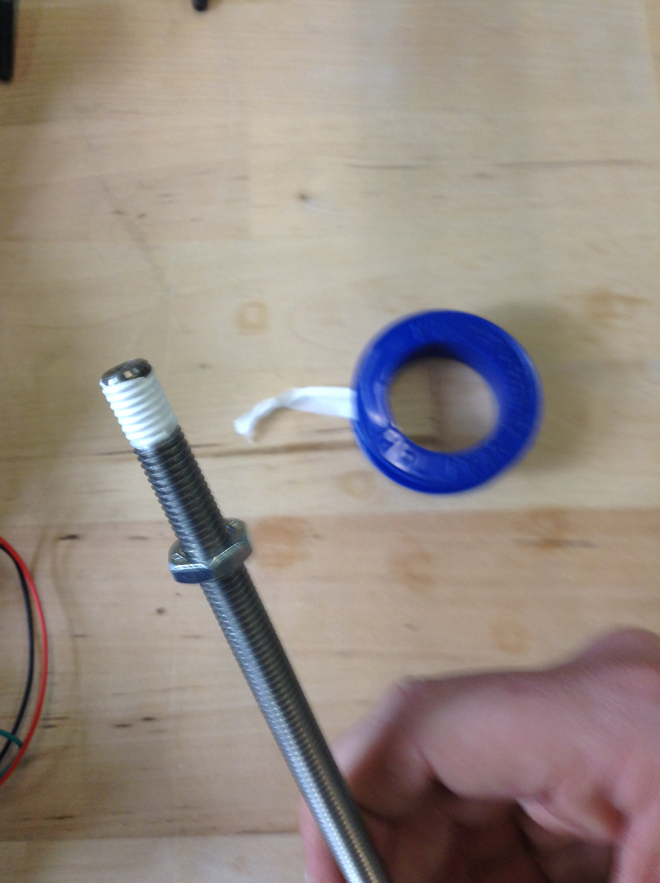
content/oPictures/gonzoBuildImages/IMG_0266.JPG
