shapeoko/Docs/content/oPictures/gonzoBuildImages/IMG_0267.JPG

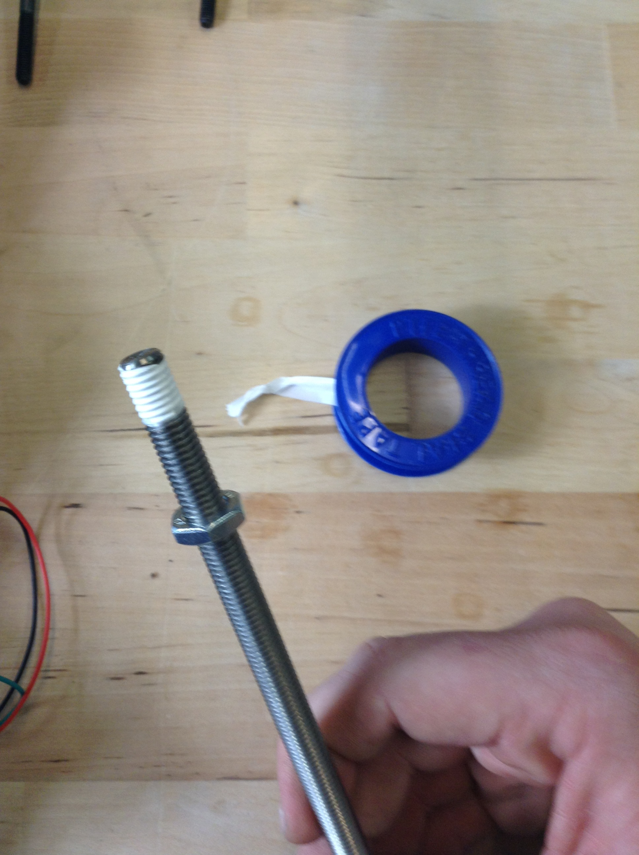
content/oPictures/gonzoBuildImages/IMG_0267.JPG
