shapeoko/Docs/content/oPictures/gonzoBuildImages/IMG_0268.JPG

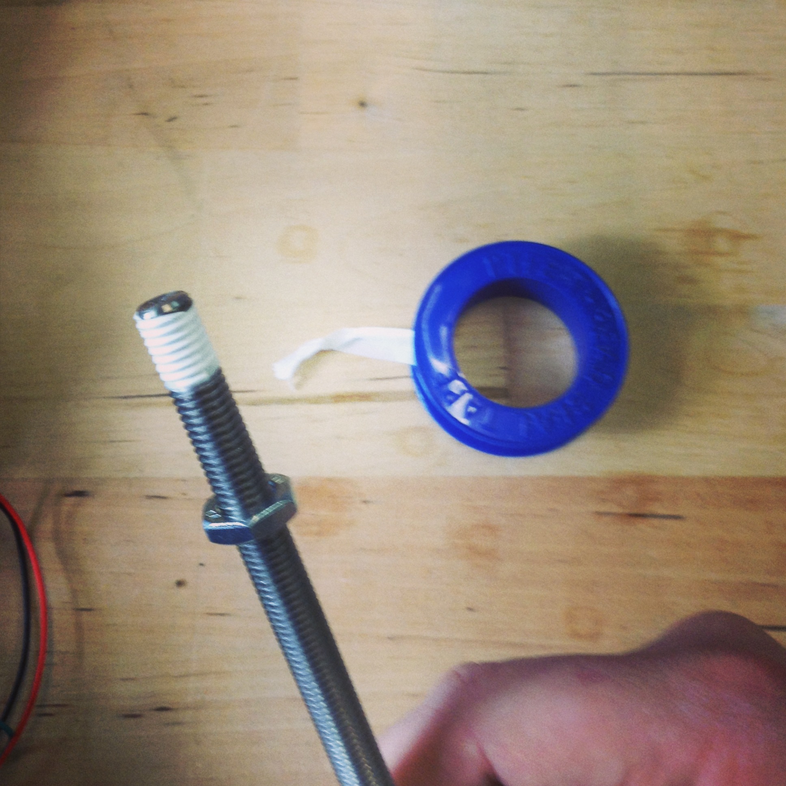
content/oPictures/gonzoBuildImages/IMG_0268.JPG
