shapeoko/Docs/content/oPictures/gonzoBuildImages/IMG_0269.JPG

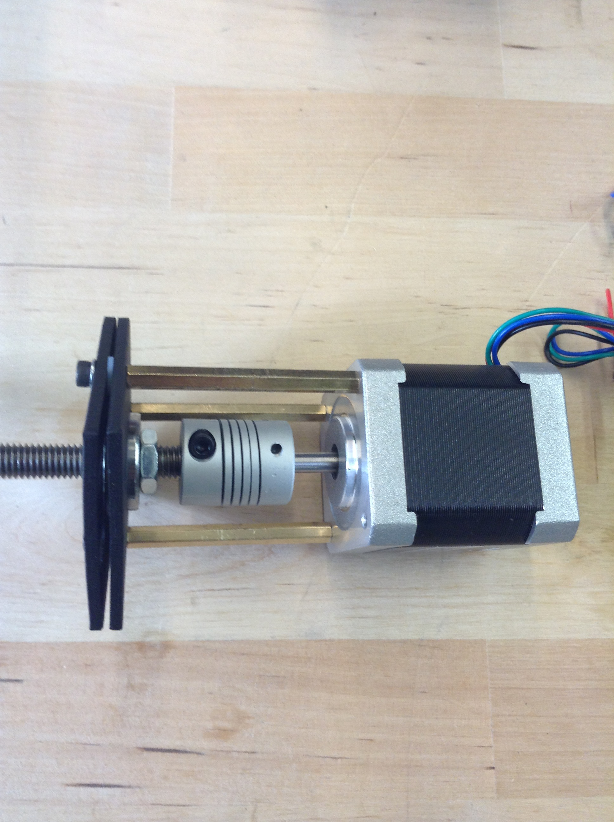
content/oPictures/gonzoBuildImages/IMG_0269.JPG
