shapeoko/Docs/content/oPictures/gonzoBuildImages/IMG_0270.JPG

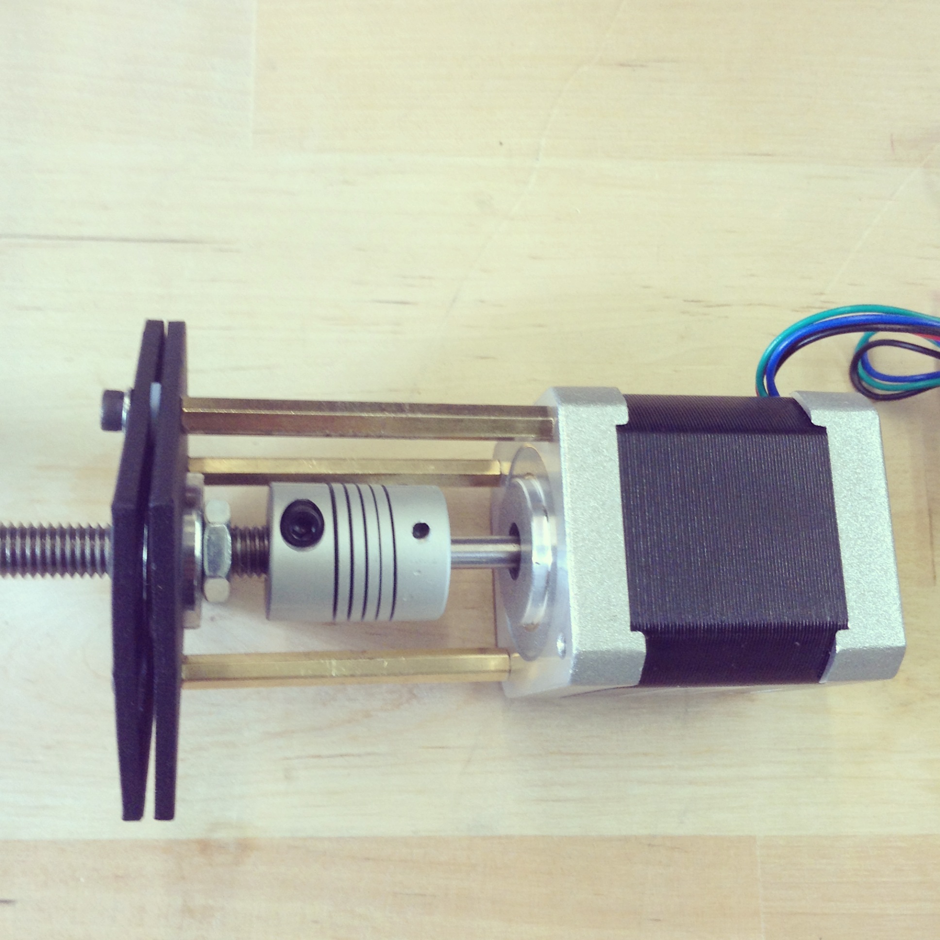
content/oPictures/gonzoBuildImages/IMG_0270.JPG
