shapeoko/Docs/content/oPictures/gonzoBuildImages/IMG_0272.JPG

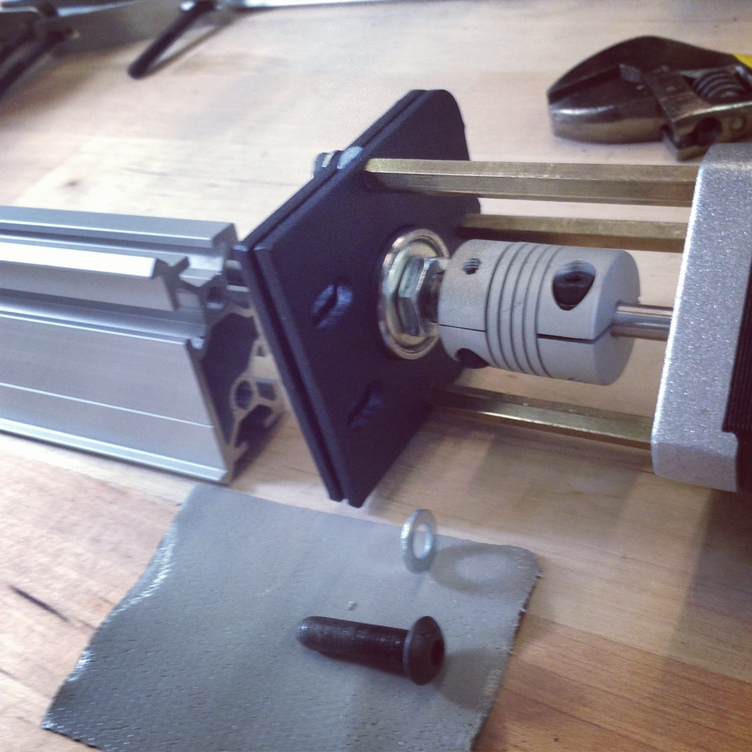
content/oPictures/gonzoBuildImages/IMG_0272.JPG
