shapeoko/Docs/content/oPictures/gonzoBuildImages/IMG_0273.JPG

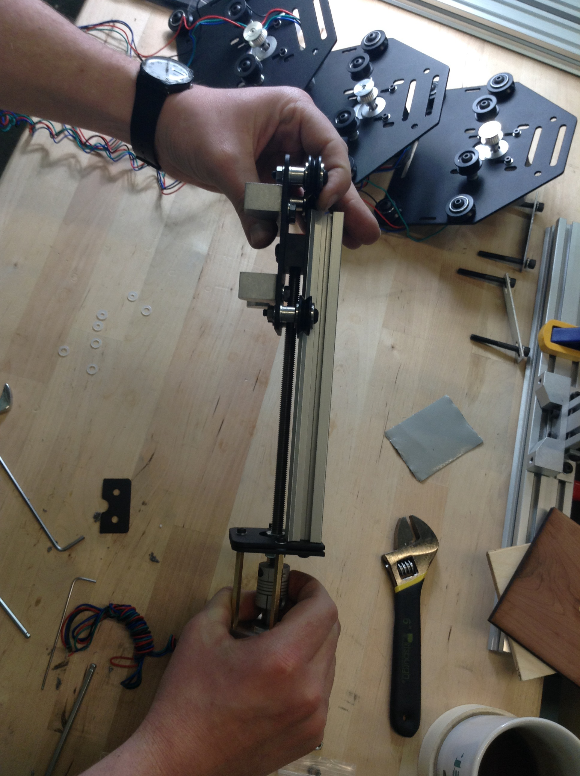
content/oPictures/gonzoBuildImages/IMG_0273.JPG
