shapeoko/Docs/content/oPictures/gonzoBuildImages/IMG_0274.JPG

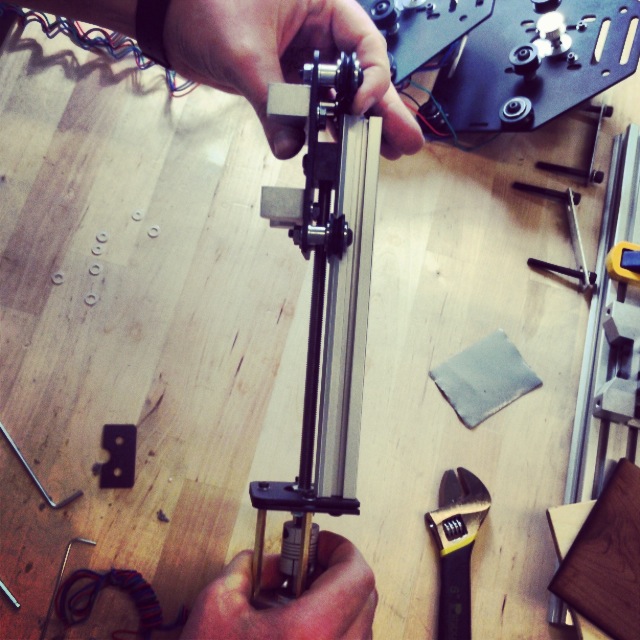
content/oPictures/gonzoBuildImages/IMG_0274.JPG
