shapeoko/Docs/content/oPictures/gonzoBuildImages/IMG_0275.JPG

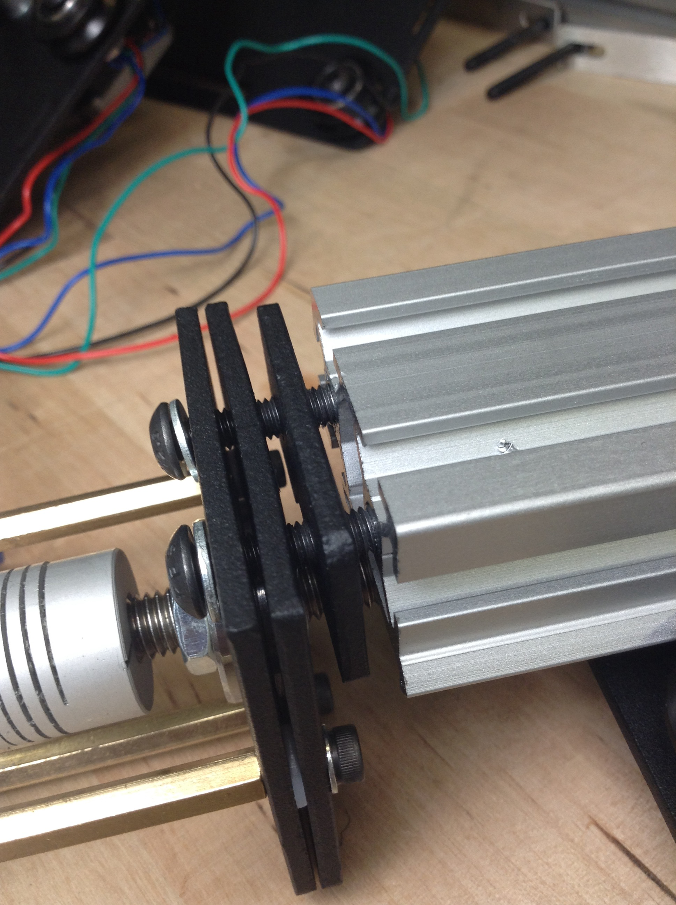
content/oPictures/gonzoBuildImages/IMG_0275.JPG
