shapeoko/Docs/content/oPictures/gonzoBuildImages/IMG_0276.JPG

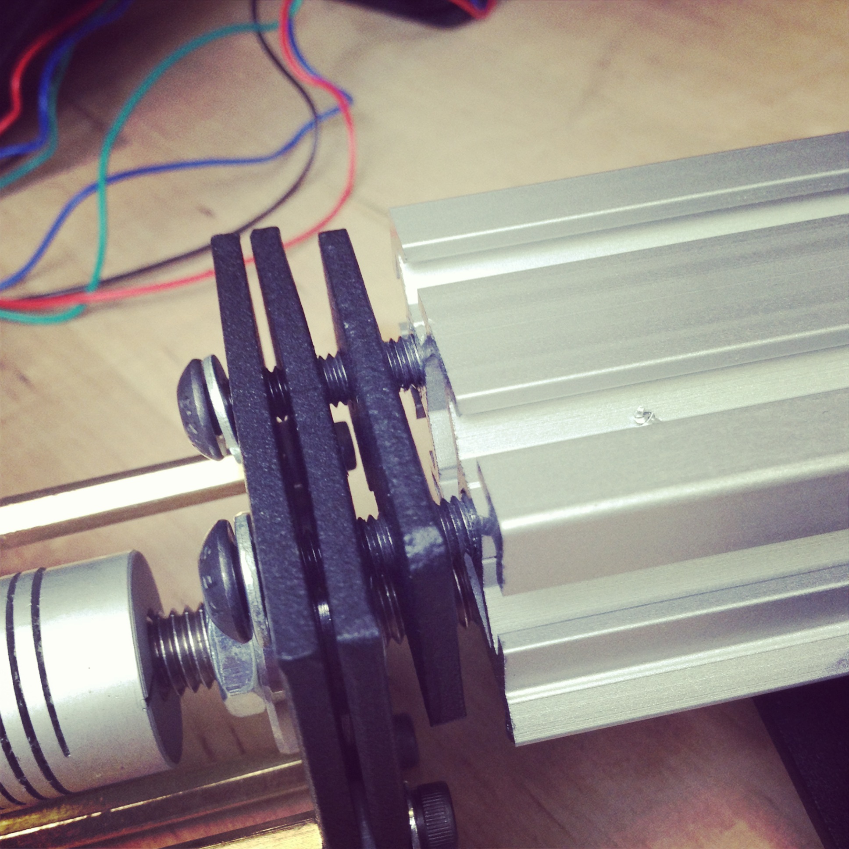
content/oPictures/gonzoBuildImages/IMG_0276.JPG
