shapeoko/Docs/content/oPictures/gonzoBuildImages/IMG_0277.JPG

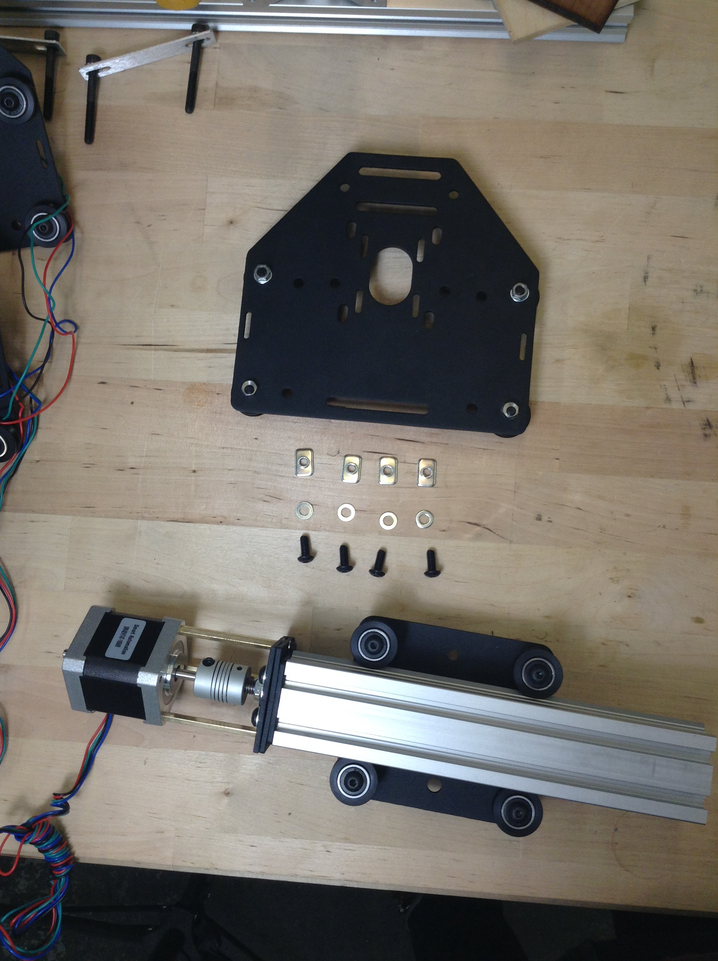
content/oPictures/gonzoBuildImages/IMG_0277.JPG
