shapeoko/Docs/content/oPictures/gonzoBuildImages/IMG_0278.JPG

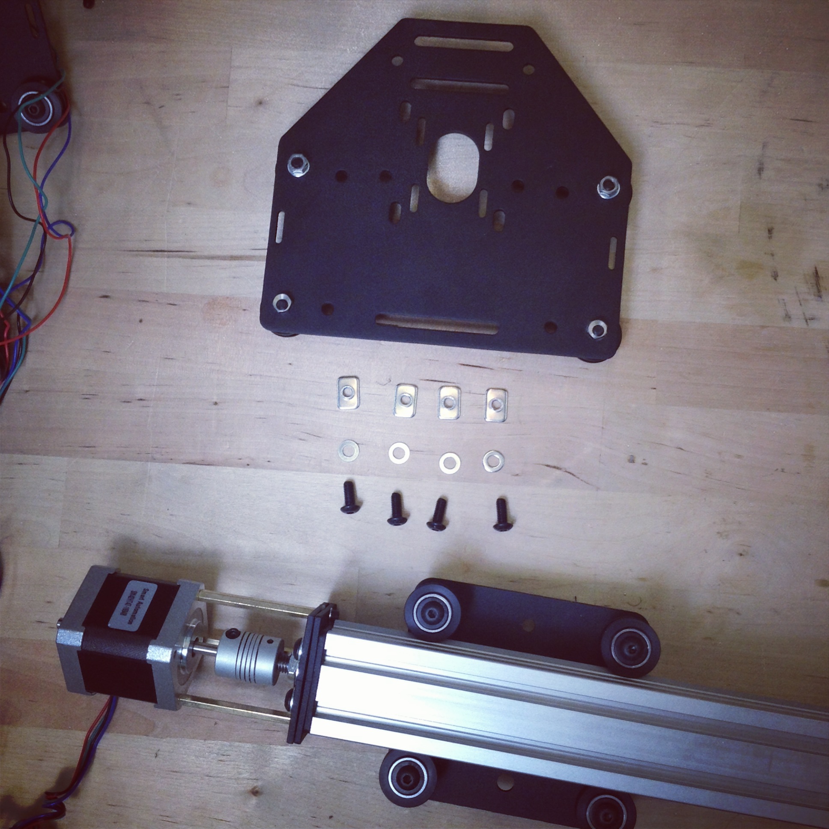
content/oPictures/gonzoBuildImages/IMG_0278.JPG
