shapeoko/Docs/content/oPictures/gonzoBuildImages/IMG_0279.JPG

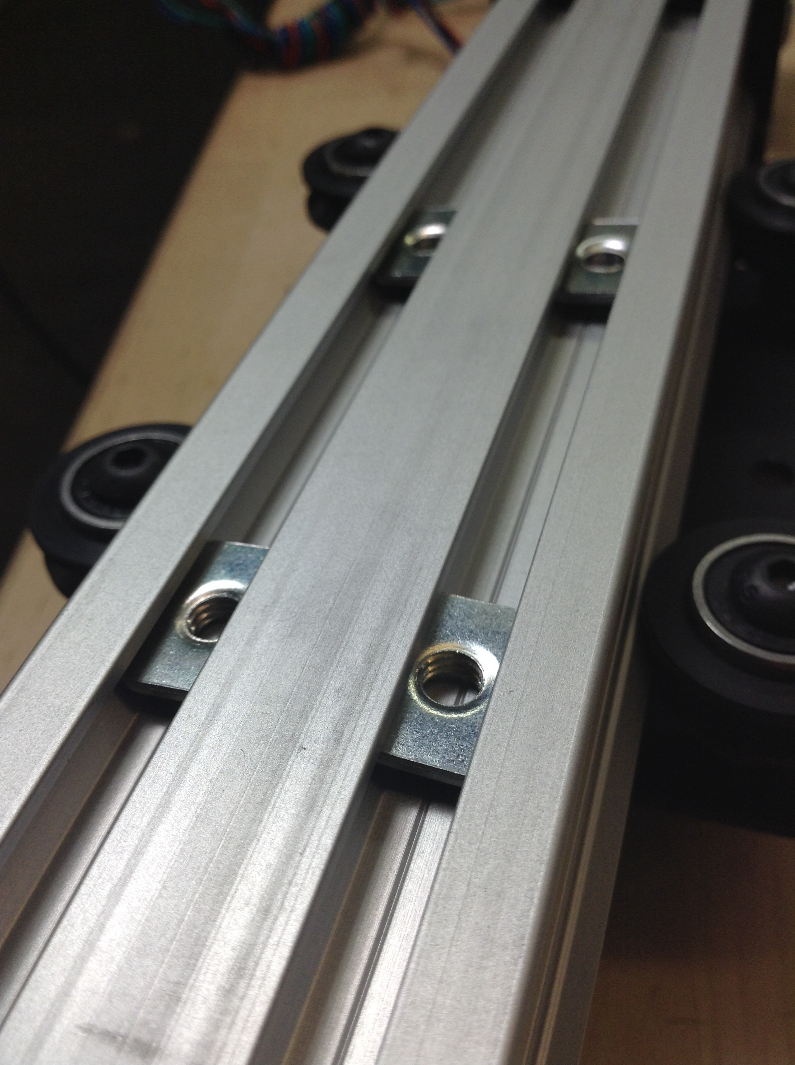
content/oPictures/gonzoBuildImages/IMG_0279.JPG
