shapeoko/Docs/content/oPictures/gonzoBuildImages/IMG_0280.JPG

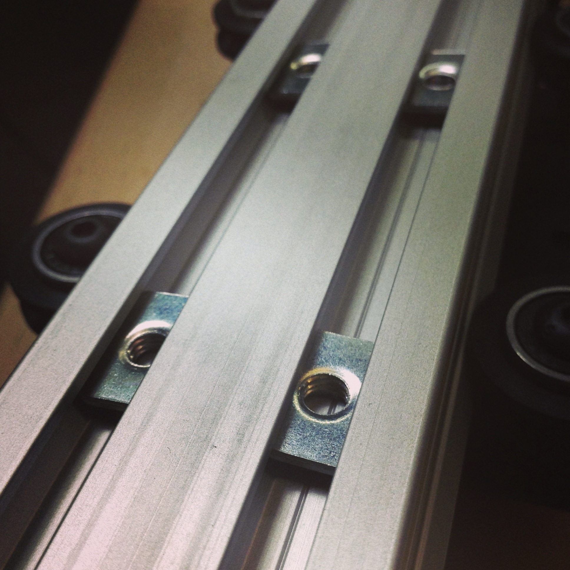
content/oPictures/gonzoBuildImages/IMG_0280.JPG
