shapeoko/Docs/content/oPictures/gonzoBuildImages/IMG_0282.JPG

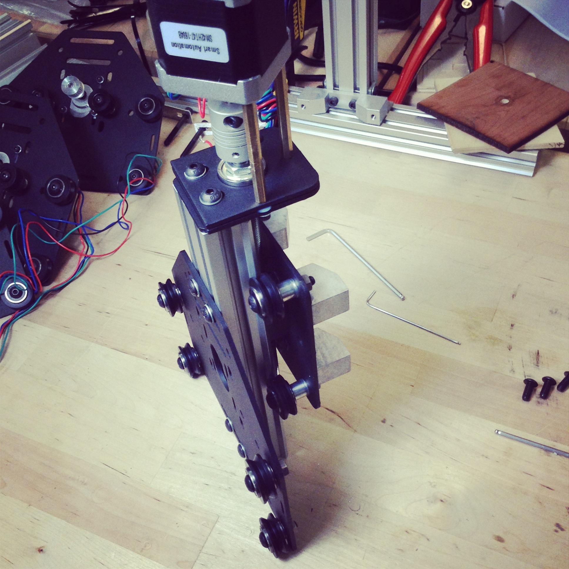
content/oPictures/gonzoBuildImages/IMG_0282.JPG
