shapeoko/Docs/content/oPictures/gonzoBuildImages/IMG_0283.JPG

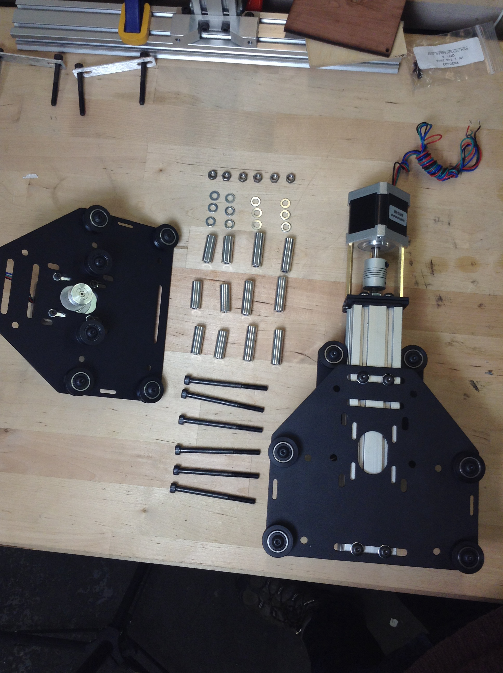
content/oPictures/gonzoBuildImages/IMG_0283.JPG
