shapeoko/Docs/content/oPictures/gonzoBuildImages/IMG_0285.JPG

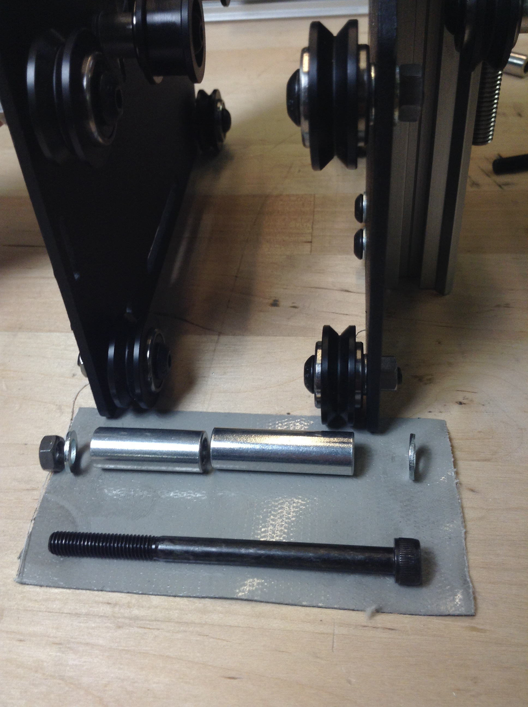
content/oPictures/gonzoBuildImages/IMG_0285.JPG
