shapeoko/Docs/content/oPictures/gonzoBuildImages/IMG_0286.JPG

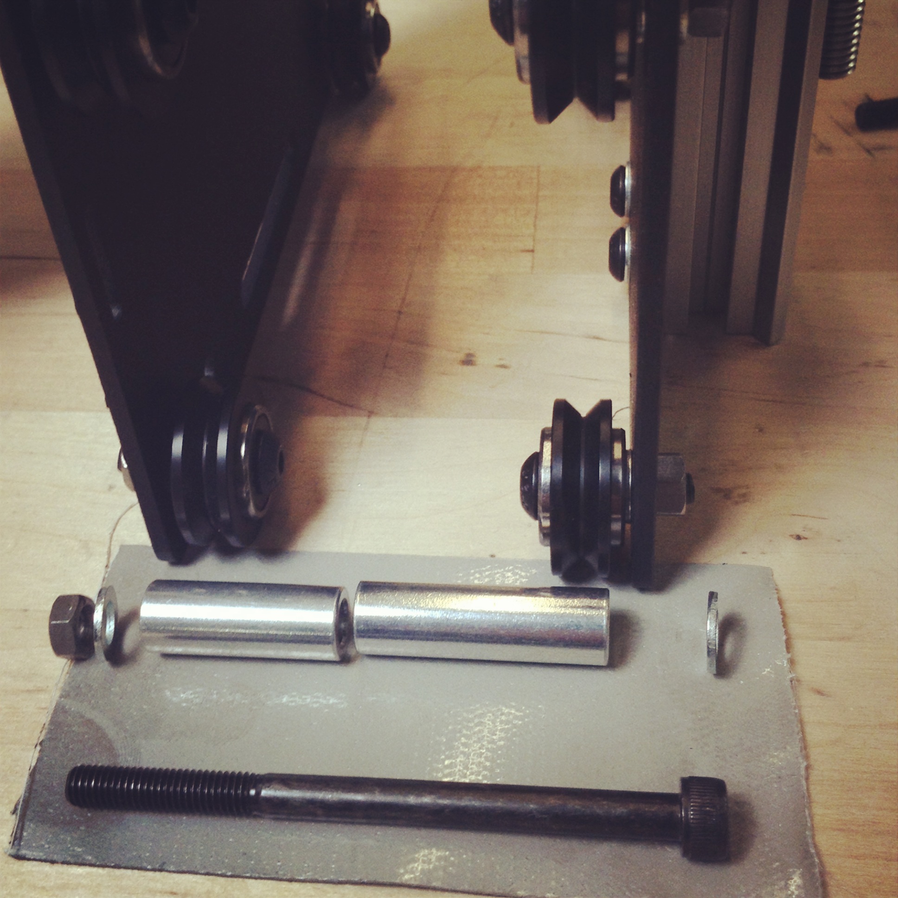
content/oPictures/gonzoBuildImages/IMG_0286.JPG
