shapeoko/Docs/content/oPictures/gonzoBuildImages/IMG_0287.JPG

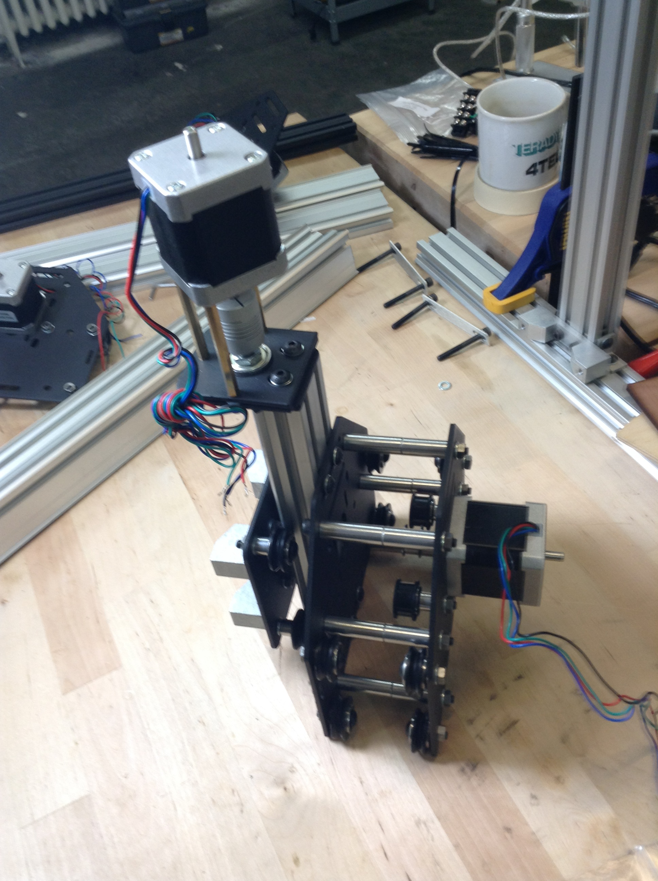
content/oPictures/gonzoBuildImages/IMG_0287.JPG
