shapeoko/Docs/content/oPictures/gonzoBuildImages/IMG_0288.JPG

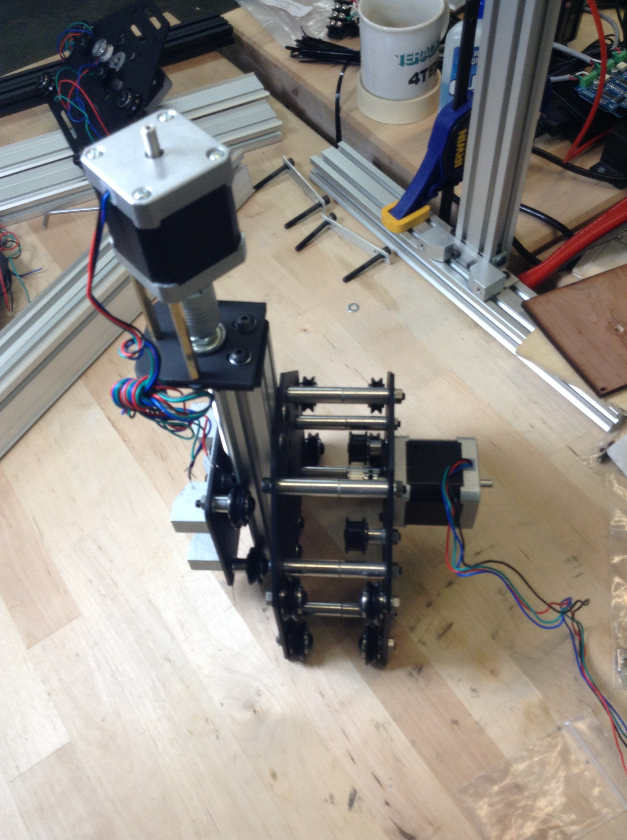
content/oPictures/gonzoBuildImages/IMG_0288.JPG
