shapeoko/Docs/content/oPictures/gonzoBuildImages/IMG_0289.JPG

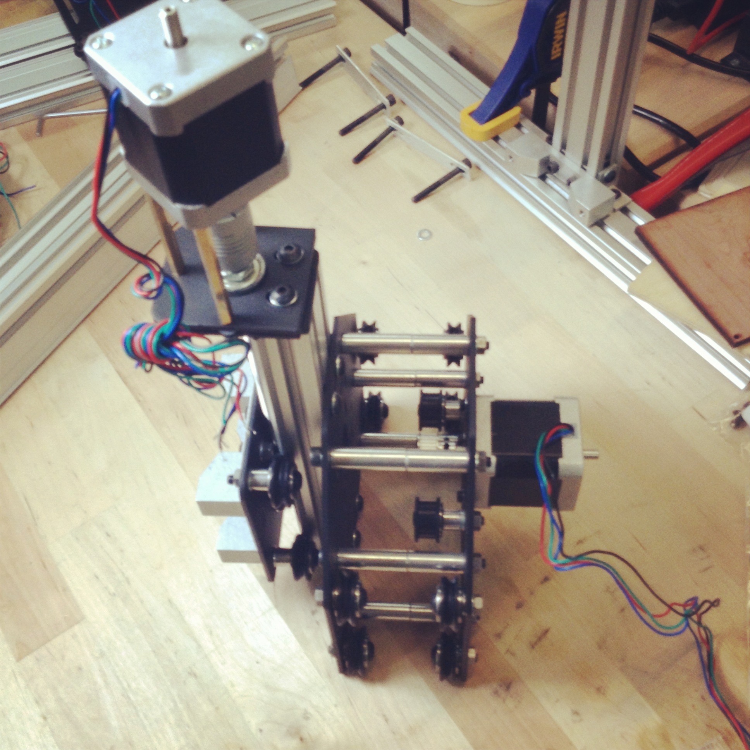
content/oPictures/gonzoBuildImages/IMG_0289.JPG
