shapeoko/Docs/content/oPictures/gonzoBuildImages/IMG_0290.JPG

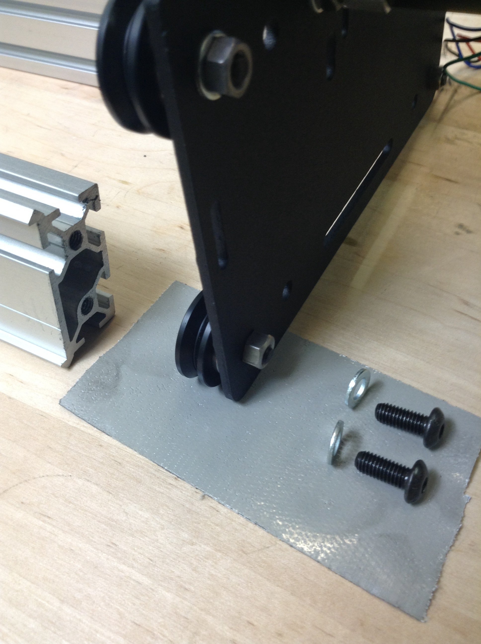
content/oPictures/gonzoBuildImages/IMG_0290.JPG
