shapeoko/Docs/content/oPictures/gonzoBuildImages/IMG_0292.JPG

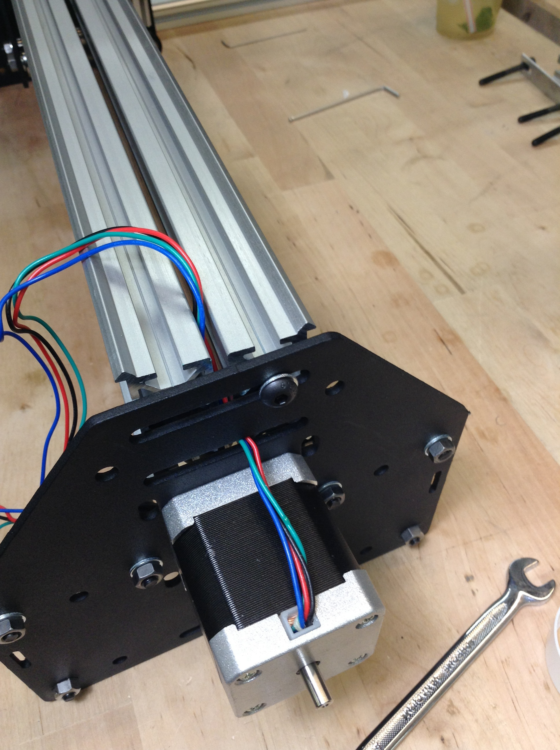
content/oPictures/gonzoBuildImages/IMG_0292.JPG
