shapeoko/Docs/content/oPictures/gonzoBuildImages/IMG_0294.JPG

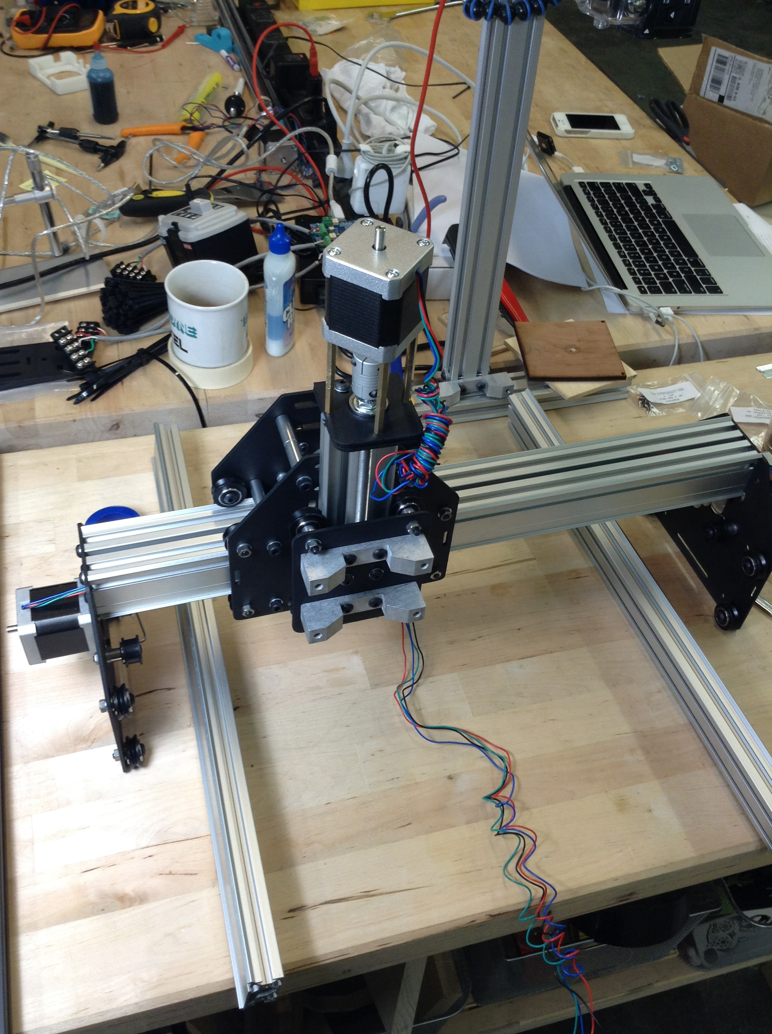
content/oPictures/gonzoBuildImages/IMG_0294.JPG
