shapeoko/Docs/content/oPictures/gonzoBuildImages/IMG_0296.JPG

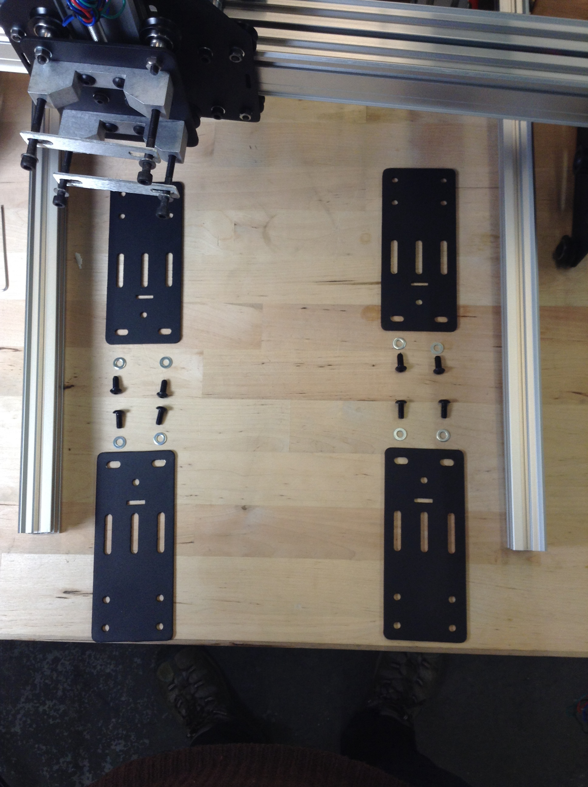
content/oPictures/gonzoBuildImages/IMG_0296.JPG
