shapeoko/Docs/content/oPictures/gonzoBuildImages/IMG_0297.JPG

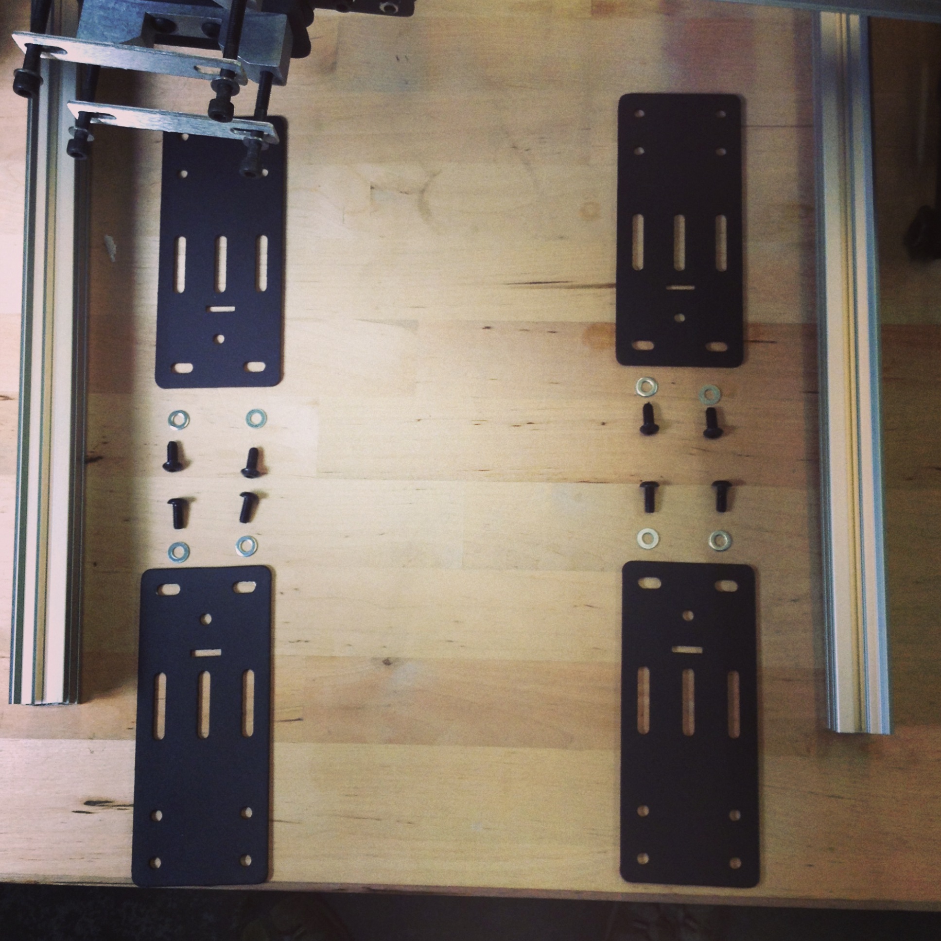
content/oPictures/gonzoBuildImages/IMG_0297.JPG
