shapeoko/Docs/content/oPictures/gonzoBuildImages/IMG_0298.JPG

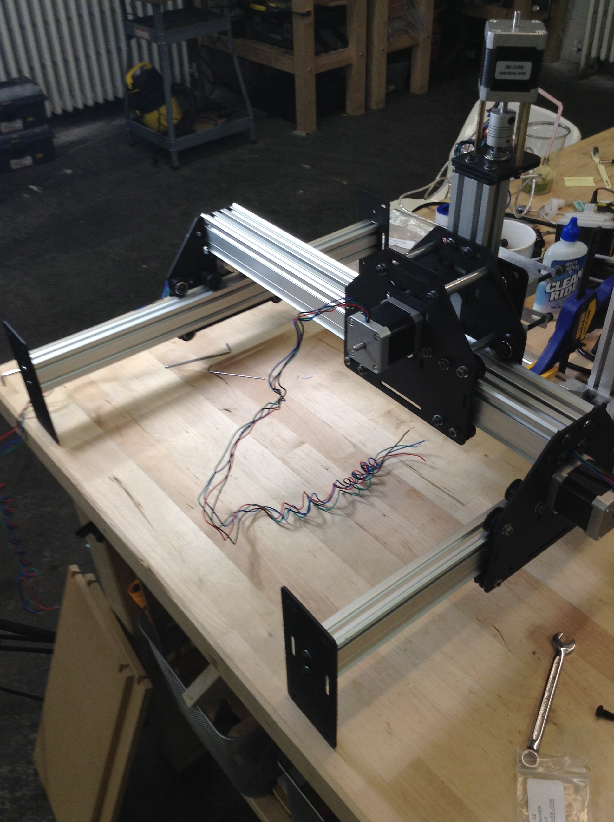
content/oPictures/gonzoBuildImages/IMG_0298.JPG
