shapeoko/Docs/content/oPictures/gonzoBuildImages/IMG_0300.JPG

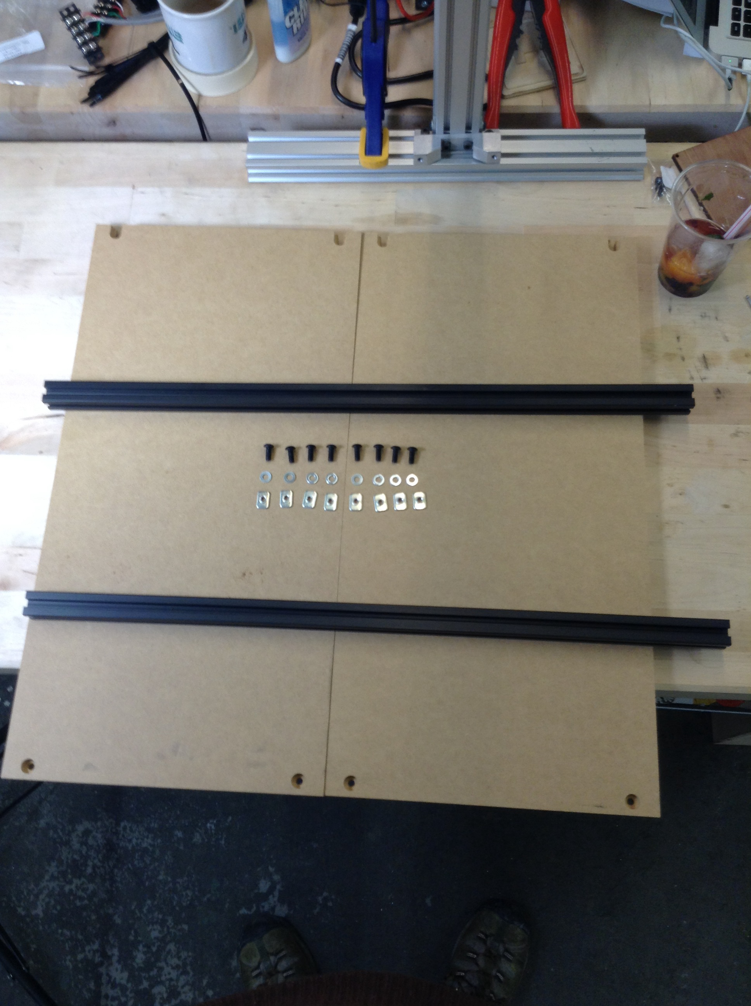
content/oPictures/gonzoBuildImages/IMG_0300.JPG
