shapeoko/Docs/content/oPictures/gonzoBuildImages/IMG_0301.JPG

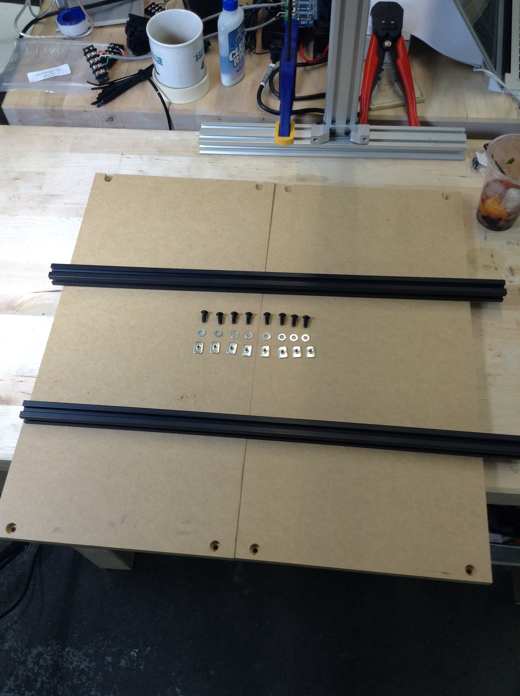
content/oPictures/gonzoBuildImages/IMG_0301.JPG
