shapeoko/Docs/content/oPictures/gonzoBuildImages/IMG_0303.JPG

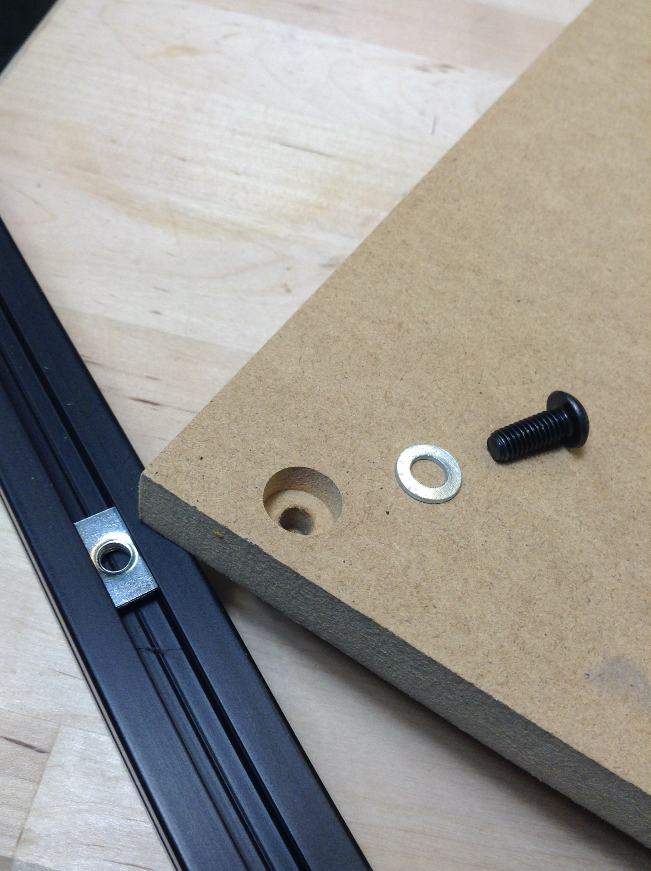
content/oPictures/gonzoBuildImages/IMG_0303.JPG
