shapeoko/Docs/content/oPictures/gonzoBuildImages/IMG_0305.JPG

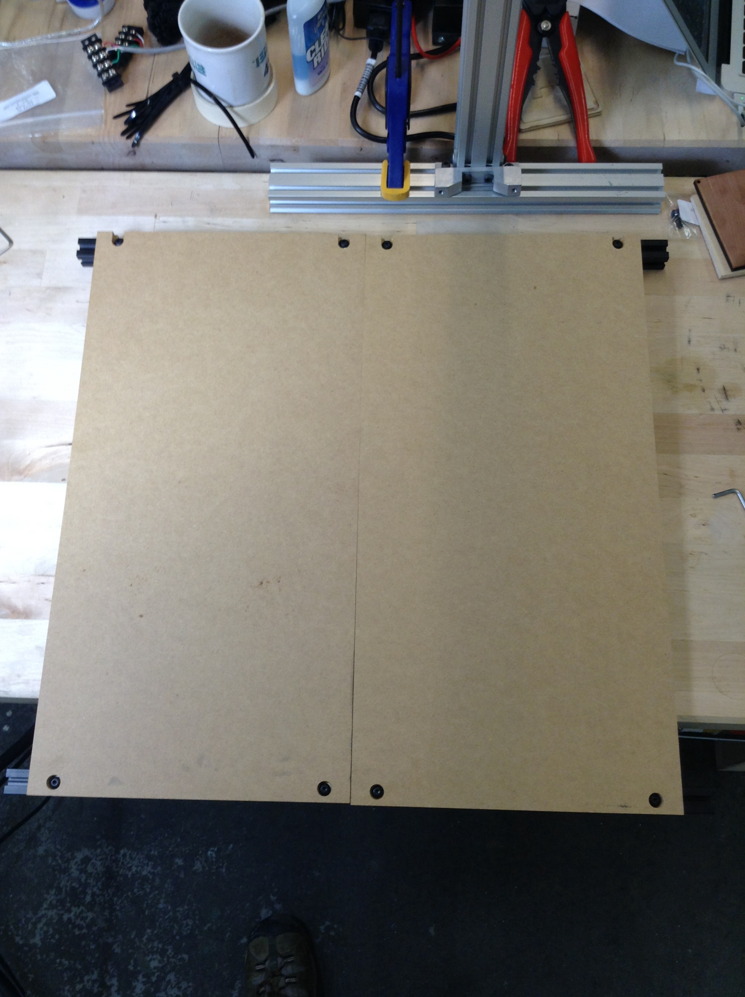
content/oPictures/gonzoBuildImages/IMG_0305.JPG
