shapeoko/Docs/content/oPictures/gonzoBuildImages/IMG_0306.JPG

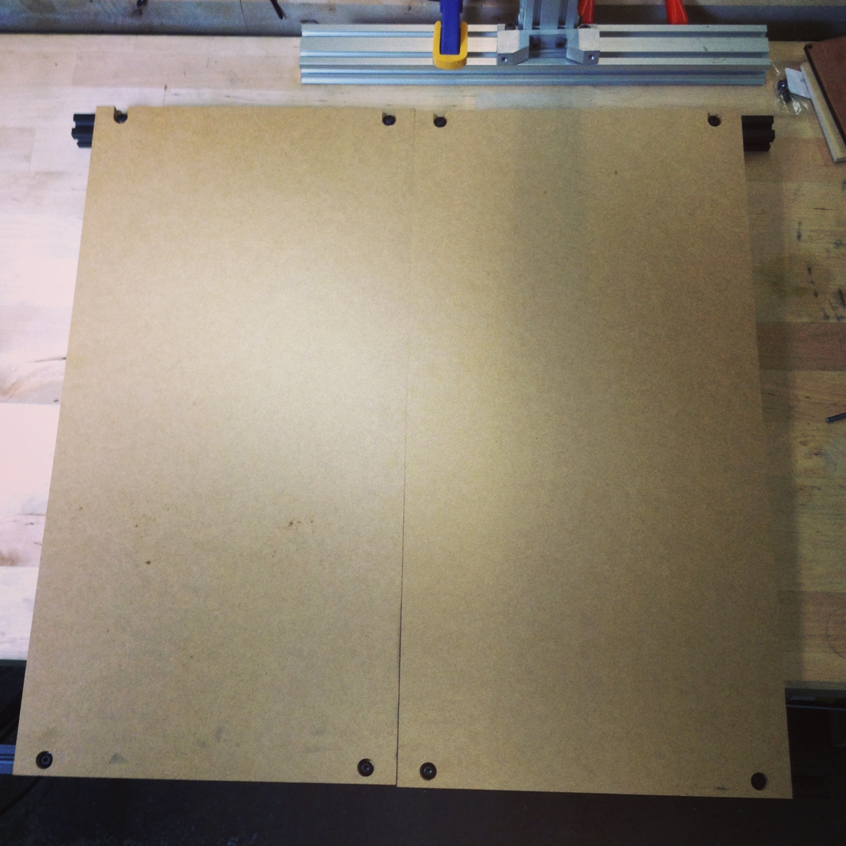
content/oPictures/gonzoBuildImages/IMG_0306.JPG
