shapeoko/Docs/content/oPictures/gonzoBuildImages/IMG_0307.JPG

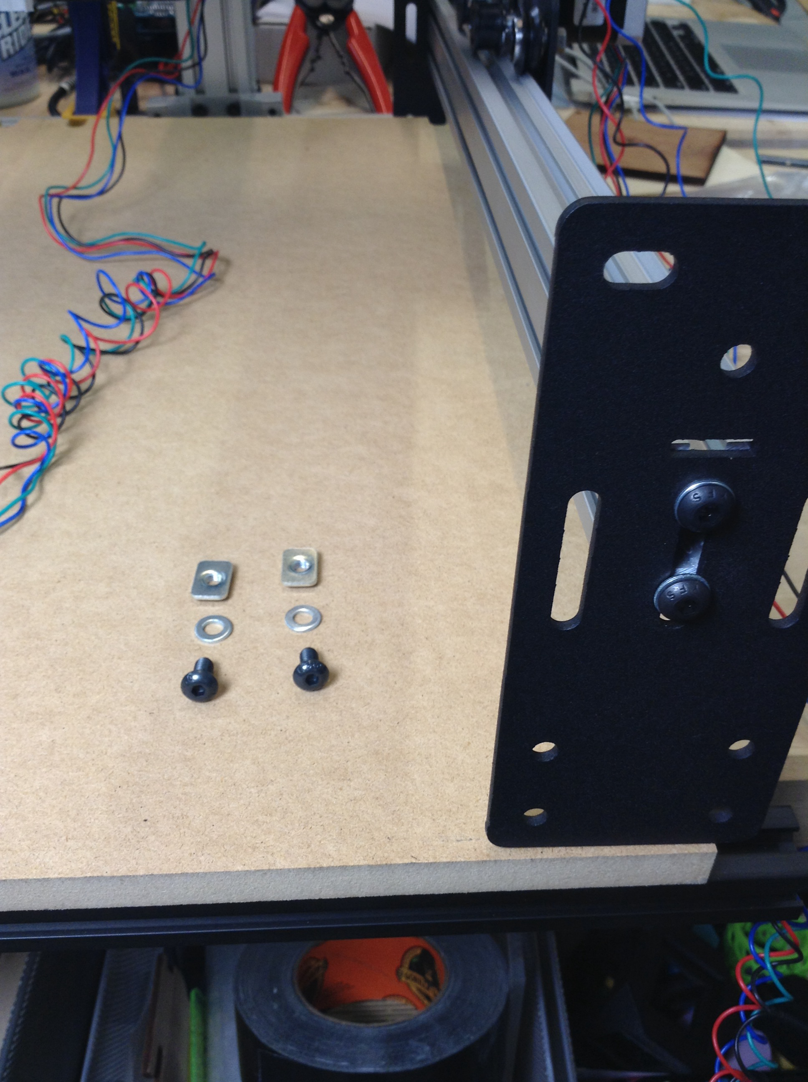
content/oPictures/gonzoBuildImages/IMG_0307.JPG
