shapeoko/Docs/content/oPictures/gonzoBuildImages/IMG_0309.JPG

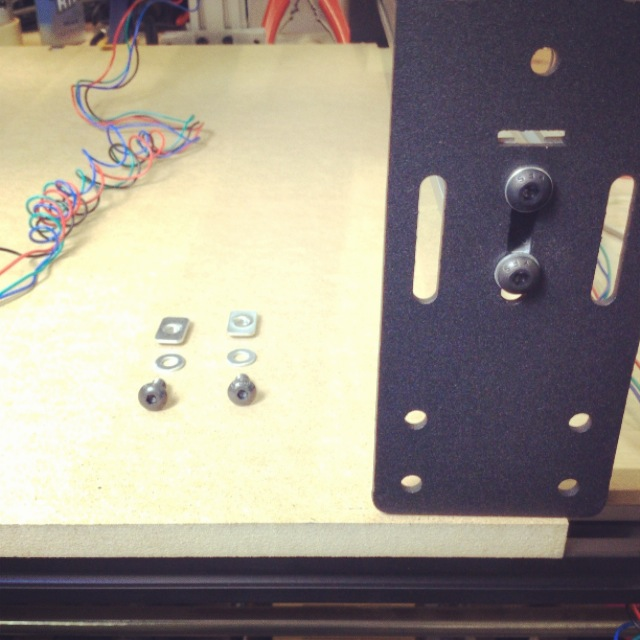
content/oPictures/gonzoBuildImages/IMG_0309.JPG
