shapeoko/Docs/content/oPictures/gonzoBuildImages/IMG_0311.JPG

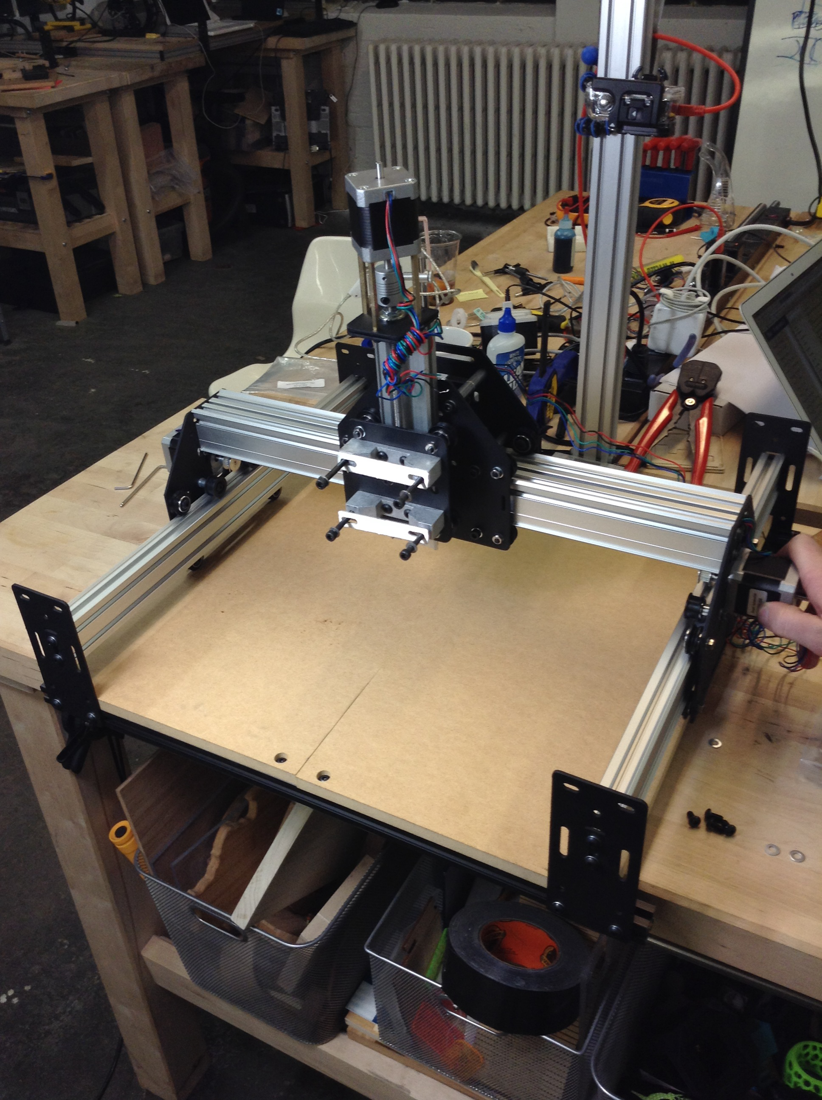
content/oPictures/gonzoBuildImages/IMG_0311.JPG
