shapeoko/Docs/content/oPictures/so_gantry_assembled_wired.JPG

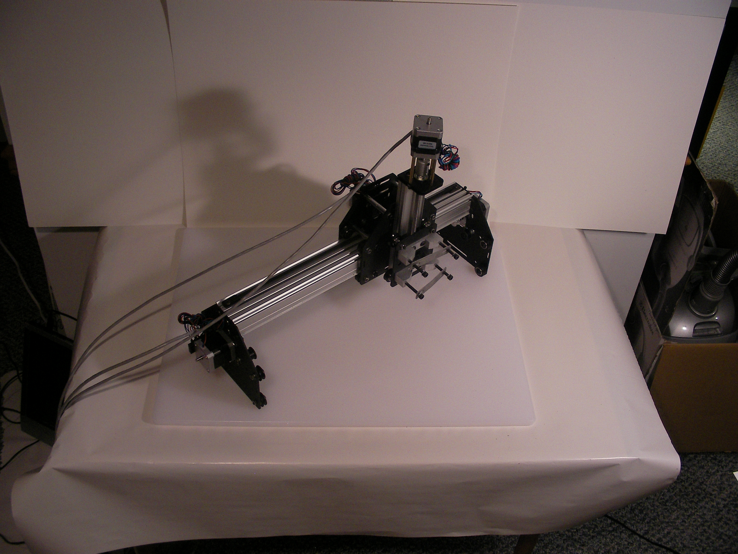
content/oPictures/so_gantry_assembled_wired.JPG
