shapeoko/Docs/content/oPictures/so_wasteboard_assembled.JPG

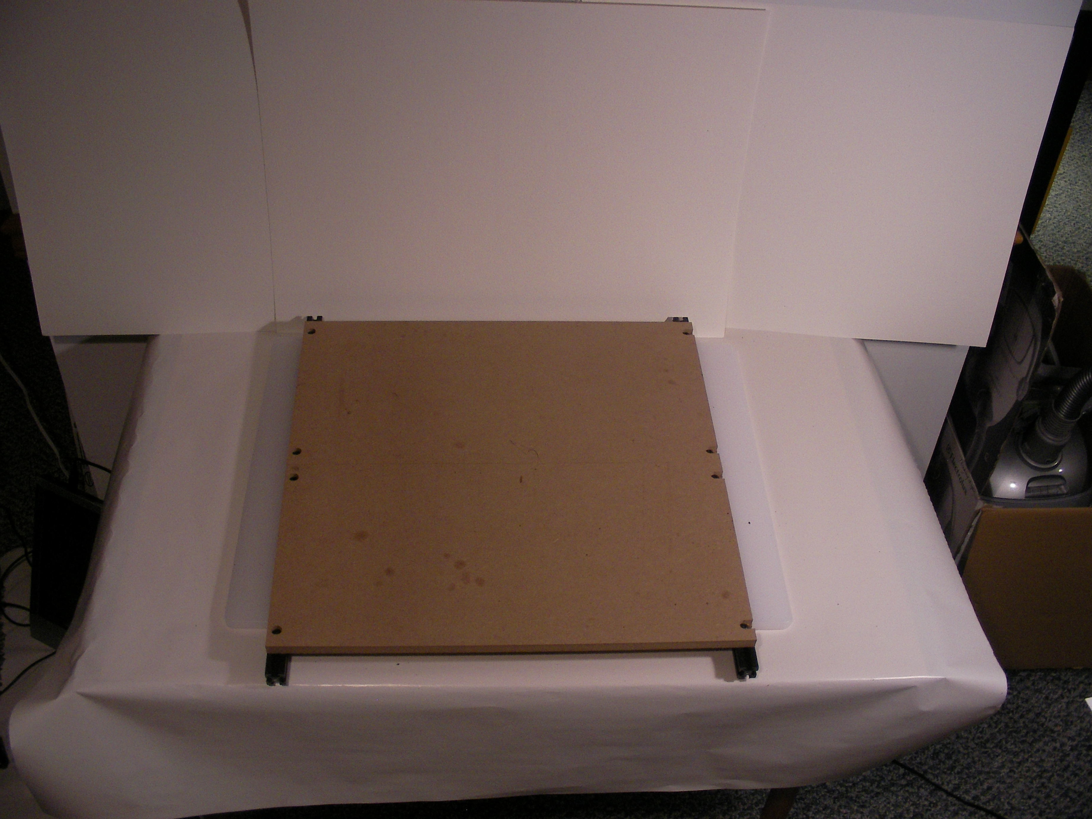
content/oPictures/so_wasteboard_assembled.JPG
