shapeoko/Docs/content/tPictures/so_assembly_pre_gantry_z_axis_2.jpg

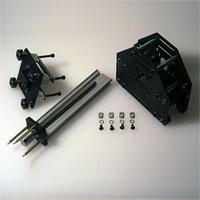
content/tPictures/so_assembly_pre_gantry_z_axis_2.jpg
