shapeoko/Docs/content/tPictures/so_wasteboard_assembled_2.jpg

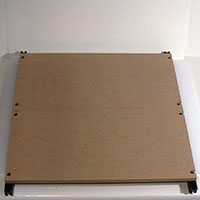
content/tPictures/so_wasteboard_assembled_2.jpg
