shapeoko/Docs/content/tPictures/so_z_assembly_8.jpg

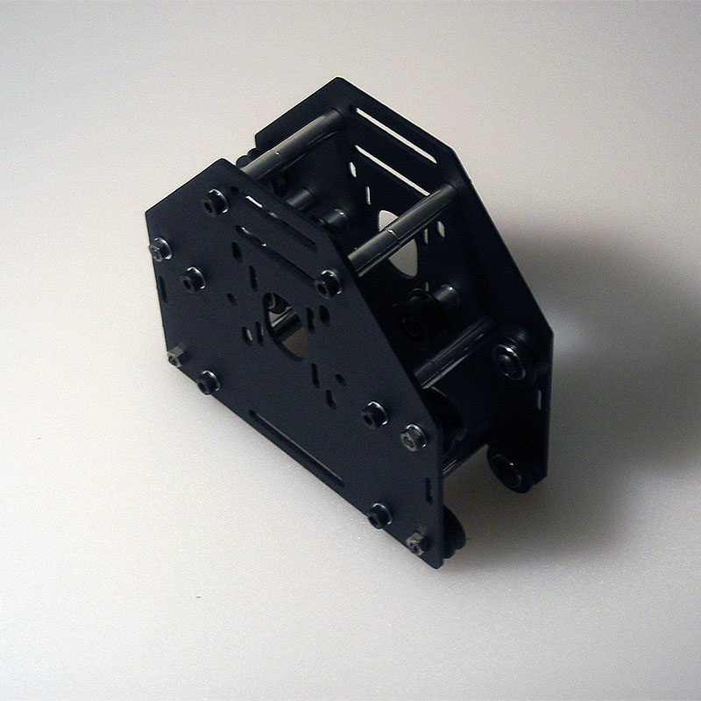
content/tPictures/so_z_assembly_8.jpg
