shapeoko/Docs/content/wiring/35-so_wiring-034.jpg

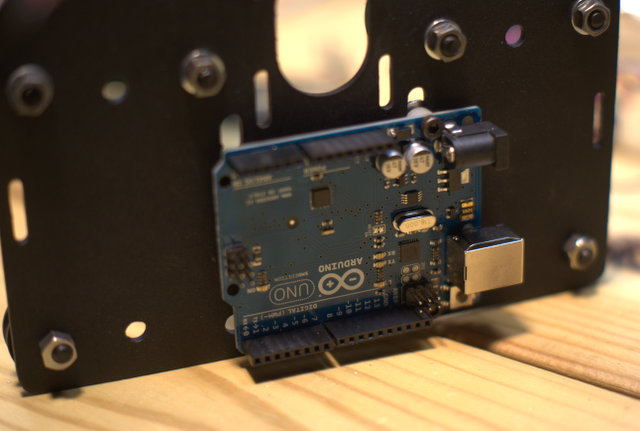
content/wiring/35-so_wiring-034.jpg
