shapeoko/Docs/content/wiring/37-so_wiring-036.jpg

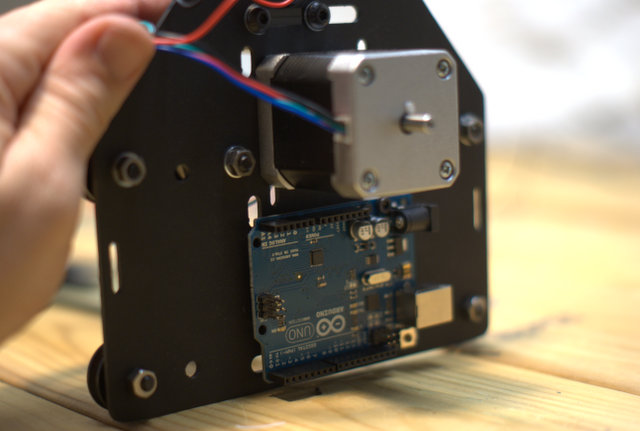
content/wiring/37-so_wiring-036.jpg
