shapeoko/Docs/content/wiring/42-so_wiring-041.jpg

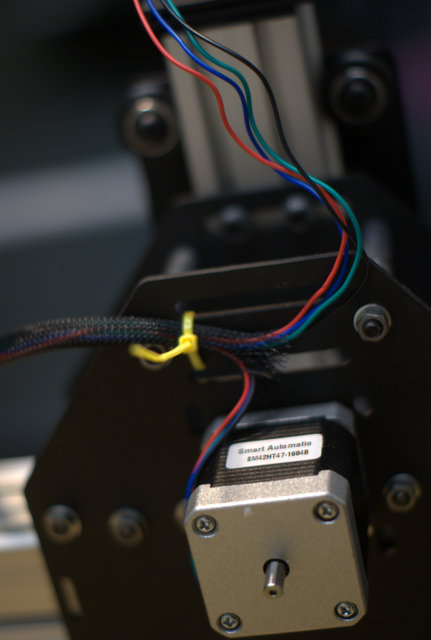
content/wiring/42-so_wiring-041.jpg
