shapeoko/Docs/content/wiring/45-so_wiring-044.jpg

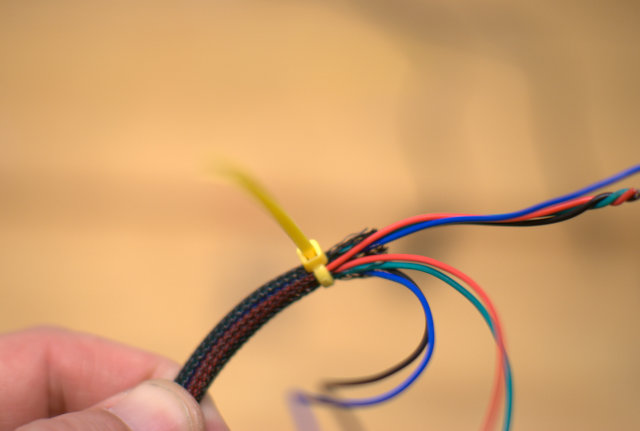
content/wiring/45-so_wiring-044.jpg
