shapeoko/Docs/content/wiring/48-so_wiring-047.jpg

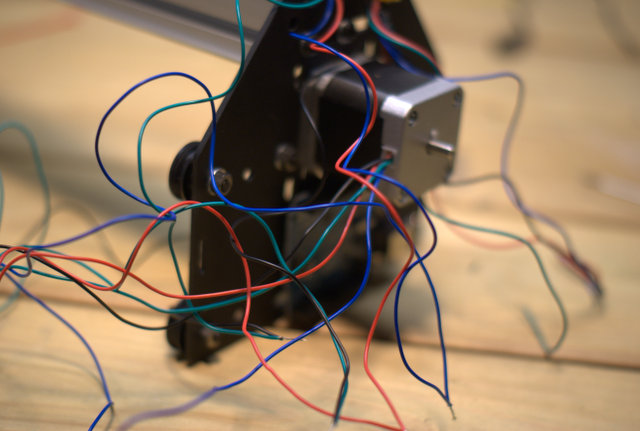
content/wiring/48-so_wiring-047.jpg
