shapeoko/Docs/content/wiring/53-so_wiring-052.jpg

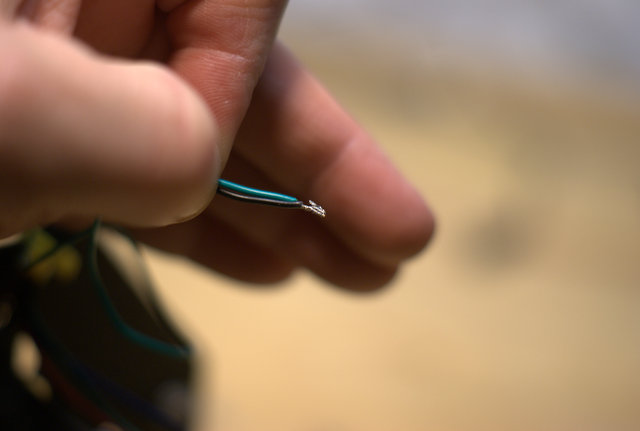
content/wiring/53-so_wiring-052.jpg
