shapeoko/Docs/content/wiring/56-so_wiring-055.jpg

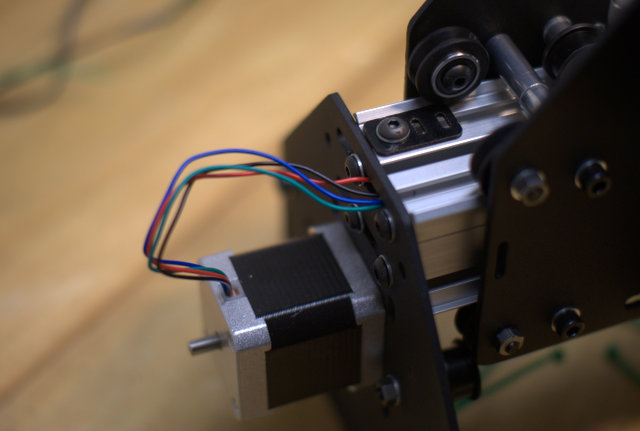
content/wiring/56-so_wiring-055.jpg
