shapeoko/Docs/content/wiring/64-so_wiring-063.jpg

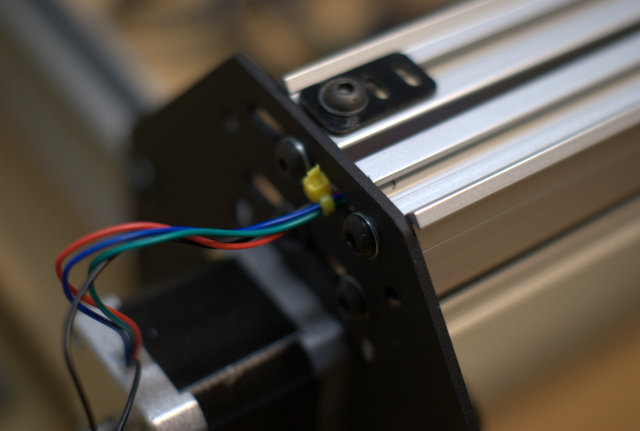
content/wiring/64-so_wiring-063.jpg
