shapeoko/Docs/content/wiring/65-so_wiring-064.jpg

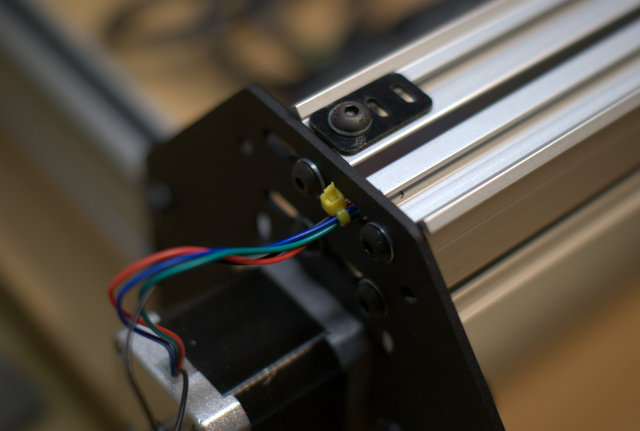
content/wiring/65-so_wiring-064.jpg
