shapeoko/Docs/content/wiring/69-so_wiring-068.jpg

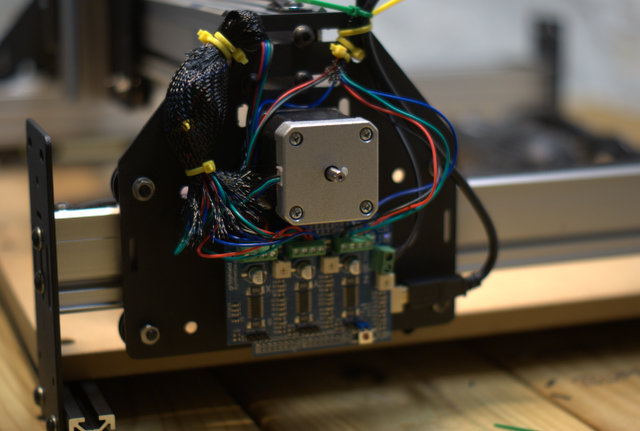
content/wiring/69-so_wiring-068.jpg
