shapeoko/Docs/content/wiring/70-so_wiring-069.jpg

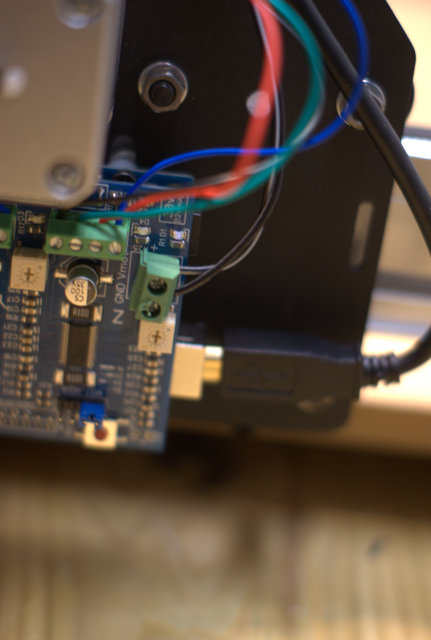
content/wiring/70-so_wiring-069.jpg
