shapeoko/Docs/content/wiring/71-so_wiring-070.jpg

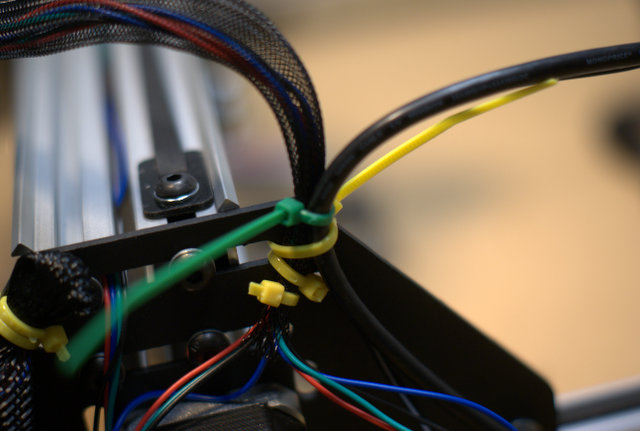
content/wiring/71-so_wiring-070.jpg
