shapeoko/Docs/content/wiring/73-so_wiring-072.jpg

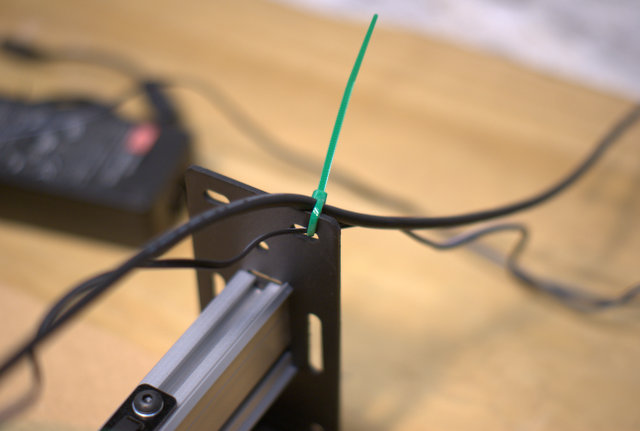
content/wiring/73-so_wiring-072.jpg
