shapeoko/Docs/content/wiring/74-so_wiring-073.jpg

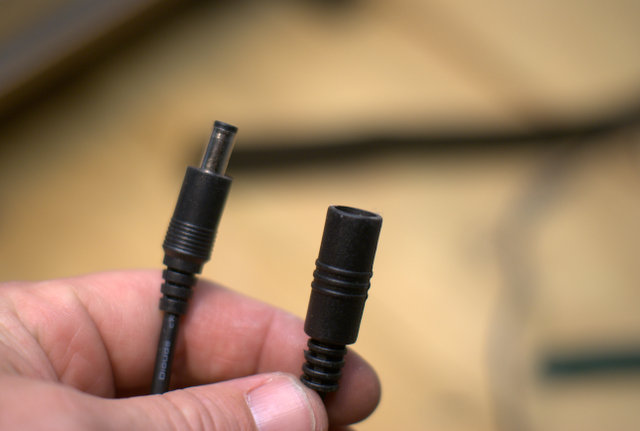
content/wiring/74-so_wiring-073.jpg
