shapeoko/Docs/content/wiring/75-so_wiring-074.jpg

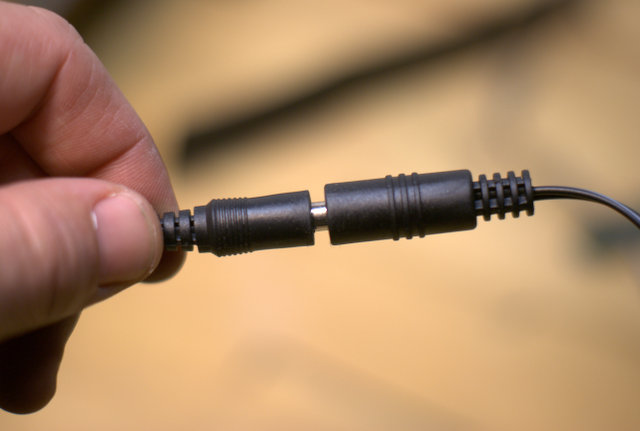
content/wiring/75-so_wiring-074.jpg
