shapeoko/Docs/content/wiring/76-so_wiring-075.jpg

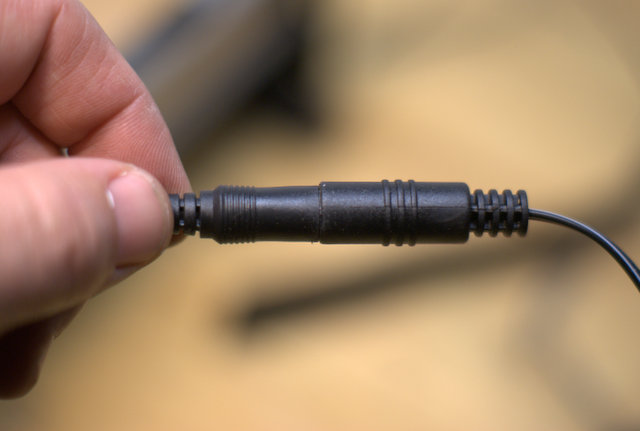
content/wiring/76-so_wiring-075.jpg
