shapeoko/Docs/content/wiring/77-so_wiring-076.jpg

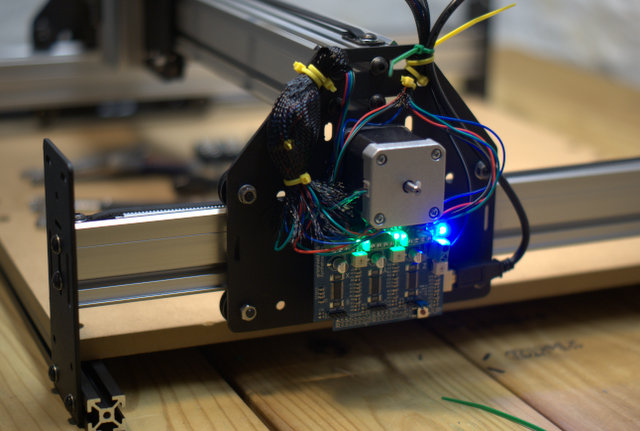
content/wiring/77-so_wiring-076.jpg
