shapeoko/Docs/content/wiring/right_rendered_view.png

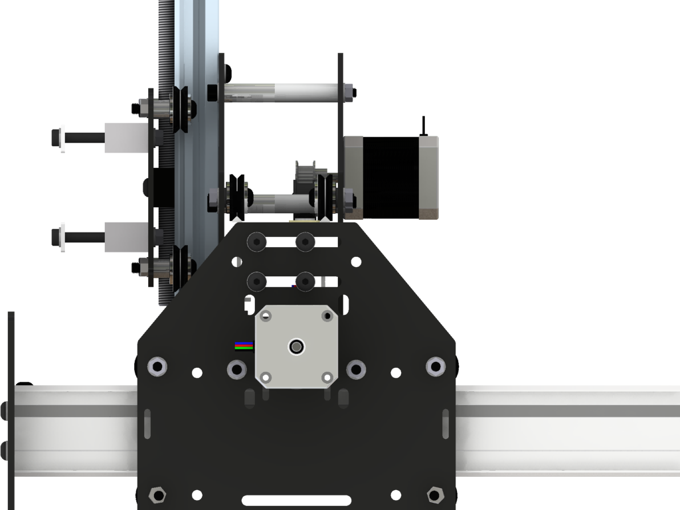
content/wiring/right_rendered_view.png
