shapeoko/Docs/content/tPictures/testgraphics.tex

\documentclass{article}

\usepackage{graphicx}
\usepackage{grffile}

\newcommand{\testgraphic}[1]{\noindent{%



\par
\noindent#1\par
\bigskip}}

\begin{document}

\testgraphic{PS20021}
\testgraphic{PS20022}
\testgraphic{PS20023}
\testgraphic{PS20024}
\testgraphic{PS20025}
\testgraphic{PS20026}
\testgraphic{PS20028}
\testgraphic{PS20029}
\testgraphic{PS20030}
\testgraphic{PS20031}

\end{document}
