shapeoko/Docs/content/tPictures/e_test_tools_1.jpg

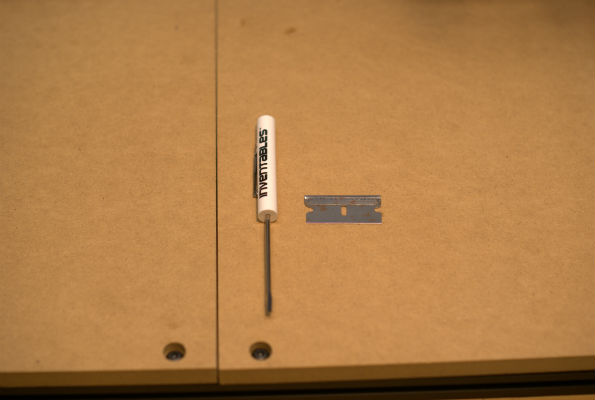
content/tPictures/e_test_tools_1.jpg
