shapeoko/Docs/content/wiring/front_right_rear_views.pdf

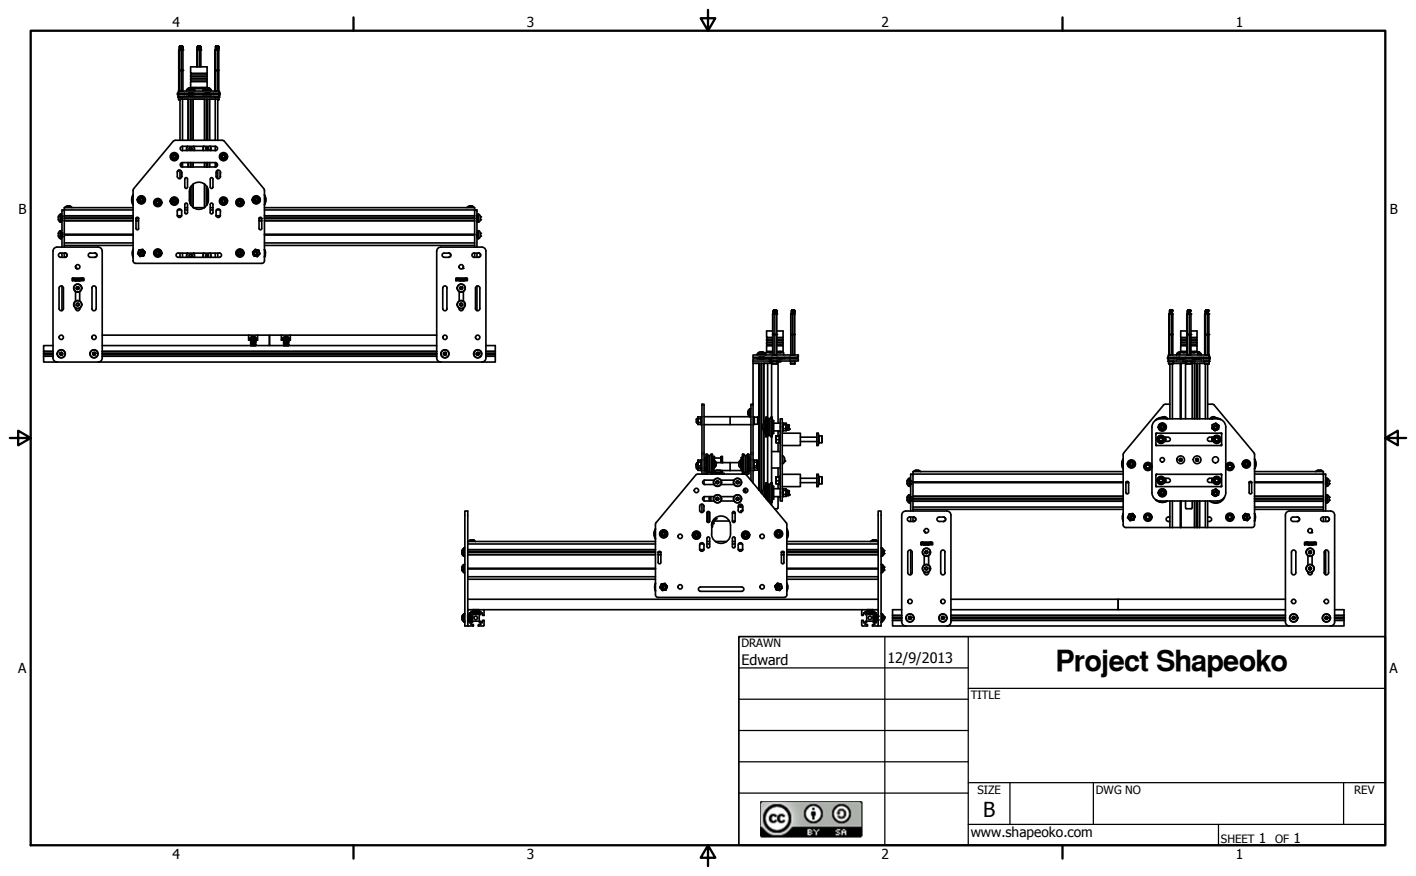
[picture p346: page 1]
SHEET 1 OF 1; DRAWN; Edward; DWG NO; TITLE; SIZE B; www.shapeoko.com; REV; 2TQLGEV 5JCRGQMQ
