shapeoko/Docs/(commit log)

2013-12-06 committing original files
    these are the larger res files that are not currently linked.
2013-12-06 changing to index.html
    The overview page is now the main landing page for the docs.
2013-12-06 creating landing page
2013-12-06 adding sketch renders
    each part and each assembly has their own sketch render. these can be
    used anywhere in the documentation
2013-12-06 adding grbl info to hello world
2013-12-07 testing non-jk powered site
    dropping static html files in...
2013-12-07 adding grbl settings to software page
2013-12-07 adding power connection closeup
2013-12-08 adding arduino install images
    images from windows install process
2013-12-08 how to configure grbl through ugs
2013-12-08 switch filename back to correct one
2013-12-09 adding wiring overview
2013-12-09 adding wiring images
2013-12-09 adding addition wiring options
2013-12-09 adding html wiring files
2013-12-09 adding links to detailed wiring options
2013-12-09 adding images to firstjob links to wiring
2013-12-09 adding images for wiring option 3
2013-12-09 adding views for wiring
2013-12-09 fix broken image links caused by wrong case in filenames
2013-12-09 making wiring_3 html dynamic
2013-12-09 adding wiring 3 content
2013-12-09 adding another view for wiring 3
2013-12-09 more wiring instructions for option 3
2013-12-09 adding generic wireframe views for content creators
2013-12-09 adding wiring overview, stepper orientation, more
2013-12-10 adding wiring overview to option 1
2013-12-10 making wiring1 dynamic, adding include header
2013-12-11 minor edits, test image linking on Z-axis page
2013-12-11 making wiring2 dynamic header
2013-12-11 changing wires to curves
2013-12-11 making wiring3 dynamic header
2013-12-11 tidy up wiring1
2013-12-11 rounded wiring
2013-12-12 add 8mm wrench
2013-12-13 adding note about wiring options to main page
2013-12-13 adding assembly steps overview
    also moved tool listings to tips page
2013-12-13 adding rendered views for wiring
2013-12-13 adding right rendered view for wiring illustration
2013-12-13 adding terminal block wiring overview
2013-12-13 adding belt clip instructions
2013-12-14 Fix typos, review links, minor formatting fixes
    (I think we should always put a blank carriage return in-between a head
    and the following paragraph)
2013-12-14 try image links on wheels again
2013-12-14 Move belt anchoring instructions to workarea
2013-12-14 adding belt tightening instructions
2013-12-15 upload (dis)assembly images
2013-12-16 add note on wheel/idler positioning.
2013-12-16 add another option for attaching the pen
2013-12-17 Finally begin wiring in ernest
2013-12-17 fix wording, re-arrange, more reasonable suggestion for tensioning belts
2013-12-17 add second diagram for Z-axis
2013-12-17 re-arrange, fix head broken by noting having blank para above.
2013-12-18 add heat shrink tubing
2013-12-18 or reconfigure Grbl
2013-12-18 add heat source
2013-12-18 fix typos, add heat source, paragraph returns
2013-12-19 wiring graphics
2013-12-19 add graphics to wiring_2
2013-12-19 add note on photos and wiring diagram
2013-12-19 add links to scaling up, cable management, text on size considerations
2013-12-19 add note on ``drain wire''
2013-12-19 add note on terminal blocks, options and drain wire.
2013-12-20 add note on assembled vice sub-assemblies
2013-12-20 add Next step Carriages
2013-12-20 add Next Step Gantry
2013-12-20 add see below, next step wiring
2013-12-20 add next step, not on motor lead length
2013-12-20 add next step, Wheels & Idlers
2013-12-21 add stepper power safety note
2013-12-21 add pulley
2013-12-21 add stepper power wiring note
2013-12-21 zip ties instead of M3 screws for mounting
2013-12-21 heat shrink optional
2013-12-22 add note on mounting the tool
2013-12-24 emphasize wiring order
2013-12-24 simulate drag chain
2013-12-24 re-word, add tapping and belts
2013-12-24 desire enclosure
2013-12-24 xyz wiring graphics
2013-12-24 add note on wire length
2013-12-28 Add note on $5 Z-axis value
2013-12-29 add missing para
2013-12-29 the bearing will still show
2014-01-01 point out the power connector may be green or blue
    some pictures show a blue power connector on the shield, others show green. Mine was green so just updating the text so folks aren't looking for a blue header to put the wires into.
2014-01-01 adding some detail on how to Jog each axis
    just adding a few words on how to find the buttons to jog the axes using the Universal Gcode sender
2014-01-01 Tighten coupler set screws
2014-01-02 Fix incorrect part reference
    The parts manifest (from the full kit), lists 25312-20 as a 1" spacer, not a 1-1/4" spacer. The kit contained a 1" spacer and the diagram indicates that the spacers should be slightly different.
2014-01-02 12 not 10 M5 washers for spindle carriage assembly
2014-01-05 Eccentric nut update as suggested by pwclay
2014-01-05 gantry belt
2014-01-21 Update zaxis.md
    The number of M5 x 70mm SHCS should be 6, not 4.
2014-01-22 add Bmsleight's note on baud rate
2014-01-25 add note on pulleys and shafts and grinding
2014-01-25 Z-axis stand-offs
2014-01-26 update text per bmsleight's pull request
2014-01-26 improve gantry assembly instructions, add belt anchor images
2014-01-26 finish z-axis update
2014-01-28 note power to gShield per mmorlan62's forum post
2014-01-29 8 or 6mm
2014-01-30 equal tension
2014-01-31 add stepper motor
2014-02-01 Reversing using Grbl
2014-02-01 add note on thread lock
2014-02-04 There are four spacers
2014-02-07 Remove extraneous bracket
2014-02-13 bang on a drum (or wheel)
2014-02-13 Z-axis 2.5 or 3.5"
2014-02-14 add additional note on drivers
2014-02-21 add note on plastic nut
2014-02-22 Delrin nut
2014-02-28 add notes on orientation of V-wheels
2014-03-02 belt anchor reminder
2014-03-09 make wiring images greyscale
2014-03-11 spindle carriage plate details
2014-03-11 Add Grbl settings as text
    per http://www.shapeoko.com/forum/viewtopic.php?f=12&t=2904&p=21886
2014-03-12 material world
2014-03-14 how tight the V-wheels are
2014-03-14 two PS20026 assemblies
2014-03-15 no M5 washer for belt anchors
2014-03-15 end mill, javascript
2014-03-16 finish one diagram, update Wheels
2014-03-19 carriage plate diagrams
2014-03-20 driver serialization
2014-03-21 debris on threads
2014-03-22 spindle mount plate diagram
2014-03-22 Auto-scaling spindle mount plate
2014-03-22 fix Z-axis carriage plate errors CV noted
2014-03-24 add assembly troubleshooting link
2014-03-24 add note on how far the motor shaft should go
2014-03-26 Threads on the end of the Z-axis MakerSlide
2014-03-26 Thread the MakerSlide for the gantry
2014-03-26 minor corrections and tightening up of wording.
2014-03-26 flexible, not versatile---wiring only does 1 thing
2014-03-27 My power terminal is green like the others.
2014-03-28 spell out button head cap screw per Meanderbolt's suggestion
2014-03-28 Try to make wiring more obvious but less intrusive
    per discussion w/ Meanderbolt on the Forums
2014-03-28 Further wiring updates, fix typos
2014-03-28 user decides, foam mounting strips
2014-03-28 Update carriages.md
    Some type changes to improve consistency and to elaborate where I came unstuck with my build.
    (RobCee)
2014-03-28 Update wheels.md
    Capitalisation
2014-03-28 Update wiring.md
    Expand SHCS
2014-03-28 Update yaxis.md
    Threading wording
2014-03-28 Update gantry.md
    Thread wording
2014-03-29 Re-order steps to make assembly easier.
2014-04-04 remove phr0ze's suggestion to the gantry page
2014-04-05 12V not 24V
2014-04-19 updated UGS to current version (1.0.7) link
2014-04-27 don't lose the set screws
2014-04-28 clarify, try to save copies of Grbl from blinking
2014-05-01 threads and fit
2014-05-01 note tolerance of laser-cut parts and powder-coat
    http://www.shapeoko.com/forum/viewtopic.php?f=10&t=3366&p=25342
2014-05-08 square Y-axis
2014-05-08 Add 'http://' to links in helloworld.md
    Links to 'Assembly Troubleshooting on the wiki' and 'Fine Tuning' at the bottom of the 'helloworld.md' page were missing 'http://' at the beginning so they were trying to resolve to
    http://docs.shapeoko.com/www.shapeoko.com/wiki/index.php/Assembly_troubleshooting
    http://docs.shapeoko.com/www.shapeoko.com/wiki/index.php/Tuning
    which didn't work!
2014-05-09 Y-axis pulley loosen and tighten
2014-05-11 note thread pitch on M8 rod
2014-05-12 note that it's an assembly.
2014-05-17 motor placement redux
2014-05-19 fine tune, calibrate or get out of the way.
2014-05-23 add current link
2014-07-25 add note on troubleshooting bearings
    http://www.shapeoko.com/forum/viewtopic.php?f=10&t=3868&p=29096&sid=9cc75048ed568badf3e3849cdef519e1#p29096
2014-07-25 Create stest.html
    testing strapdownjs
2014-09-21 spindle mounting
2014-10-19 Add back wiring.html
2014-10-20 Add monospaced font for code
    Although honestly I think it already was…
2014-11-14 Update spindle carriage graphics
2014-11-14 Update Z-axis --- not sure 'bout helloworld2mm.nc
2014-11-16 Lucinda Bolts
    per Robcee's suggestion on the forum: http://www.shapeoko.com/forum/viewtopic.php?f=10&t=4605&p=34202&sid=b18ed558c06b738fdc7284d1655745f9#p34202
2014-11-18 no load-bearing
2014-11-30 finish carriages
2015-02-03 redraw carriage plate graphic
